greiginsydney/Intervalometerator/Raspberry Pi/default_image.JPG

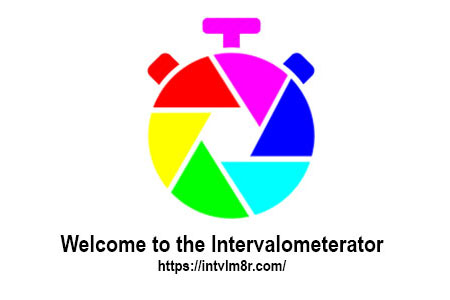
Raspberry Pi/default_image.JPG
