greiginsydney/Intervalometerator/docs/step1-setup-the-Pi.md

# Setup the Pi

If you're starting from scratch, start here at Step 1.

1. Prepare the memory card with the [32-bit Raspberry Pi OS 'Lite'](https://www.raspberrypi.org/software/operating-systems/) image. You want the "a port of Debian Trixie [or Bookworm] with no desktop environment" version.

> The ["Raspberry Pi Imager"](https://www.raspberrypi.org/software/) app can download and write the image to a memory card for you quickly and easily.

<p align="center">

 </p>

<p align="center">



</p>

2. Add HDMI, power and keyboard connections and turn it on. (You don't need a mouse for this, but add one if you're feeling so inclined).
3. The boot process ends at a login screen. The default credentials are `pi` / `raspberry`.
4. Login.
5. Now we'll perform the basic customisation steps:
6. Run `sudo raspi-config`.
7. Select `(5) Localisation Options` then:
    * `(L3) - change keyboard layout`
    I've never needed to do anything but accept the defaults here. I found the Pi stopped responding for >10s after selecting "no compose key", so just wait for it and it will take you back to the main page.
8. Return to (5) and set `(L2) the timezone`. Select the appropriate options and you'll be returned to the menu.
9. Select `(3) - Interfacing Options`
    * `(P2) Enable SSH` and at the prompt "Would you like the SSH server to be enabled?" change the selection to `<Yes>` and hit return, then return again at the `OK`.
    
10. This step intentionally left blank. ;-)
11. Select `(1) System Options` and `(S4) Hostname` and give the Pi a recognisable hostname.
12. If you're building this onto a Pi with a wired network connection instead of WiFi, skip the next step. Resume at Step 14.
13. Select `(1) System Options` and `(S1) Wireless LAN`. At this stage we'll be a wifi *client*. When prompted:

    * Select your country
    * Enter the local SSID and passphrase (password). Note that the Pi Zero W's radio is limited to 2.4G, so any attempts to connect to a 5G network will fail.
14. Navigate to `Finish` and DECLINE the prompt to reboot.
15. Run `ifconfig`. In the output, look under "eth0" for wired and "wlan0" for WiFi. There should be a line starting with "inet" followed by an IP address. The absence of this means you're not on a network.

16. Assuming success above, you'll probably want to set a static IP. If you're OK with a dynamic IP (or at least are for the time being) jump to Step 19 and a reboot.

17. From 'Bookworm', the Pi uses Network Manager to manage IP addresses.\[[1](#1-set-a-static-ip-address-on-raspberry-pi-os-bookworm)\]

18.1 Run `sudo nmcli -p connection show` to show the available network interfaces:

```txt
pi@raspberrypi:~ $ sudo nmcli -p connection show
======================================
  NetworkManager connection profiles
======================================
NAME              UUID                                  TYPE      DEVICE
----------------------------------------------------------------------------------------------------------------
mywifissid        09123456-6ac4-4cf7-8154-701234567892  wifi      wlan0
lo                5612345d-ffff-4ee8-8ef9-12345678990f  loopback  lo
pi@raspberrypi:~ $
```

18.2 Now execute these three commands in turn, replacing the network name and dummy values here with your own:

```txt
sudo nmcli con mod "mywifissid" ipv4.addresses 10.0.0.220/24 ipv4.method manual
sudo nmcli con mod "mywifissid" ipv4.gateway 10.0.0.1
sudo nmcli con mod "mywifissid" ipv4.dns "10.0.0.1"
```

> If you have more than one DNS server (the last command above), add them all inside the quotes with a space separating each.

19. Reboot the Pi to pickup its new IP address and lock in all the changes made above, including the change to the hostname: `sudo reboot`

20. After it reboots, check it's on the network OK by typing `ifconfig` and check the output now shows the entries you added in Step 18.2.
(Alternatively, just see if it responds to pings and you can SSH to it on its new IP).

## Remote config via SSH

At this point I abandoned the keyboard and monitor, continuing the config steps from my PC.

21. SSH to the Pi using your preferred client. If you're using Windows 10 you can just do this from a PowerShell window: `ssh <TheIpAddressFromStep18> -l pi` (Note that's a lower-case L).
22. You should see something like this:
```txt
The authenticity of host '192.168.44.1 (192.168.44.1)' can't be established.
ECDSA key fingerprint is SHA256:Ty0Bw6IZqg1234567899006534456778sFKT6QakOZ5PdJk.
Are you sure you want to continue connecting (yes/no)?
```
23. Enter `yes` and press Return
24. The response should look like this:
```txt
Warning: Permanently added '192.168.44.1' (ECDSA) to the list of known hosts.
pi@192.168.44.1's password:
```
25. Enter the password and press Return.
26. It's STRONGLY recommended that you change the password. Run `passwd` and follow your nose.

## Here's where all the software modules are installed. This might take a while:

27. First let's make sure the Pi is all up-to-date:
```txt
sudo apt-get update && sudo apt-get upgrade -y
```

> If this ends with an error "Some index files failed to download. They have been ignored, or old ones used instead." just press up-arrow and return to retry the command. You want to be sure the Pi is healthy and updated before continuing.

> If however you encounter an error saying a certificate is out of date or not valid yet, check that the Pi's real-time clock is correct. `date` on its own will show the date, and you'll set it with this syntax: `sudo date -s '2024-01-09 11:04:00 AEDT'`.

28. `sudo reboot`

Your SSH session will end here. Wait for the Pi to reboot, sign back in again and continue.

29.1 Confirm your current version of python:

```txt
python3 --version
```
The output should look like this, which confirms python 3.13 (ignore the .5):
```txt
Python 3.13.5
```
(The above is correct for Trixie. Bookworm will report 3.11.2. The process is the same but adjust the number below accordingly.)

29.2 Update the following command if required with that of the same version number:

```txt
sudo apt install python3.13-venv -y
```
```txt
python3 -m venv venv
```
```txt
source venv/bin/activate
```

30. We need to install git so we can download the repo from GitHub:

```
sudo apt-get install git -y
```

29.4. This downloads the repo, dropping the structure into a subdirectory called `Intervalometerator`:

```txt
cd ~
git clone --depth=3 https://github.com/greiginsydney/Intervalometerator
```

> Advanced tip: if you're testing code and want to install a new branch direct from the repo, add `-b <branchName>` on the end of the line.

30. Now we need to move the setup.sh script file into its final location:

```txt
mv -fv "Intervalometerator/Raspberry Pi/setup.sh" ~
``` 

31. All the hard work is done by the script, but it needs to be made executable first:

```txt
sudo chmod +x setup.sh
```

32. Now run it!
```txt
sudo ./setup.sh start
```

33. First up you'll be presented with a menu to choose which of the upload/transfer options to install:

```txt
====== Select Upload/Transfer options =======
An 'X' indicates the option will be installed

1. [X] SFTP
2. [X] Dropbox
4. [X] rsync

Press 1, 2 or 4 to toggle the selection.
Press return on its own to continue with the install
```

Accept the defaults just by pressing return on its own, or choose 1, 2 or 4 (then return) to de-select the options that aren't relevant to you. (You can always install them later if the need arises).

> If you choose ALL the options (the default), this step now takes **over an hour** to complete, depending on how slow your Internet connection is. (As at March 2020.) SFTP is the real time-killer here.

> If any step fails, the script will abort and on-screen info should reveal the component that failed. You can simply re-run the script at any time (up-arrow / return) and it will simply skip over those steps where no changes are required. There are a lot of moving parts in the Raspbian/Linux world, and sometimes a required server might be down or overloaded. Time-outs aren't uncommon, hence why simply wait and retry is a valid remediation action.

> If libgphoto throws errors, run `apt-cache search libgphoto2` & it should reveal the name of the "development" version, which you will need to edit back into the script before your repeat attempt at this step.

33.1 It's a rare occurrence, but you might encounter this redis prompt:

```txt
Configuration file '/etc/redis/redis.conf'
 ==> Modified (by you or by a script) since installation.
 ==> Package distributor has shipped an updated version.
   What would you like to do about it ?  Your options are:
    Y or I  : install the package maintainer's version
    N or O  : keep your currently-installed version
      D     : show the differences between the versions
      Z     : start a shell to examine the situation
 The default action is to keep your current version.
*** redis.conf (Y/I/N/O/D/Z) [default=N] ?
```

The correct response is 'Y': we'll accept the new version. (The setup script will reinstate the customisation later).

34. If all goes well, you'll be presented with a prompt to reboot:
```txt
Exited install_apps OK.
Reboot now? [Y/n]:
```
Pressing return or anything but n/N will cause the Pi to reboot.

35. After the Pi has rebooted, sign back in again and resume. The next step is to re-run the script, but with a new switch:
```txt
sudo ./setup.sh web
```

36. The script will now move some of the supporting files from the repo to their final homes, and edit some of the default config in the Pi. 

It will output its progress to the screen:
```txt
pi@raspberrypi:~ $ sudo ./setup.sh web
mkdir: created directory 'photos'
mkdir: created directory 'preview'
mkdir: created directory 'thumbs'
'intvlm8r.service' -> '/etc/systemd/system/intvlm8r.service'
'intvlm8r' -> '/etc/nginx/sites-available/intvlm8r'
```

37. You will be asked to provide a username and password for the web interface. The default login name is 'admin', and the script generates a random 8-character password of four letters and four numbers. Accept the defaults if you like, but preferably come up with your own. (You should DEFINITELY change these for longer, more complicated ones if the intvlm8r is connected to the Internet or a network where anyone else might find it.)

```txt
Change the website's login name: admin
Change the website's password  : abcd1234
```

38. If your Pi will have no network connectivity once it's deployed, it will need its real time clock set each time it boots (as the clock is volatile - it's not battery-backed). 

```txt
NTP is currently active. NTP is our master time source.

Does the Pi have network connectivity?
If so, can we use NTP as our master time source? [Y/n]:
```

If you respond 'n' to the prompt, the script will disable the Pi's internal NTP Client. The provided "setTime.py" script will run when-ever the Pi boots, reading the real time from the Arduino and using this to set the Pi's own internal clock.

If you respond 'Y', the Pi shall query an NTP source at boot and also at 3:30am each day, updating the Arduino with the correct time. (The overnight update only applies if the Pi is set to always run, and captures any changes that might have been made due to Daylight Saving Time ahead of the next day's shooting).

>You can change this at any time by running `sudo ./setup.sh time`.

39. If all goes well, you'll be presented with a prompt to reboot:
```txt
Exited install_website OK.
Reboot now? [Y/n]:
```
Pressing return or anything but n/N will cause the Pi to reboot.

40. You're in business!  After the Pi reboots you should be able to browse to its IP address, where you'll be presented the message "You need to sign in before you can access that page!" and the login form.

41. Login with the credentials you set in Step 37. You can change those or add new login/password pairs by editing the /www/intvlm8r.py script.

## Next steps are:
- Add an SSL certificate:
	- [Use Lets Encrypt](/docs/step2-setup-the-Pi-lets-encrypt.md)
	- [Public or Private PKI](/docs/step2-setup-the-Pi-public-or-private-pki.md)
- [Setup the Pi as a Wifi Access Point](/docs/step3-setup-the-Pi-as-an-access-point.md)

<br>

## References
#### [1] [Set a static IP Address on Raspberry Pi OS Bookworm](https://www.abelectronics.co.uk/kb/article/31/set-a-static-ip-address-on-raspberry-pi-os-bookworm)
<hr >
