greiginsydney/Intervalometerator/docs/FAQ.md

# Frequently Asked Questions

- [Where do I change the website's login name and/or password?](https://github.com/greiginsydney/Intervalometerator/blob/master/docs/FAQ.md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)
- [How can I add more users to the list of website logins?](https://github.com/greiginsydney/Intervalometerator/blob/master/docs/FAQ.md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)
- [Can I move the intvlm8r off port 80 or 443?](https://github.com/greiginsydney/Intervalometerator/blob/master/docs/FAQ.md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)
- [My camera and/or Pi are running low on storage. How can I delete old images?](https://github.com/greiginsydney/Intervalometerator/blob/master/docs/FAQ.md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)
- [Can I copy/transfer images more than once per day?](https://github.com/greiginsydney/Intervalometerator/blob/master/docs/FAQ.md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)
- [Can I pause the shooting schedule during the day (e.g. at lunchtime)?](https://github.com/greiginsydney/Intervalometerator/blob/master/docs/FAQ.md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)
- [Does the intvlm8r support Daylight Saving Time?](https://github.com/greiginsydney/Intervalometerator/blob/master/docs/FAQ.md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)
- [Can I install the intvlm8r under another user, not 'pi'?](https://github.com/greiginsydney/Intervalometerator/blob/master/docs/FAQ.md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)
- [Can the intvlm8r connect to multiple WiFi networks?](https://github.com/greiginsydney/Intervalometerator/blob/master/docs/FAQ.md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)
- [Why can't I set the camera's time correctly?](https://github.com/greiginsydney/Intervalometerator/blob/master/docs/FAQ.md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)

<br>

<hr>

## Where do I change the website's login name and/or password?

If you only have one login (the default configuration), you can use the setup script with the "login" switch. This prompts you to change the _first_ login in the file:

```text
pi@Model3B:~ $ sudo ./setup.sh login
Change the website's login name: admin1
Change the website's password  : password1
"exit 0" command failed with exit code 0.   <-- ignore this. An exit code of 0 is good in Python-land.
pi@Model3B:~ $
```

The alternative is to manually edit the main python script (`sudo nano ~/www/intvlm8r.py`). Around line 120 is "# Our user database".

<br>

[Top](https://github.com/greiginsydney/Intervalometerator/blob/master/docs/FAQ.md)

## How can I add more users to the list of website logins?

This is done by adding new lines to the main python script (`sudo nano ~/www/intvlm8r.py`). Around line 120 is "# Our user database".

Add more users in this format:

```text
# Our user database:
#users = {'admin': {'password': '### Paste the hash of the password here. See the Setup docs ###'}}
users = {'admin': {'password': 'password'}}
users.update({'superuser': {'password': 'godmode'}})
users.update({'someoneElse': {'password': 'rand0mCharact3rs'}})
```
<br>

[Top](https://github.com/greiginsydney/Intervalometerator/blob/master/docs/FAQ.md)

## Can I move the intvlm8r off port 80 or 443?

Yes! It's as simple as changing the "listen" line in `/etc/nginx/sites-enabled/intlm8r` to the new port number. Oh, and don't forget to open the firewall and/or add a NAT translation rule for it.

In this example the intvlm8r now listens on port 8000:

```text
server {
    listen 8000 default_server;
    server_name intvlm8r intvlm8r.yourdomainname.com;

    location / {
        include proxy_params;
        proxy_pass http://unix:/home/pi/www/intvlm8r.sock;
    }
}
```
<br>

[Top](https://github.com/greiginsydney/Intervalometerator/blob/master/docs/FAQ.md)

## My camera and/or Pi are running low on storage. How can I delete old images?

### My camera is running low on storage

If you want to delete ALL the images from the camera, Jim's provided an example script that will do this, and I've created a symbolic link to his examples folder.

SSH to the Pi and login with your username (usually 'pi', without the quotes), and the password. If you skipped the step to change this, it will still be 'raspberry'.

Run these two commands: 

```bash
cd ~/examples
sudo python3 clear-space.py 95
```

The number after clear-space.py tells the script to keep deleting files until that percentage of space is free. I recommend you DON'T choose 100, because that's potentially unachievable and could cause the script to lock up.
<br>

[Top](https://github.com/greiginsydney/Intervalometerator/blob/master/docs/FAQ.md)

### Enable 'DeleteAftercopy' or 'DeleteAfterTransfer'

Hidden config options (stored in the INI file) will let you delete images off the camera after they've been safely transferred to the Pi, and after they've been safely uploaded to your nominated "off-box" destination.

This option isn't visible in the browser, so to change it you need to SSH to the Pi and edit the file there manually:
1. Edit the file intvlm8r.ini with `sudo nano ~/www/intvlm8r.ini`
2.	This opens the file in a basic text editor. Note that you can’t use your mouse, only the arrow keys to move around
3.	Move the cursor (which is usually at the top LH corner) to the end of the relevant 'DeleteAfter..' line – after the second ‘f’ in Off, then Backspace to delete the f’s and replace with an ‘n’. (Reverse that to change from On to Off)
4.	Type Control-X. The bottom of the screen will update to ask “Save modified buffer?”
5.	Press Y (on its own). The screen will prompt for the filename “File Name to Write: /home/pi/www/intvlm8r.ini”, which is giving you an opportunity to do a “Save As” and give it a new name. But we won’t.
6.	Hit return and you’re done.

Set the two highlighted options On or Off as required. If the option's not already there, just add the line in by hand, like in this example file:

<pre>
[Global]
file created = 05 Jan 2023
thumbscount = 20

[Transfer]
tfrmethod = Dropbox
dbx_token = thequickbrownfoxjumpsoverthelazydogorsomething
transferday = Daily
transferhour = 00
sftpserver = 20.20.20.20
sftpuser = intvlm8r
sftppassword = mysecretsftppassword
sftpremotefolder = upload/GreyBox/
<b>deleteaftertransfer = On</b>

[Copy]
copyday = Daily
copyhour = 00
<b>deleteaftercopy = On</b>
</pre>

<br>

[Top](https://github.com/greiginsydney/Intervalometerator/blob/master/docs/FAQ.md)

## Can I copy/transfer images more than once per day?

The web interface only supports one copy (from the camera) and transfer (from the Pi) per day, but it's easy to add more by adding extra occurrences to the "crontable".

> The only caveat here is that the Pi is set to "Always On" on the system maintenance page.

Here's what the crontable looks like by default:

``` python
pi@Model3B:~ $ crontab -l
0 * * * * /usr/bin/python3 /home/pi/www/cameraTransfer.py 2>&1 | logger -t cameraTransfer
0 * * * * /usr/bin/python3 /home/pi/www/piTransfer.py 2>&1 | logger -t piTransfer

```

The `0 * * * *` at the start of the line instructs the Pi to run python3 and the related script when minute = 0, every hour, every day. As defined here, the script runs at the top of every hour, checking if this hour and this day is the correct time to execute a copy or transfer before proceeding. If not, the script will exit and wait for the next hour.

You can edit the crontable with `crontab -e` and give it more things to do. Here I've added a copy at 15 minutes past the hour (every hour, every day), and a transfer at 15 minutes to:

```python
pi@Model3B:~ $ crontab -l
0 * * * * /usr/bin/python3 /home/pi/www/cameraTransfer.py 2>&1 | logger -t cameraTransfer
0 * * * * /usr/bin/python3 /home/pi/www/piTransfer.py 2>&1 | logger -t piTransfer

15 * * * * /usr/bin/python3 /home/pi/www/cameraTransfer.py copyNow 2>&1 | logger -t cameraTransfer
45 * * * * /usr/bin/python3 /home/pi/www/piTransfer.py copyNow 2>&1 | logger -t piTransfer
```

Note the trick is the addition of the 'copyNow' switch which forces the script to always copy/transfer, ignoring the value set in the web interface and read from the ini file.

> If you're using Nano as your editor, a quick way to copy a line is ^K then ^U. That deletes the line your cursor is on and reinstates it - but it leaves a copy on the 'clipboard' (to borrow a Windows term). Navigate to where you want the line copied and ^U again - but don't forget to change the time and add the copyNow switch.
<br>

[Top](https://github.com/greiginsydney/Intervalometerator/blob/master/docs/FAQ.md)

## Can I pause the shooting schedule during the day (e.g. at lunchtime)?

The browser interface and the underlying code in both the Pi and Arduino don't allow two time schedules per day, nor one schedule with a break for lunch, and it would require a significant re-write to accommodate this.

That being said, a "lunchtime kludge" exists in the Arduino code (from v4.0.1) that will deliver this functionality. As it's fixed in the Arduino it's not something that can be changed from the Pi or through the browser interface, so turning it on or off, or changing the duration of the lunch break will necessitate opening the intvlm8r case and connecting a programming cable to the Arduino. The Pi isn't aware if the "lunchtime kludge" is active, so its calculations of shots per day will be inaccurate as a result, although "Last Shot" and "Next Shot" will always show the correct values.

The "lunchtime kludge" is commented-out by default. If you want to pause shooting for lunch, just un-comment the final five lines shown below (the "if" loop) by deleting the double slashes ('//') at the start of each line. Set the value of `if (nextHour == 12)` to the hour that the lunch break starts, and then set `nextHour = 13;` and `nextShot = 59;` to be one minute before you want shooting to resume. (In this example, a 2-hour lunch break starts at noon.)

```
// Lunchtime kludge
  // Un-comment this code and set nextHour and nextShot values as appropriate
  //  if (nextHour == 12)
  //  {
  //     nextHour = 13;
  //     nextShot = 59;
  //  }
```

If you only want to break for an hour, you can delete the `nextHour = 13;` line altogether and leave the nextShot minute at 59. If you only want a 30 minute lunch, delete the `nextHour = 13;` line (or leave it commented-out), change `nextShot` to 29, and the shooting schedule will recommence from 30 minutes past the current hour.

> This code runs at the start of the lunch break and tricks the intvlm8r into thinking it's already taken the shots that it would have during lunch. It then sets the next alarm time - the next shot to be taken - for the time immediately after lunch.
<br>

[Top](https://github.com/greiginsydney/Intervalometerator/blob/master/docs/FAQ.md)

## Does the intvlm8r support Daylight Saving Time?

It depends.

If your intvlm8r is running off-grid, disconnected from the outside world, it relies on the battery-backed red ["DeadOn RTC"](https://www.sparkfun.com/products/10160) board as the master real-time clock, which is in itself not aware of timezone and thus when to adjust for DST. In such a config, manual intervention will be required as you enter and return from DST.

DST is catered for automatically if the intvlm8r has network connectivity, although this assumes you set the correct timezone in [setup step 8](https://github.com/greiginsydney/Intervalometerator/blob/master/docs/step1-setup-the-Pi.md) and answered Yes to the NTP question:

```python
NTP Step. Does the Pi have network connectivity? [Y/n]:
```

If the Pi is set to always run, a cron job that fires every day at midnight will perform a sync of the time and date from the Pi to the Arduino. Here's an example of that from the /home/pi/setTime.log file:

```python
2021/06/14 00:00:02 systemd-timesyncd = active. The Pi takes its time from NTP. Updating the Arduino to follow Pi time
2021/06/14 00:00:02 Response code = 200
2021/06/14 00:00:02 This is what I received: <p>Set Arduino datetime to 20210614000002</p>
2021/06/14 00:00:02 New Arduino time is 20210614000002
```
<br>

[Top](https://github.com/greiginsydney/Intervalometerator/blob/master/docs/FAQ.md)

## Can I install the intvlm8r under another user, not 'pi'?

Yes. Just create your new user (with `sudo adduser newusername`) before you start the install process.

By default a new user can't `sudo` things without needing to provide their password, which breaks the setTime script. To address this, run `sudo visudo` and add this line to the *bottom* of the file:

```
newusername  ALL=(ALL) NOPASSWD:ALL
```

This lets 'newusername' execute ALL commands without needing to constantly re-type their password. I'd like to be able to tighten it up, but haven't been able to find the right command/syntax for the script to be able to run correctly - and it's not for a lack of trying.

<br>

[Top](https://github.com/greiginsydney/Intervalometerator/blob/master/docs/FAQ.md)

## Can the intvlm8r connect to multiple WiFi networks?

Yes: this is a really useful way of being able to setup a new intvlm8r on your workbench and then take or ship it to site without needing to make further config changes.

### - Old method (up to Bullseye):

All you need to do is edit /etc/wpa_supplicant/wpa_supplicant.conf (`sudo nano /etc/wpa_supplicant/wpa_supplicant.conf`) and add the extra network(s), like shown in this example:

~~~ bash
ctrl_interface=DIR=/var/run/wpa_supplicant GROUP=netdev
update_config=1

network={
        ssid="myOfficeNetwork"
        psk=myWiFiPassword!
        priority=1
}

network={
        ssid="myCaptureSiteNetwork"
        psk=thisIsMyPassword
        priority=4
}
~~~

If you omit the 'priority' lines, both networks are deemed the same priority, and the Pi will use the one with the stronger signal. As shown here, if both networks are present, the "myCaptureSiteNetwork" will be used, as it has the numerically higher priority number.
<br>

### - New method (bookworm+):

bookworm and its successors use Network Manager Command Line Interface ('nmcli') for the administration of networks and network interfaces.

<TODO: a more detailed walkthrough here>

Reference: https://unix.stackexchange.com/a/547531/578745

[Top](https://github.com/greiginsydney/Intervalometerator/blob/master/docs/FAQ.md)

## Why can't I set the camera's time correctly?

You're not alone in finding this a challenge. The interaction of gphoto2, your camera, and the timezone set in the Pi can sometimes make it difficult to have the camera correctly reflect your local time.



When you check "Set camera date/time", the new time and date that are sent to the camera depend on how the camera and gphoto2 interact.

Canon cameras usually accept two methods, and the default method passes the Pi's time to the camera, _but as UTC instead of the local timezone_ and any timezone offset you specify on the page is ignored.

Selecting "Alt camera time mode" always passes the "adjusted date/time" to the camera, but sometimes this doesn't apply correctly and a whacky date - maybe decades out - is returned.

If neither of the above two methods work, here's another you can try:
1. Set the Pi's time to the required value for the camera, adjusting the timezone offset as required;
2. Set the camera's time with only the "Set camera date/time" checkbox selected;
3. If that's successful, reset the Pi back to your correct time.

If you're still having no luck, please raise an [issue](https://github.com/greiginsydney/Intervalometerator/issues) and I'll work with you to find a resolution. (Have you checked the camera's firmware is the latest version?)

[Top](https://github.com/greiginsydney/Intervalometerator/blob/master/docs/FAQ.md)
