greiginsydney/Intervalometerator/(threads)

Thread 4 (2018-11-21):

Design a PCB

greiginsydney, 2018-11-21:
Is there demand for a PCB (whether art or a completed/assembled board)?

greiginsydney, 2019-06-19:
Closing. The PCB is available now on eBay:
https://www.ebay.com.au/itm/Intervalometerator-time-lapse-controller-PCB-only/264353662332

greiginsydney, 2021-09-24:
The schematic is here:
https://github.com/greiginsydney/Intervalometerator/blob/master/docs/intvlm8r_v11.11_circuit.pdf

\- G.

Closed 2019-06-19.

Thread 8 (2018-11-21):

Add telemetry / health monitoring

greiginsydney, 2018-11-21:
Add some Azure IoT-style telemetry, so you can remotely monitor it. Generate an alarm if it stops taking photos or fails to report in.

cadpix, 2020-07-04:
This would be very useful, our Intvlm8r is running on solar in a remote location to see a building go up over two years. We have it working over 4G and we can access the UI (via remote.it) and it can upload the pics to dropbox which works well.
It would be great to be able monitor the system / battery voltage and set a low threshold warning so we can anticipate a 12v battery replacement if needed.
Our setup also utilises a PTC heater to defrost the front glass. This only draws around an amp and clears the frost in winter, being able to see some temp data would be useful for anticipating when to kick this in or maybe this could be switched on by the RPI in the future? We currently use a digital timer switch to switch the heat on but this would be a fantastic feature addition to the Intvlm8r.

aerialvideographyuk, 2021-04-07:
I am also trying to get things working over a 4g wifi dongle and over traditional wifi but without port forwarding.  I removed the fixed ip settings on the pi and installed remote.it on the pi.  I could then set up a connection for ssh, http on port 80 and https on port 443. everything appeared to be working fine as I was able to access the camera via remote.it and change settings etc.  However I then noticed that no photo's were getting transferred to dropbox. When I checked the photos have stayed on the camera and not gone to the pi.  attached are the cameraTransfer.log and the gunicorn.error files. Any help appreaciated.
[cameraTransfer.log.txt](https://github.com/greiginsydney/Intervalometerator/files/6274373/cameraTransfer.log.txt)
[gunicorn.error.txt](https://github.com/greiginsydney/Intervalometerator/files/6274375/gunicorn.error.txt)

greiginsydney, 2021-08-01:
Resolved with the addition of 'heartbeating' in release 4.2.0.

techydude, 2021-10-04:
Hey @cadpix , a few questions to clarify:

> It would be great to be able monitor the system / battery voltage and set a low threshold warning so we can anticipate a 12v battery replacement if needed.

(q1) are you saying you setup a system with a battery, no other forms of power input, and need to periodically go to site and replace the battery?  If so, have you had any (supre-system / offboard) means of ascertaining battery state-of-charge, or do you just work out after some time how long the battery lasts and adjust your site visit rate?

> Our setup also utilises a PTC heater (common in security cameras and cheap too!) to defrost the front glass on the housing. This only draws around an amp and clears the frost in winter, being able to see some temp data would be useful for anticipating when to kick this in or maybe this could be switched on by the RPI in the future? We currently use a digital timer switch to switch the heat on but this would be a fantastic feature addition to the Intvlm8r.

(q2) 1 Amp * battery voltage (whatever that is, let's say a 12V SLA) is 12 Watts, which is an awful lot.  Do you have some way to only turn this front glass heater on just (a few minutes?) before a shot's about to be taken?  Or do you leave it on permanently when the weather's cold? (which suggests you need an effing big battery in winter! lol)

(q3) temp sensing:  do you want to know the tempeature inside the box, or outside the box, or both?  (I think Greig's add in a internal temp sensor telemetry in recent released, long after you posted your comment) in terms of estimating the need to apply a heater to the glass, I suspect you'd need to know both temps, and perhaps the humidity inside the box too, to work out how close you are to the dew temp, right?

Closed 2021-08-01.

Thread 12 (2018-12-03):

Allow overnight shoots (where end time < start time)

greiginsydney, 2018-12-03:
The current functionality restricts you to same-day shoots, where the end time is greater than the start time.

To allow overnight shoots we'll need to:
- remove the `if endHour <= startHour` test in intervalometerPOST().
- update the logic in the Arduino's SetAlarm1 func.

\- G.

greiginsydney, 2021-12-03:
Fixed in [release 4.4.0](https://github.com/greiginsydney/Intervalometerator/releases/tag/v4.4.0)

Closed 2021-12-03.

Thread 22 (2019-06-04):

Use a background thread to copy files from the camera

greiginsydney, 2019-06-04:
The webUI will often crash with a [502 - Bad Gateway](https://github.com/greiginsydney/Intervalometerator/wiki/Troubleshooting#502---bad-gateway) error after initiating a "Copy now" request from the /Transfer page. The more images there are to copy, the greater the likelihood of this occurring. (This also takes each time the Pi is started and on a schedule if the user has created a cron job).

The issue is that "copy_files(camera)" in [intvlm8r.py](https://github.com/greiginsydney/Intervalometerator/blob/master/Raspberry%20Pi/intvlm8r.py)  holds the script in a loop until it's finished copying, and if there are a lot of images Gunicorn will eventually time out.

The (a?) fix will be to re-write copy_files so it runs as a background task.

The camera will still be busy for the duration, but the rest of the web UI will run OK, and the camera's non-availability will be flagged with a ["Could not claim the USB device"](https://github.com/greiginsydney/Intervalometerator/wiki/Troubleshooting#could-not-claim-the-usb-device) error.

Any takers?

FernandaRamosTL, 2019-09-20:
Dear Greig, good afternoom. My name is Fernanda, and I am a time-lapse artist based in Rio. I have been wondering for a long time on how to build my own intervalometer, and I must congratulate you for your job. I will follow your tutorials and try to build the intervalometer. I use some other solutions for my comercial work. You can see my films at jugularfilmes.com
Dear Greig: I believe that this problem is due to the amount of data at the camera memory card. The best thing to do is if after the pictures are transfered to PI, they are deleted from the camera. Do you think you can improve the code to do it? Delete the images once a day, and the problem should be gone. I know from personal experience that many files on the camera make the comunication via USB very dificult. I am not a programer, I am just a filmmaker who is making animation with photos and timelapse films since 1997, but even when you connect windows or mac to a camera with many many files it is very very dificult to copy it to the computer.
Well, I would love to know you better. Please visit my website and drop me an email if you want to be in touch.

FernandaRamosTL, 2019-09-21:
Hi, I sent you a message at linked in.

greiginsydney, 2020-11-28:
Fixed in release [v4.0.0](https://github.com/greiginsydney/Intervalometerator/releases/tag/v4.0.0) with the addition of Celery & Redis.

Closed 2020-11-28.

Thread 28 (2019-08-15):

Enclosure design

AnatolySoloviov, 2019-08-15:
Hi. I can't message Greig or anyone else so I'm leaving it here.
For me it would be interesting to work on enclosure design of such device. I know, it's low-cost DIY thing but we can consider 3D printing.
My idea is to make sealed enclosure with mounting features and decent structural strength. I don't know if anyone wants it. Just an idea.

greiginsydney, 2019-08-18:
Hey @AnatolySoloviov, we'd welcome that for sure. I guess part of the challenge is to make it able to fit a range of cameras and batteries.

Hopefully others will add some comments here to see if there's sufficient interest.

- Greig.

AnatolySoloviov, 2019-08-19:
Sometimes I'm doing design of things that will never be produced. Just for fun, it's different from doing job.

I don't know about different cameras, maybe they have some unified standard and we'll be able to mount them in relatively similar way inside. In worst case we can try to mount everything (camera module and lens) by bayonet. I'd say at first we should consider most optimal and cost-effective hardware set and then check which other cameras we can put there with adjustments.

I will need info about hardware geometry.

AnatolySoloviov, 2019-08-22:
Is there a way to use only necessary parts of the camera? If we put entire camera there, the enclosure needed only to protect Rpi and battery. I understand that for DIY project it is simple to put complete camera in box. Maybe I overestimated the need of new enclosure.
I just wanted to make something interesting, but now I think it may end up as another abandoned design. It wouldn't compete with widely available box with holes.

BTW, if the device uses Rpi, did you consider special camera modules instead of consumer cameras? There's a lot of builds based on something like Sony IMX sensors, MFT or smaller. In some cases it may be more cost effective than using consumer product. I don't know about sensor size requirements for particular application. I'm just thinking about using essential components.

Anyway. If we put camera, Rpi and battery, what exactly we should improve comparing to current box? Sealing for the lens? More flexible and universal external mounting of enclosure?

OzRocky, 2019-08-23:
The core of this project was for it to be able to use a standard DSLR camera for a long term time-lapse, exploiting the quality of the larger sensors and range of lenses. There are already quite a few commercial products out there based around small sensors ranging from just a couple of hundred dollars up. The problem is that the small sensors with their basic lenses just can’t deliver the image quality of a DSLR.

So any box will need to be able to contain a DSLR with its lens, the circuit board and battery. So far, the best option I’ve come up with is to use a Pelican case. In fact, many of the high priced commercial DSLR time-lapse systems are also built in modified Pelican cases.

The hardest part about using the Pelican case is the opening for the lens. Gluing in a standard lens adapter to screw a filter to is the best option that I could come up with, but there may well be better ways of doing it.

greiginsydney, 2019-09-08:
Closing.

Closed 2019-09-08.

Thread 30 (2019-09-08):

cameraTransfer.py & setTime.py not working

greiginsydney, 2019-09-08:
cameraTransfer.log reveals "login required", so I need to somehow bypass the "@login_required" decorator on /transfer/CopyNow.

greiginsydney, 2019-09-09:
Closed with merge bd47401

Closed 2019-09-09.

Thread 32 (2019-09-15):

If you're talking to the Pi and reboot it, the Arduino will kill its power

greiginsydney, 2019-09-15:
The Arduino code that monitors the Pi's running status doesn't test whether the Pi is MEANT to still be powered - it sees the line goes low, thinks the Pi has gone to sleep, and pulls its power.

I just need to add an extra test to hold this off (ignoring it) if the Arduino hasn't commenced the shutdown process.

greiginsydney, 2019-12-25:
Soak-testing prior to merging into Main.

Closed 2020-01-13.

Thread 39 (2020-01-26):

Adding Lets Encrypt breaks setTime & cameraTransfer cron-jobs

greiginsydney, 2020-01-26:
If the LE setup "certbot" redirects port 80 traffic to 443 it breaks the two places where the intvlm8r calls itself as localhost to do stuff:
- setTime
- cameraTransfer

cameraTransfer.log reports "URL error. Reason = [Errno -2] Name or service not known".

(Thank you Markus for bringing this to my attention).

Closed 2020-01-27.

Thread 41 (2020-02-15):

502 Bad Gateway

cadpix, 2020-02-15:
Hi there,
Really keen to get the Intervalometerator working! What a great project!
Have built everything onto the pcb and are now having one minor issue.
After following the Raspberry setup instructions to the dot and then pointing my browser at the pi IP I am greeted with '502 Bad Gateway' nginx/1.14.2.
I have repeated the install process twice to be sure.
I have restarted nginx and given it time to boot but still have the same issue.
Have also done : sudo nginx -t
Get response:
nginx: the configuration file /etc/nginx/nginx.conf syntax is ok
nginx: configuration file /etc/nginx/nginx.conf test is successful

Directing the browser to ip:8080 shows up 'Welcome to nginx! If you see this page, the nginx web server is successfully installed and working. Further configuration is required.'
Would be grateful if you could assist in getting me past this bump in the setup!
Thanks

greiginsydney, 2020-02-16:
Hey thanks for your interest in the project, and sorry for the bugs. Hopefully this won't be too hard to resolve.

Check out the gunicorn.error file @ /home/pi/www. It will usually point to the offending line number of the code bug. Please post the results here in case it's something that needs to be fixed back in the repo.

- Greig.

cadpix, 2020-02-16:
Hi Greig,

Thanks for the help, I've had a look at the log and I can see a few errors in there so thought might as well share it here as you will probably have a better idea of what to do than me.

Let me know if you need any more details, happy to contribute where I can.

[2020-02-15 17:33:56 +0000] [423] [DEBUG] Current configuration:
  config: None
  bind: ['unix:intvlm8r.sock']
  backlog: 2048
  workers: 3
  worker_class: sync
  threads: 1
  worker_connections: 1000
  max_requests: 0
  max_requests_jitter: 0
  timeout: 300
  graceful_timeout: 30
  keepalive: 2
  limit_request_line: 4094
  limit_request_fields: 100
  limit_request_field_size: 8190
  reload: True
  reload_engine: auto
  reload_extra_files: []
  spew: False
  check_config: False
  preload_app: False
  sendfile: None
  reuse_port: False
  chdir: /home/pi/www
  daemon: False
  raw_env: []
  pidfile: None
  worker_tmp_dir: None
  user: 1000
  group: 33
  umask: 7
  initgroups: False
  tmp_upload_dir: None
  secure_scheme_headers: {'X-FORWARDED-PROTOCOL': 'ssl', 'X-FORWARDED-PROTO': 'https', 'X-FORWA$
  forwarded_allow_ips: ['127.0.0.1']
  accesslog: None
  disable_redirect_access_to_syslog: False
  access_log_format: %(h)s %(l)s %(u)s %(t)s "%(r)s" %(s)s %(b)s "%(f)s" "%(a)s"
  errorlog: /home/pi/www/gunicorn.error
  loglevel: debug
  capture_output: False
  logger_class: gunicorn.glogging.Logger
  logconfig: None
  logconfig_dict: {}
  syslog_addr: udp://localhost:514
  syslog: False
  syslog_prefix: None
  syslog_facility: user
  enable_stdio_inheritance: False
  statsd_host: None
  dogstatsd_tags:
  statsd_prefix:
  proc_name: None
  default_proc_name: wsgi:app
  pythonpath: None
  paste: None
  on_starting: <function OnStarting.on_starting at 0xb5dac4f8>
  on_reload: <function OnReload.on_reload at 0xb5dac588>
  when_ready: <function WhenReady.when_ready at 0xb5dac618>
pre_fork: <function Prefork.pre_fork at 0xb5dac6f0>
  post_fork: <function Postfork.post_fork at 0xb5dac780>
  post_worker_init: <function PostWorkerInit.post_worker_init at 0xb5dac858>
  worker_int: <function WorkerInt.worker_int at 0xb5dac8e8>
  worker_abort: <function WorkerAbort.worker_abort at 0xb5dac978>
  pre_exec: <function PreExec.pre_exec at 0xb5daca08>
  pre_request: <function PreRequest.pre_request at 0xb5daca98>
  post_request: <function PostRequest.post_request at 0xb5dacae0>
  child_exit: <function ChildExit.child_exit at 0xb5dacbb8>
  worker_exit: <function WorkerExit.worker_exit at 0xb5dacc48>
  nworkers_changed: <function NumWorkersChanged.nworkers_changed at 0xb5daccd8>
  on_exit: <function OnExit.on_exit at 0xb5dacd68>
  proxy_protocol: False
  proxy_allow_ips: ['127.0.0.1']
  keyfile: None
  certfile: None
  ssl_version: 2
  cert_reqs: 0
  ca_certs: None
  suppress_ragged_eofs: True
  do_handshake_on_connect: False
  ciphers: None
  raw_paste_global_conf: []
  strip_header_spaces: False
[2020-02-15 17:33:56 +0000] [423] [INFO] Starting gunicorn 20.0.4
[2020-02-15 17:33:56 +0000] [423] [DEBUG] Arbiter booted
[2020-02-15 17:33:56 +0000] [423] [INFO] Listening at: unix:intvlm8r.sock (423)
[2020-02-15 17:33:56 +0000] [423] [INFO] Using worker: sync
[2020-02-15 17:33:56 +0000] [444] [INFO] Booting worker with pid: 444
[2020-02-15 17:33:56 +0000] [445] [INFO] Booting worker with pid: 445
[2020-02-15 17:33:56 +0000] [446] [INFO] Booting worker with pid: 446
[2020-02-15 17:33:57 +0000] [423] [DEBUG] 3 workers
[2020-02-15 17:34:03 +0000] [445] [ERROR] Exception in worker process
Traceback (most recent call last):
  File "/usr/local/lib/python3.7/dist-packages/gunicorn/arbiter.py", line 583, in spawn_worker
    worker.init_process()
  File "/usr/local/lib/python3.7/dist-packages/gunicorn/workers/base.py", line 119, in init_pro$
    self.load_wsgi()
  File "/usr/local/lib/python3.7/dist-packages/gunicorn/workers/base.py", line 144, in load_wsgi
    self.wsgi = self.app.wsgi()
  File "/usr/local/lib/python3.7/dist-packages/gunicorn/app/base.py", line 67, in wsgi
    self.callable = self.load()
  File "/usr/local/lib/python3.7/dist-packages/gunicorn/app/wsgiapp.py", line 49, in load
    return self.load_wsgiapp()
  File "/usr/local/lib/python3.7/dist-packages/gunicorn/app/wsgiapp.py", line 39, in load_wsgia$
    return util.import_app(self.app_uri)
  File "/usr/local/lib/python3.7/dist-packages/gunicorn/util.py", line 358, in import_app
    mod = importlib.import_module(module)
  File "/usr/lib/python3.7/importlib/__init__.py", line 127, in import_module
    return _bootstrap._gcd_import(name[level:], package, level)
  File "<frozen importlib._bootstrap>", line 1006, in _gcd_import
  File "<frozen importlib._bootstrap>", line 983, in _find_and_load
  File "<frozen importlib._bootstrap>", line 967, in _find_and_load_unlocked
  File "<frozen importlib._bootstrap>", line 677, in _load_unlocked
  File "<frozen importlib._bootstrap_external>", line 728, in exec_module
  File "<frozen importlib._bootstrap>", line 219, in _call_with_frames_removed
  File "/home/pi/www/wsgi.py", line 17, in <module>
    from intvlm8r import app
  File "/home/pi/www/intvlm8r.py", line 40, in <module>
from werkzeug.contrib.cache import SimpleCache
ModuleNotFoundError: No module named 'werkzeug.contrib'
[2020-02-15 17:34:03 +0000] [445] [INFO] Worker exiting (pid: 445)
[2020-02-15 17:34:03 +0000] [444] [ERROR] Exception in worker process
Traceback (most recent call last):
  File "/usr/local/lib/python3.7/dist-packages/gunicorn/arbiter.py", line 583, in spawn_worker
    worker.init_process()
  File "/usr/local/lib/python3.7/dist-packages/gunicorn/workers/base.py", line 119, in init_pro$
    self.load_wsgi()
  File "/usr/local/lib/python3.7/dist-packages/gunicorn/workers/base.py", line 144, in load_wsgi
    self.wsgi = self.app.wsgi()
  File "/usr/local/lib/python3.7/dist-packages/gunicorn/app/base.py", line 67, in wsgi
    self.callable = self.load()
  File "/usr/local/lib/python3.7/dist-packages/gunicorn/app/wsgiapp.py", line 49, in load
    return self.load_wsgiapp()
  File "/usr/local/lib/python3.7/dist-packages/gunicorn/app/wsgiapp.py", line 39, in load_wsgia$
    return util.import_app(self.app_uri)
  File "/usr/local/lib/python3.7/dist-packages/gunicorn/util.py", line 358, in import_app
    mod = importlib.import_module(module)
  File "/usr/lib/python3.7/importlib/__init__.py", line 127, in import_module
    return _bootstrap._gcd_import(name[level:], package, level)
  File "<frozen importlib._bootstrap>", line 1006, in _gcd_import
  File "<frozen importlib._bootstrap>", line 983, in _find_and_load
  File "<frozen importlib._bootstrap>", line 967, in _find_and_load_unlocked
  File "<frozen importlib._bootstrap>", line 677, in _load_unlocked
  File "<frozen importlib._bootstrap_external>", line 728, in exec_module
  File "<frozen importlib._bootstrap>", line 219, in _call_with_frames_removed
  File "/home/pi/www/wsgi.py", line 17, in <module>
    from intvlm8r import app
  File "/home/pi/www/intvlm8r.py", line 40, in <module>
    from werkzeug.contrib.cache import SimpleCache
ModuleNotFoundError: No module named 'werkzeug.contrib'
[2020-02-15 17:34:03 +0000] [444] [INFO] Worker exiting (pid: 444)
[2020-02-15 17:34:03 +0000] [446] [ERROR] Exception in worker process
Traceback (most recent call last):
  File "/usr/local/lib/python3.7/dist-packages/gunicorn/arbiter.py", line 583, in spawn_worker
    worker.init_process()
  File "/usr/local/lib/python3.7/dist-packages/gunicorn/workers/base.py", line 119, in init_pro$
    self.load_wsgi()
  File "/usr/local/lib/python3.7/dist-packages/gunicorn/workers/base.py", line 144, in load_wsgi
    self.wsgi = self.app.wsgi()
  File "/usr/local/lib/python3.7/dist-packages/gunicorn/app/base.py", line 67, in wsgi
    self.callable = self.load()
  File "/usr/local/lib/python3.7/dist-packages/gunicorn/app/wsgiapp.py", line 49, in load
    return self.load_wsgiapp()
  File "/usr/local/lib/python3.7/dist-packages/gunicorn/app/wsgiapp.py", line 39, in load_wsgia$
    return util.import_app(self.app_uri)
  File "/usr/local/lib/python3.7/dist-packages/gunicorn/util.py", line 358, in import_app
    mod = importlib.import_module(module)
  File "/usr/lib/python3.7/importlib/__init__.py", line 127, in import_module
    return _bootstrap._gcd_import(name[level:], package, level)
  File "<frozen importlib._bootstrap>", line 1006, in _gcd_import
  File "<frozen importlib._bootstrap>", line 983, in _find_and_load
  File "<frozen importlib._bootstrap>", line 967, in _find_and_load_unlocked
  File "<frozen importlib._bootstrap>", line 677, in _load_unlocked
  File "<frozen importlib._bootstrap_external>", line 728, in exec_module
  File "<frozen importlib._bootstrap>", line 219, in _call_with_frames_removed
  File "/home/pi/www/wsgi.py", line 17, in <module>
    from intvlm8r import app
File "/home/pi/www/intvlm8r.py", line 40, in <module>
    from werkzeug.contrib.cache import SimpleCache
ModuleNotFoundError: No module named 'werkzeug.contrib'
[2020-02-15 17:34:03 +0000] [446] [INFO] Worker exiting (pid: 446)
[2020-02-15 17:39:35 +0000] [337] [DEBUG] Current configuration:
  config: None
  bind: ['unix:intvlm8r.sock']
  backlog: 2048
  workers: 3
  worker_class: sync
  threads: 1
  worker_connections: 1000
  max_requests: 0
  max_requests_jitter: 0
  timeout: 300
  graceful_timeout: 30
  keepalive: 2
  limit_request_line: 4094
  limit_request_fields: 100
  limit_request_field_size: 8190
  reload: True
  reload_engine: auto
  reload_extra_files: []
  spew: False
  check_config: False
  preload_app: False
  sendfile: None
  reuse_port: False
  chdir: /home/pi/www
  daemon: False
  raw_env: []
  pidfile: None
  worker_tmp_dir: None
  user: 1000
  group: 33
  umask: 7
  initgroups: False
  tmp_upload_dir: None
  secure_scheme_headers: {'X-FORWARDED-PROTOCOL': 'ssl', 'X-FORWARDED-PROTO': 'https', 'X-FORWA$
  forwarded_allow_ips: ['127.0.0.1']
  accesslog: None
  disable_redirect_access_to_syslog: False
  access_log_format: %(h)s %(l)s %(u)s %(t)s "%(r)s" %(s)s %(b)s "%(f)s" "%(a)s"
  errorlog: /home/pi/www/gunicorn.error
  loglevel: debug
  capture_output: False
  logger_class: gunicorn.glogging.Logger
  logconfig: None
  logconfig_dict: {}
  syslog_addr: udp://localhost:514
  syslog: False
  syslog_prefix: None
  syslog_facility: user
  enable_stdio_inheritance: False
  statsd_host: None
  dogstatsd_tags:
  statsd_prefix:
  proc_name: None
  default_proc_name: wsgi:app
pythonpath: None
  paste: None
  on_starting: <function OnStarting.on_starting at 0xb5de04f8>
  on_reload: <function OnReload.on_reload at 0xb5de0588>
  when_ready: <function WhenReady.when_ready at 0xb5de0618>
  pre_fork: <function Prefork.pre_fork at 0xb5de06f0>
  post_fork: <function Postfork.post_fork at 0xb5de0780>
  post_worker_init: <function PostWorkerInit.post_worker_init at 0xb5de0858>
  worker_int: <function WorkerInt.worker_int at 0xb5de08e8>
  worker_abort: <function WorkerAbort.worker_abort at 0xb5de0978>
  pre_exec: <function PreExec.pre_exec at 0xb5de0a08>
  pre_request: <function PreRequest.pre_request at 0xb5de0a98>
  post_request: <function PostRequest.post_request at 0xb5de0ae0>
  child_exit: <function ChildExit.child_exit at 0xb5de0bb8>
  worker_exit: <function WorkerExit.worker_exit at 0xb5de0c48>
  nworkers_changed: <function NumWorkersChanged.nworkers_changed at 0xb5de0cd8>
  on_exit: <function OnExit.on_exit at 0xb5de0d68>
  proxy_protocol: False
  proxy_allow_ips: ['127.0.0.1']
  keyfile: None
  certfile: None
  ssl_version: 2
  cert_reqs: 0
  ca_certs: None
  suppress_ragged_eofs: True
  do_handshake_on_connect: False
  ciphers: None
  raw_paste_global_conf: []
  strip_header_spaces: False
[2020-02-15 17:39:35 +0000] [337] [INFO] Starting gunicorn 20.0.4
[2020-02-15 17:39:35 +0000] [337] [DEBUG] Arbiter booted
[2020-02-15 17:39:35 +0000] [337] [INFO] Listening at: unix:intvlm8r.sock (337)
[2020-02-15 17:39:35 +0000] [337] [INFO] Using worker: sync
[2020-02-15 17:39:35 +0000] [349] [INFO] Booting worker with pid: 349
[2020-02-15 17:39:35 +0000] [350] [INFO] Booting worker with pid: 350
[2020-02-15 17:39:35 +0000] [351] [INFO] Booting worker with pid: 351
[2020-02-15 17:39:35 +0000] [337] [DEBUG] 3 workers
[2020-02-15 17:39:42 +0000] [351] [ERROR] Exception in worker process
Traceback (most recent call last):
  File "/usr/local/lib/python3.7/dist-packages/gunicorn/arbiter.py", line 583, in spawn_worker
    worker.init_process()
  File "/usr/local/lib/python3.7/dist-packages/gunicorn/workers/base.py", line 119, in init_pro$
    self.load_wsgi()
  File "/usr/local/lib/python3.7/dist-packages/gunicorn/workers/base.py", line 144, in load_wsgi
    self.wsgi = self.app.wsgi()
  File "/usr/local/lib/python3.7/dist-packages/gunicorn/app/base.py", line 67, in wsgi
    self.callable = self.load()
  File "/usr/local/lib/python3.7/dist-packages/gunicorn/app/wsgiapp.py", line 49, in load
    return self.load_wsgiapp()
  File "/usr/local/lib/python3.7/dist-packages/gunicorn/app/wsgiapp.py", line 39, in load_wsgia$
    return util.import_app(self.app_uri)
  File "/usr/local/lib/python3.7/dist-packages/gunicorn/util.py", line 358, in import_app
    mod = importlib.import_module(module)
  File "/usr/lib/python3.7/importlib/__init__.py", line 127, in import_module
    return _bootstrap._gcd_import(name[level:], package, level)
  File "<frozen importlib._bootstrap>", line 1006, in _gcd_import
  File "<frozen importlib._bootstrap>", line 983, in _find_and_load
  File "<frozen importlib._bootstrap>", line 967, in _find_and_load_unlocked
  File "<frozen importlib._bootstrap>", line 677, in _load_unlocked
File "<frozen importlib._bootstrap_external>", line 728, in exec_module
  File "<frozen importlib._bootstrap>", line 219, in _call_with_frames_removed
  File "/home/pi/www/wsgi.py", line 17, in <module>
    from intvlm8r import app
  File "/home/pi/www/intvlm8r.py", line 40, in <module>
    from werkzeug.contrib.cache import SimpleCache
ModuleNotFoundError: No module named 'werkzeug.contrib'
[2020-02-15 17:39:42 +0000] [349] [ERROR] Exception in worker process
Traceback (most recent call last):
  File "/usr/local/lib/python3.7/dist-packages/gunicorn/arbiter.py", line 583, in spawn_worker
    worker.init_process()
  File "/usr/local/lib/python3.7/dist-packages/gunicorn/workers/base.py", line 119, in init_pro$
    self.load_wsgi()
  File "/usr/local/lib/python3.7/dist-packages/gunicorn/workers/base.py", line 144, in load_wsgi
    self.wsgi = self.app.wsgi()
  File "/usr/local/lib/python3.7/dist-packages/gunicorn/app/base.py", line 67, in wsgi
    self.callable = self.load()
  File "/usr/local/lib/python3.7/dist-packages/gunicorn/app/wsgiapp.py", line 49, in load
    return self.load_wsgiapp()
  File "/usr/local/lib/python3.7/dist-packages/gunicorn/app/wsgiapp.py", line 39, in load_wsgia$
    return util.import_app(self.app_uri)
  File "/usr/local/lib/python3.7/dist-packages/gunicorn/util.py", line 358, in import_app
    mod = importlib.import_module(module)
  File "/usr/lib/python3.7/importlib/__init__.py", line 127, in import_module
    return _bootstrap._gcd_import(name[level:], package, level)
  File "<frozen importlib._bootstrap>", line 1006, in _gcd_import
  File "<frozen importlib._bootstrap>", line 983, in _find_and_load
  File "<frozen importlib._bootstrap>", line 967, in _find_and_load_unlocked
  File "<frozen importlib._bootstrap>", line 677, in _load_unlocked
  File "<frozen importlib._bootstrap_external>", line 728, in exec_module
  File "<frozen importlib._bootstrap>", line 219, in _call_with_frames_removed
  File "/home/pi/www/wsgi.py", line 17, in <module>
    from intvlm8r import app
  File "/home/pi/www/intvlm8r.py", line 40, in <module>
    from werkzeug.contrib.cache import SimpleCache
ModuleNotFoundError: No module named 'werkzeug.contrib'
[2020-02-15 17:39:42 +0000] [350] [ERROR] Exception in worker process
Traceback (most recent call last):
  File "/usr/local/lib/python3.7/dist-packages/gunicorn/arbiter.py", line 583, in spawn_worker
    worker.init_process()
  File "/usr/local/lib/python3.7/dist-packages/gunicorn/workers/base.py", line 119, in init_pro$
    self.load_wsgi()
  File "/usr/local/lib/python3.7/dist-packages/gunicorn/workers/base.py", line 144, in load_wsgi
    self.wsgi = self.app.wsgi()
  File "/usr/local/lib/python3.7/dist-packages/gunicorn/app/base.py", line 67, in wsgi
    self.callable = self.load()
  File "/usr/local/lib/python3.7/dist-packages/gunicorn/app/wsgiapp.py", line 49, in load
    return self.load_wsgiapp()
  File "/usr/local/lib/python3.7/dist-packages/gunicorn/app/wsgiapp.py", line 39, in load_wsgia$
    return util.import_app(self.app_uri)
  File "/usr/local/lib/python3.7/dist-packages/gunicorn/util.py", line 358, in import_app
    mod = importlib.import_module(module)
  File "/usr/lib/python3.7/importlib/__init__.py", line 127, in import_module
    return _bootstrap._gcd_import(name[level:], package, level)
  File "<frozen importlib._bootstrap>", line 1006, in _gcd_import
  File "<frozen importlib._bootstrap>", line 983, in _find_and_load
  File "<frozen importlib._bootstrap>", line 967, in _find_and_load_unlocked
  File "<frozen importlib._bootstrap>", line 677, in _load_unlocked
  File "<frozen importlib._bootstrap_external>", line 728, in exec_module
File "<frozen importlib._bootstrap>", line 219, in _call_with_frames_removed
  File "/home/pi/www/wsgi.py", line 17, in <module>
    from intvlm8r import app
  File "/home/pi/www/intvlm8r.py", line 40, in <module>
    from werkzeug.contrib.cache import SimpleCache
ModuleNotFoundError: No module named 'werkzeug.contrib'
[2020-02-15 17:39:42 +0000] [351] [INFO] Worker exiting (pid: 351)
[2020-02-15 17:39:42 +0000] [350] [INFO] Worker exiting (pid: 350)
[2020-02-15 17:39:42 +0000] [349] [INFO] Worker exiting (pid: 349)
[2020-02-15 18:40:15 +0000] [333] [DEBUG] Current configuration:
  config: None
  bind: ['unix:intvlm8r.sock']
  backlog: 2048
  workers: 3
  worker_class: sync
  threads: 1
  worker_connections: 1000
  max_requests: 0
  max_requests_jitter: 0
  timeout: 300
  graceful_timeout: 30
  keepalive: 2
  limit_request_line: 4094
  limit_request_fields: 100
  limit_request_field_size: 8190
  reload: True
  reload_engine: auto
  reload_extra_files: []
  spew: False
  check_config: False
  preload_app: False
  sendfile: None
  reuse_port: False
  chdir: /home/pi/www
  daemon: False
  raw_env: []
  pidfile: None
  worker_tmp_dir: None
  user: 1000
  group: 33
  umask: 7
  initgroups: False
  tmp_upload_dir: None
  secure_scheme_headers: {'X-FORWARDED-PROTOCOL': 'ssl', 'X-FORWARDED-PROTO': 'https', 'X-FORWA$
  forwarded_allow_ips: ['127.0.0.1']
  accesslog: None
  disable_redirect_access_to_syslog: False
  access_log_format: %(h)s %(l)s %(u)s %(t)s "%(r)s" %(s)s %(b)s "%(f)s" "%(a)s"
  errorlog: /home/pi/www/gunicorn.error
  loglevel: debug
  capture_output: False
  logger_class: gunicorn.glogging.Logger
  logconfig: None
  logconfig_dict: {}
  syslog_addr: udp://localhost:514
  syslog: False
  syslog_prefix: None
  syslog_facility: user
  enable_stdio_inheritance: False
statsd_host: None
  dogstatsd_tags:
  statsd_prefix:
  proc_name: None
  default_proc_name: wsgi:app
  pythonpath: None
  paste: None
  on_starting: <function OnStarting.on_starting at 0xb5db44f8>
  on_reload: <function OnReload.on_reload at 0xb5db4588>
  when_ready: <function WhenReady.when_ready at 0xb5db4618>
  pre_fork: <function Prefork.pre_fork at 0xb5db46f0>
  post_fork: <function Postfork.post_fork at 0xb5db4780>
  post_worker_init: <function PostWorkerInit.post_worker_init at 0xb5db4858>
  worker_int: <function WorkerInt.worker_int at 0xb5db48e8>
  worker_abort: <function WorkerAbort.worker_abort at 0xb5db4978>
  pre_exec: <function PreExec.pre_exec at 0xb5db4a08>
  pre_request: <function PreRequest.pre_request at 0xb5db4a98>
  post_request: <function PostRequest.post_request at 0xb5db4ae0>
  child_exit: <function ChildExit.child_exit at 0xb5db4bb8>
  worker_exit: <function WorkerExit.worker_exit at 0xb5db4c48>
  nworkers_changed: <function NumWorkersChanged.nworkers_changed at 0xb5db4cd8>
  on_exit: <function OnExit.on_exit at 0xb5db4d68>
  proxy_protocol: False
  proxy_allow_ips: ['127.0.0.1']
  keyfile: None
  certfile: None
  ssl_version: 2
  cert_reqs: 0
  ca_certs: None
  suppress_ragged_eofs: True
  do_handshake_on_connect: False
  ciphers: None
  raw_paste_global_conf: []
  strip_header_spaces: False
[2020-02-15 18:40:15 +0000] [333] [INFO] Starting gunicorn 20.0.4
[2020-02-15 18:40:15 +0000] [333] [DEBUG] Arbiter booted
[2020-02-15 18:40:15 +0000] [333] [INFO] Listening at: unix:intvlm8r.sock (333)
[2020-02-15 18:40:15 +0000] [333] [INFO] Using worker: sync
[2020-02-15 18:40:15 +0000] [349] [INFO] Booting worker with pid: 349
[2020-02-15 18:40:15 +0000] [350] [INFO] Booting worker with pid: 350
[2020-02-15 18:40:15 +0000] [351] [INFO] Booting worker with pid: 351
[2020-02-15 18:40:15 +0000] [333] [DEBUG] 3 workers
[2020-02-15 18:40:22 +0000] [349] [ERROR] Exception in worker process
Traceback (most recent call last):
  File "/usr/local/lib/python3.7/dist-packages/gunicorn/arbiter.py", line 583, in spawn_worker
    worker.init_process()
  File "/usr/local/lib/python3.7/dist-packages/gunicorn/workers/base.py", line 119, in init_pro$
    self.load_wsgi()
  File "/usr/local/lib/python3.7/dist-packages/gunicorn/workers/base.py", line 144, in load_wsgi
    self.wsgi = self.app.wsgi()
  File "/usr/local/lib/python3.7/dist-packages/gunicorn/app/base.py", line 67, in wsgi
    self.callable = self.load()
  File "/usr/local/lib/python3.7/dist-packages/gunicorn/app/wsgiapp.py", line 49, in load
    return self.load_wsgiapp()
  File "/usr/local/lib/python3.7/dist-packages/gunicorn/app/wsgiapp.py", line 39, in load_wsgia$
    return util.import_app(self.app_uri)
  File "/usr/local/lib/python3.7/dist-packages/gunicorn/util.py", line 358, in import_app
    mod = importlib.import_module(module)
  File "/usr/lib/python3.7/importlib/__init__.py", line 127, in import_module
 return _bootstrap._gcd_import(name[level:], package, level)
  File "<frozen importlib._bootstrap>", line 1006, in _gcd_import
  File "<frozen importlib._bootstrap>", line 983, in _find_and_load
  File "<frozen importlib._bootstrap>", line 967, in _find_and_load_unlocked
  File "<frozen importlib._bootstrap>", line 677, in _load_unlocked
  File "<frozen importlib._bootstrap_external>", line 728, in exec_module
  File "<frozen importlib._bootstrap>", line 219, in _call_with_frames_removed
  File "/home/pi/www/wsgi.py", line 17, in <module>
    from intvlm8r import app
  File "/home/pi/www/intvlm8r.py", line 40, in <module>
    from werkzeug.contrib.cache import SimpleCache
ModuleNotFoundError: No module named 'werkzeug.contrib'
[2020-02-15 18:40:22 +0000] [349] [INFO] Worker exiting (pid: 349)
[2020-02-15 18:40:22 +0000] [350] [ERROR] Exception in worker process
Traceback (most recent call last):
  File "/usr/local/lib/python3.7/dist-packages/gunicorn/arbiter.py", line 583, in spawn_worker
    worker.init_process()
  File "/usr/local/lib/python3.7/dist-packages/gunicorn/workers/base.py", line 119, in init_pro$
    self.load_wsgi()
  File "/usr/local/lib/python3.7/dist-packages/gunicorn/workers/base.py", line 144, in load_wsgi
    self.wsgi = self.app.wsgi()
  File "/usr/local/lib/python3.7/dist-packages/gunicorn/app/base.py", line 67, in wsgi
    self.callable = self.load()
  File "/usr/local/lib/python3.7/dist-packages/gunicorn/app/wsgiapp.py", line 49, in load
    return self.load_wsgiapp()
  File "/usr/local/lib/python3.7/dist-packages/gunicorn/app/wsgiapp.py", line 39, in load_wsgia$
    return util.import_app(self.app_uri)
  File "/usr/local/lib/python3.7/dist-packages/gunicorn/util.py", line 358, in import_app
    mod = importlib.import_module(module)
  File "/usr/lib/python3.7/importlib/__init__.py", line 127, in import_module
    return _bootstrap._gcd_import(name[level:], package, level)
  File "<frozen importlib._bootstrap>", line 1006, in _gcd_import
  File "<frozen importlib._bootstrap>", line 983, in _find_and_load
  File "<frozen importlib._bootstrap>", line 967, in _find_and_load_unlocked
  File "<frozen importlib._bootstrap>", line 677, in _load_unlocked
  File "<frozen importlib._bootstrap_external>", line 728, in exec_module
  File "<frozen importlib._bootstrap>", line 219, in _call_with_frames_removed
  File "/home/pi/www/wsgi.py", line 17, in <module>
    from intvlm8r import app
  File "/home/pi/www/intvlm8r.py", line 40, in <module>
    from werkzeug.contrib.cache import SimpleCache
ModuleNotFoundError: No module named 'werkzeug.contrib'
[2020-02-15 18:40:22 +0000] [350] [INFO] Worker exiting (pid: 350)
[2020-02-15 18:40:22 +0000] [351] [ERROR] Exception in worker process
Traceback (most recent call last):
  File "/usr/local/lib/python3.7/dist-packages/gunicorn/arbiter.py", line 583, in spawn_worker
    worker.init_process()
  File "/usr/local/lib/python3.7/dist-packages/gunicorn/workers/base.py", line 119, in init_pro$
    self.load_wsgi()
  File "/usr/local/lib/python3.7/dist-packages/gunicorn/workers/base.py", line 144, in load_wsgi
    self.wsgi = self.app.wsgi()
  File "/usr/local/lib/python3.7/dist-packages/gunicorn/app/base.py", line 67, in wsgi
    self.callable = self.load()
  File "/usr/local/lib/python3.7/dist-packages/gunicorn/app/wsgiapp.py", line 49, in load
    return self.load_wsgiapp()
  File "/usr/local/lib/python3.7/dist-packages/gunicorn/app/wsgiapp.py", line 39, in load_wsgia$
    return util.import_app(self.app_uri)
  File "/usr/local/lib/python3.7/dist-packages/gunicorn/util.py", line 358, in import_app
    mod = importlib.import_module(module)
File "/usr/lib/python3.7/importlib/__init__.py", line 127, in import_module
    return _bootstrap._gcd_import(name[level:], package, level)
  File "<frozen importlib._bootstrap>", line 1006, in _gcd_import
  File "<frozen importlib._bootstrap>", line 983, in _find_and_load
  File "<frozen importlib._bootstrap>", line 967, in _find_and_load_unlocked
  File "<frozen importlib._bootstrap>", line 677, in _load_unlocked
  File "<frozen importlib._bootstrap_external>", line 728, in exec_module
  File "<frozen importlib._bootstrap>", line 219, in _call_with_frames_removed
  File "/home/pi/www/wsgi.py", line 17, in <module>
    from intvlm8r import app
  File "/home/pi/www/intvlm8r.py", line 40, in <module>
    from werkzeug.contrib.cache import SimpleCache
ModuleNotFoundError: No module named 'werkzeug.contrib'
[2020-02-15 18:40:22 +0000] [351] [INFO] Worker exiting (pid: 351)
[2020-02-15 18:48:45 +0000] [338] [DEBUG] Current configuration:
  config: None
  bind: ['unix:intvlm8r.sock']
  backlog: 2048
  workers: 3
  worker_class: sync
  threads: 1
  worker_connections: 1000
  max_requests: 0
  max_requests_jitter: 0
  timeout: 300
  graceful_timeout: 30
  keepalive: 2
  limit_request_line: 4094
  limit_request_fields: 100
  limit_request_field_size: 8190
  reload: True
  reload_engine: auto
  reload_extra_files: []
  spew: False
  check_config: False
  preload_app: False
  sendfile: None
  reuse_port: False
  chdir: /home/pi/www
  daemon: False
  raw_env: []
  pidfile: None
  worker_tmp_dir: None
  user: 1000
  group: 33
  umask: 7
  initgroups: False
  tmp_upload_dir: None
  secure_scheme_headers: {'X-FORWARDED-PROTOCOL': 'ssl', 'X-FORWARDED-PROTO': 'https', 'X-FORWA$
  forwarded_allow_ips: ['127.0.0.1']
  accesslog: None
  disable_redirect_access_to_syslog: False
  access_log_format: %(h)s %(l)s %(u)s %(t)s "%(r)s" %(s)s %(b)s "%(f)s" "%(a)s"
  errorlog: /home/pi/www/gunicorn.error
  loglevel: debug
  capture_output: False
  logger_class: gunicorn.glogging.Logger
  logconfig: None
  logconfig_dict: {}
syslog_addr: udp://localhost:514
  syslog: False
  syslog_prefix: None
  syslog_facility: user
  enable_stdio_inheritance: False
  statsd_host: None
  dogstatsd_tags:
  statsd_prefix:
  proc_name: None
  default_proc_name: wsgi:app
  pythonpath: None
  paste: None
  on_starting: <function OnStarting.on_starting at 0xb5de14f8>
  on_reload: <function OnReload.on_reload at 0xb5de1588>
  when_ready:
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

Thread 48 (2020-07-13):

Image transfer from camera to pi intermittant

cadpix, 2020-07-13:
When copying images from the camera to the pi I am getting some strange behaviour.
Either the transfer simply doesn't happen at the preset time OR it will only copy 84 images when there could be say 100 on there to copy.
If I use the 'copy now' button it will copy but only 84 images at a time.
I am using a Canon 6D and this problem has only really become apparent.
Before I copy the logs etc I thought I would check to see if anyone else had had this happen?

greiginsydney, 2020-07-13:
I've not seen that one before. Eighty-four repeatedly?

I've previously tested and confirmed that the camera will stay awake during the copy process, so it shouldn't be that.

Let me load up a CF with images and see if I can dupe it. If you get a chance, please have a peek at the gunicorn.error and cameraTransfer.log files for anything obvious and paste them in here?

I'm stuck on another project at the moment but should be able to refocus onto this before the week's out.

\- G.

OzRocky, 2020-07-14:
> Either the transfer simply doesn't happen at the preset time OR it will only copy 84 images when there could be say 100 on there to copy.

Can you let me know what image format you have the camera set to, and I'll try to duplicate the problem with my 6D?

r.

cadpix, 2020-07-14:
Hi both,

The 6d is set to av (aperture priority) and it is shooting raw images only. The camera is set to sleep after 60 seconds.

Everything else looks to be working as it should and the camera wakes when requested.

I will check out the error and logs and come back to you : )

w

cadpix, 2020-07-14:
Could this be the culprit perhaps? Have found this at the end of each of the 'batches' of copied images in gunicorn.errors

[2020-07-13 10:12:05 +0100] [8764] [DEBUG] Deleted /store_00020001/DCIM/100CANON/_MG_7210.CR2
[2020-07-13 10:12:05 +0100] [8764] [DEBUG] Copying /store_00020001/DCIM/100CANON/_MG_7211.CR2 --> /home/pi/photos/DCIM/100CANON$
[2020-07-13 10:12:05 +0100] [384] [CRITICAL] WORKER TIMEOUT (pid:8764)
[2020-07-13 10:12:07 +0100] [17710] [INFO] Booting worker with pid: 17710
[2020-07-13 10:12:10 +0100] [17710] [DEBUG] hiddenTransferOptions =
[2020-07-13 10:37:06 +0100] [8834] [DEBUG] GET /
[2020-07-13 10:37:06 +0100] [4210] [DEBUG] GET /login
[2020-07-13 10:37:06 +0100] [4210] [DEBUG] Its a GET to LOGIN
[2020-07-13 10:37:06 +0100] [8834] [DEBUG] GET /static/main.css
[2020-07-13 10:37:06 +0100] [8834] [DEBUG] GET /static/favicon.ico
[2020-07-13 10:37:10 +0100] [8834] [DEBUG] POST /login

OzRocky, 2020-07-16:
Yup. I've confirmed the "worker timeout" error when transferring a lot of large images. Hopefully it won't be too difficult a fix.

r.

cadpix, 2020-07-16:
Good news, let me know if you need any more info / tests from here!

greiginsydney, 2020-07-18:
Yuk. This is going to take some time to fix (properly).

We are hitting a 5-minute timeout, and the work-around is to just extend the value.

1.    Edit /etc/systemd/system/intvlm8r.service and change the `--timeout 300` to a 600:

https://github.com/greiginsydney/Intervalometerator/blob/a270516adda83760222281e20eff8fe1ec0f96be/Raspberry%20Pi/intvlm8r.service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

2.    Then restart the service (`sudo systemctl restart intvlm8r`) or just wait for the next reboot (assuming it's not running 24x7 of course).

Catch is we seem to hit a DIFFERENT timeout at around the 8-9 minute mark, so there's no benefit to setting a timeout value of longer than 600. You'll see "Ignoring EPIPE" in gunicorn.error when the copy ends.

Leave it with me and I'll see if I can easily extend the band-aid in the short-term, and I'll embark on what's needed to decouple the image transfer process so it'll be free to run for as long as necessary...

\- G.

greiginsydney, 2020-07-18:
BTW the fix to this will also address Issue #22

cadpix, 2020-07-21:
Looks like the --timeout increase is working.
Our daily transfers are back on track which is fantastic.
We are taking 68 pics a day 7 days a week so this is great for now.
I will monitor this and let you know how we get on!

W

cadpix, 2020-07-27:
Update for you, while there has been an improvement with the --timeout increase, there still a backlog of images on the camera still, not quite as many as before however. No big deal as just a matter of pressing the 'copy now' button a few times to clear it as I have not had a look at it for a week.

W

greiginsydney, 2020-07-27:
I'm working on a proper fix for that, don't worry. It might take me a couple more weeks as it's a doozie.

Currently being distracted by a revamp of the Thumbnails page (although it will tie back into this).

cadpix, 2020-07-27:
No worries at all, thanks for your hard work! Look forward to seeing the thumbnails revamp!

greiginsydney, 2020-11-28:
Fixed in release [v4.0.0](https://github.com/greiginsydney/Intervalometerator/releases/tag/v4.0.0) with the addition of Celery & Redis.

greiginsydney, 2021-02-05:
For the benefit of anyone coming along later, any problems with image backlogs on the camera can be resolved by setting more than one upload schedule per day:

https://github.com/greiginsydney/Intervalometerator/blob/master/docs/FAQ.md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

The only caveat is that the Pi will need to be running at the time of this/these extra schedule(s), so that will probably necessitate "Always On" mode, with the resulting extra current drain.

Closed 2020-11-28.

Thread 50 (2020-07-18):

"Set system time & date" doesn't set the Pi's time & date, only the Arduino.

greiginsydney, 2020-07-18:
This button only sends the time and date to the Arduino, not the Pi:

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

On the next restart of the Pi, it will update its time as per the appropriate config (NTP source or a query of the Arduino), but until that happens, the two will be out of sync.

The expected operation is that the button shall sync both devices.

greiginsydney, 2021-06-05:
Fixed in [release 4.1.0](https://github.com/greiginsydney/Intervalometerator/tree/v4.1.0)

Closed 2021-06-05.

Thread 51 (2020-07-18):

With no network access & the Pi always running, its time will never sync to the Arduino

greiginsydney, 2020-07-18:
- The Arduino is the master real-time clock, itself fed by the DeadOn RTC.
- The Pi has a volatile RTC, so each time it boots it needs to have the time and date set.

**Problem**: if the Pi is set to always run, it will never sync its time, resulting in it eventually drifting out of sync.

**Impact**: probably negligible. It will only affect the timing of the transfer and upload tasks, which are the only things that the Pi relies on its RTC for.

**Resolution**: add a cron job at ~midnight to re-sync with the Arduino. (The script already exists to do this.)

Closed 2021-03-21.

Thread 54 (2020-07-30):

With a Nikon DSC D5200, some Camera Settings are broken

greiginsydney, 2020-07-30:
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

Closed 2021-06-05.

Thread 58 (2020-10-10):

daylight savings adjustment for Arduino RTC time.

peterjbaylis, 2020-10-10:
some questions that may turn into an enhancement request.
If the pi is configured to use an NTP time server will it update the Arduino time when daylight savings start or stops?

- Do people generally want to use daylight savings?

- Will people simply adjust the "deadon RTC" timer to account for daylight savings, probably a bit inconvenient if the unit is remote.

- is daylight saving something that most people will just ignore?

Cheers Peter.

greiginsydney, 2020-10-10:
Hi Peter,

Yes, I think the intvlm8r should follow "local time".

When I get around to addressing bug #50 it will ensure that **a network-connected Pi** [caveat] will update the Arduino to follow DST, which isn't happening automatically at the moment.

A network-connected Pi syncs its RTC from the internet each time it boots, and regularly if it's set to 'always run'.

An off-grid Pi is more of a challenge. Handling this would require the user to set a timezone and programmatically calculate the in- and out- of DST. Let me ruminate on this one some more. (It's been in the too-hard basket for a while now).

The whole timezone and DST business warrant a mention on the [FAQ](https://github.com/greiginsydney/Intervalometerator/blob/master/docs/FAQ.md) page, which I'll craft at the same time as the issue above is resolved.

Ta for the prompt.

\- Greig.

greiginsydney, 2021-06-05:
Now tracking the sync of time from NTP -> Pi -> Arduino as Issue #84.

I'll leave this issue open until I close 84 & also update the FAQ page.

greiginsydney, 2021-07-09:
Resolved in [release 4.1.1](https://github.com/greiginsydney/Intervalometerator/releases/tag/v4.1.1)

Closed 2021-07-09.

Thread 61 (2020-11-01):

Use intervalometer without arduino, just for long duration time-lapses

Jones1403, 2020-11-01:
Hello,
Thanks for this amazing application. This is more of a question than an issue, but is it possible to run this only on the Pi without arduino.

I want to use it to make in house long duration time-lapses.
for example a picture every minute for the next 30 days between 9h and 17h to track a restauration project. So continuous power and network is guaranteed.

Is there anything that would need to be changed to have this functionality?

Thanks in advance

Jona

greiginsydney, 2020-11-01:
Hi Jona,

The Arduino is critical, as it's what wakes and fires the camera on the time schedule. The Pi is only used for the "admin" side of things.

If sourcing and programming the Arduino is a problem, we'll be offering some assembled PCBs via eBay soon - although they might not land there until December.

I've not looked into an option where you can forgo the Arduino and RTC and leave the Pi to do the lot, but it's a great question.

It will be a significant re-write to build all the timing and camera control into the Pi, but leave it with me and I'll look into it. (If it's do-able it certainly won't see the light of day until 2021 though).

\- G.

Jones1403, 2020-11-02:
Wow what a quick response, thanks for that. Sourcing the arduino/pcb is not a problem, but i must have overlooked the fact that the triggering was done using the arduino.

 I can see from the point of view of power consumption that is definitely the best option. Though that is something I’m not really concerned about.

I started writing something in python using gphoto2. But then thought maybe someone already invented the wheel before me. ;-)

So I can see that will be a big rewrite. Because all I actually need is the intervalometer capability, the camera control and the web transfer.

I think it might be an interesting development for your project, however as I’ll be needing it very soon, it will not be in time for me.
I’ll continue looking.

Thanks again for the quick response.
I’ll definitely follow your project to see what you’ll be developing in the future.

Regards,

Jona

Sent from my iPhone

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

mmunsk, 2023-01-17:
HI Greig,
Tony here, I've been loking for something like this forever and you've MADE IT, congratulations! You're awesome!
I'm trying to put this to work as a winter project and I was wondering if you have these Asembled PCBs available in ebay as you mention.
I would love to get a fully assembled unit from you to try it out.
I would also love to get in contact with you personally to ask a few other questions in case you have the time and are willing to do so, if so this is my email address (plutonio07@hotmail.com) plutonio cero seven at hotmail dot com ( sorry first time using github so not sure if the platform doesn't allow emails) waiting to hear from you soon.

Warm regards.

Thank you so much!

greiginsydney, 2023-01-17:
Hi Tony,

Great to have you on board! See your inbox ... (You might also then choose to delete or edit your comment so your e-mail address isn't public.)

\- Greig.

Plucky1423, 2023-08-16:
Hi @greiginsydney , me again
Did you have any luck with the pi based re build idea jones has asked above?
I'm looking into this as an option while we await the re arrival of the dead on clock component. any advice or even fox holes to avoid is always welcome.
thanks
JS

greiginsydney, 2023-08-16:
No, sorry. I like it as a concept, but it comes with LOTS of complexities, not the least of which is figuring out how to maintain both operational modes within the same code-base. I'll see if I can give it another review though given the circumstances...

greiginsydney, 2023-08-16:
Actually I'm beginning to think this is a non-starter.

A critical issue is that the Pi doesn't have its own non-volatile real-time clock (RTC), so if it ever loses power, it won't know what the time is when it comes back up. That then necessitates the addition of an external RTC, or a permanent network connection so it can query NTP each time it boots.

Thread 66 (2020-11-28):

Chained tasks don't display correctly on-screen

greiginsydney, 2020-11-28:
When copyNow completes and newThumbs fires, the on-screen status display returns to "Background tasks idle" instead of showing the status of the thumbnail creation. If the user presses F5 here, the page correctly detects the new/current task and the status updates correctly to show as the thumbs are created.

The intent is that the status should update automatically, reporting the copy process and then the thumbs creation count.

Thread 67 (2020-11-29):

piTransfer [ftp method] fails to upload files.

peterjbaylis, 2020-11-29:
Hi Greig;

My intervalometerator is not uploading files each day.
The piTransfer log shows that it connects to the ftp server but fails to upload files,
Here is an extract from the log file.

**2020/11/29 19:03:16 OK to transfer @ 19:00. Method = FTP
2020/11/29 19:03:16 STATUS: Commencing upload using FTP
2020/11/29 19:03:18 STATUS: No new files to upload**

The "photos/DCIM"  folder on the pi has two directories 100CANON and 101CANON both containing files which have not been uploaded to the ftp server.

The ftp server log file shows that the pi connects each day at ~19:00 but no files get transferred.

Are you able to suggest where I might look to trouble shoot this problem?

Cheers
Peter.

greiginsydney, 2020-11-30:
Hi Peter,

'/home/pi/www/piTransfer.py' uses the function 'list_New_Images' to determine the new images that need to be uploaded.

It looks for all the images in PI_PHOTO_DIR ('/home/pi/photos') and its sub-folders, and discards any that exist in the UPLOADED_PHOTOS_LIST file ('/home/pi/photos/uploadedOK.txt'). Whatever's left it uploads one-by-one, adding each to the UPLOADED_PHOTOS_LIST as it goes.

I can't see anything obvious in the code that might be causing this issue (and none of my recent tests against Google, which uses the same shared 'list_New_Images' function have given me any trouble).

Is there any chance you have swapped the camera's memory card recently, or perhaps your 'File numbering' is set to anything other than 'Continuous'? (We've only ever used Continuous.)

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

(The image came from [this support page at Canon](https://support.usa.canon.com/kb/index?page=content&id=ART167999)).

If you've possibly replaced the card with a blank one, the trick is to edit or simply delete the UPLOADED_PHOTOS_LIST file. Beware if you delete it, you'll need to execute these two commands from ssh to re-create it and reset permissions:
```python
touch /home/pi/photos/uploadedOK.txt
sudo chown -R pi:www-data /home/pi/photos/uploadedOK.txt
````
&nbsp;
\- G.

peterjbaylis, 2020-11-30:
Hey Greig;

Thanks heaps; deleting the **uploadedOK.txt** file and then recreating it has fixed my problem.
I  rebooted the pi after the uploadedOK.txt delete and recreate per your instructions and now the pi is frantically catching up with about 3400 image transfers.
If it runs out of time (60 mins max) then I will just force a reboot and keep doing this until it has caught up.

This issue was made a little tricky to chase down as there is no ftp client on the pi by default. It appears as your intervalometerator code uses an ftp library from python, so this is not available outside the intervalometerator python app.
I was able to test my ftp host by using filezilla in ftp mode so I knew the ftp host (a QNAP NAS box) could accept ftp connections.

Thanks for your quick response on this issue, it has been driving me nuts for over a week, so I'm happy the solution is easy to implement.

FYI, if any other intervalometerator builders are looking for a robust mount for the Pelican case I found a Vesa mount at Altronics # H 8187 that works nicely for my situation. It is rated for 12Kg and has adjustable friction pivots to allow positioning the case for pan and tilt.

See the image below for my implementation.

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

Cheers
Peter

greiginsydney, 2020-12-01:
Nice one Peter! That joint is sufficiently rigid so as not to wobble at all??

BTW, do you realise you don't have to reboot the Pi to copy images?

ssh to the Pi, cd to the www folder and `python3 piTransfer.py copyNow`.

I've not tried it with a VAST amount of images to know if it will run forever or timeout at some stage, so I don't know where your 60 minutes timeout is coming from.

\- Greig.

Closed 2020-12-30.

Thread 68 (2020-12-23):

Using feeling

wj7106, 2020-12-23:
After a period of time, we found several problems. First, we can't set the second to shoot. The shortest time is only one minute. Second, there is no way to set multiple time periods in a day, such as shooting from 8:00 a.m. to 12:00 a.m. and then sleeping, shooting from 2:00 p.m. to 9:00 p.m. and then sleeping again. Third, can we add direct transfer button instead of copy in the transmission settings. Fourth, after copying the photos, the USB speed of raspberry PI zero is not fast. After copying raw, the maximum wake-up time of one hour is not enough. It is suggested to change the wake-up time freely. Fifthly, the circuit design should be added to prevent power backflow, and supply power to raspberry pie separately, and the current will return to Arduino. Sixth, add manual photo taking instead of preview function in camera settings, which can make up for missed moments. Seventh, add Baidu network disk transmission function. China can't access Google and other online disks! I am a deep delay photography enthusiast, looking forward to your e-mail communication!

greiginsydney, 2020-12-30:
Hi, thanks for the feedback and sorry it's taken me so long to reply.

1. 60 shots an hour is the maximum we designed the intvlm8r for, and we never thought anyone would take 1 shot per minute. What are you capturing that moves so quickly?
2. We designed the intvlm8r so it would shoot continuously each day ([and hopefully soon overnight](https://github.com/greiginsydney/Intervalometerator/issues/12)). Your application sounds quite specialised if you're wanting to shoot images every 'n' seconds and stop for a 2-hour lunch.
3. What do you mean by "direct transfer"? Do you mean a 1-click way of copying all the images from the camera that then automatically uploads them to the off-Pi destination?
4. You're right, the Pi zero is not fast, but I wouldn't be surprised if your slow USB feed is a limitation of the camera, not the Pi. If you want to upgrade to a more powerful Pi, we've documented that on the [Advanced Config](https://github.com/greiginsydney/Intervalometerator/blob/master/docs/advancedConfig.md#other-pi-models) page.
I've also just added an [FAQ note](https://github.com/greiginsydney/Intervalometerator/blob/Bugs-2011/docs/FAQ.md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) to show how you can run more than one copy/transfer each day.
5. If you're wanting to power the Pi separately, that's documented at the very bottom of [this page](https://github.com/greiginsydney/Intervalometerator/blob/master/docs/advancedConfig.md#other-pi-models).
6. "Preview" was designed to help you tweak the setup once the box is sealed and in position. How will a manual shoot button "make up for missed moments", especially when you're shooting one shot per minute? Can you explain the use-case?
7. Adding upload to Baidu from here in Australia will be as much as a challenge for me as accessing Google Drive is for you. If you can't find someone locally who can do that for you, the generic FTP and SFTP options should be a good fallback option.

\- Greig.

greiginsydney, 2021-01-27:
Pausing during lunch is now addressed by the "lunchtime kludge" added in 4.0.1. See the [FAQ](https://github.com/greiginsydney/Intervalometerator/blob/master/docs/FAQ.md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) for details.

Closed 2021-01-27.

Thread 72 (2021-01-29):

Changing the System Time doesn't update alarm2

greiginsydney, 2021-01-29:
Alarm2 in the Arduino tells the Arduino when to shut down the Pi, and it's just saved as the minute value.

When you change the time, Alarm2 isn't updated, and that means the Pi might stay on for up to an hour after the change before the alarm value falls back into sync.

Suggested fix: change setTimeDate to call SetWakePiTime when it completes.

Closed 2021-02-01.

Thread 73 (2021-02-01):

Intermittent: Arduino sleeps before completing a reboot requested by the Pi

greiginsydney, 2021-02-01:
When the Pi requests a shutdown/reboot, the Arduino sets the "resetArduinoFlag" and tells the Pi to shut down.

It waits for the Pi to confirm it's no longer running before removing the power and initiating a soft reset.

IF however, the main Pi shutdown loop runs after the Pi is 'not running' before the next time the "if (resetArduinoFlag == true)" loop runs, the Pi will instead be powered down and the Arduino put to sleep - still with the "resetArduinoFlag" set.

Adding a test for the resetArduinoFlag before the Arduino sets its sleep flag will address this.

greiginsydney, 2021-03-12:
Fixed in release v4.0.2

Closed 2021-03-12.

Thread 75 (2021-03-24):

Camer settings doesn't always update to correct settings

aerialvideographyuk, 2021-03-24:
When going to camera settings on the web interface the setting given is the actual setting used for the last picture and not the settings for the camera. If the web browser is refreshed the correct camera settings appear.  This was with a Canon 600D  set to AV, auto ISO and f5.6, auto shutter.  The camera settings displayed were AV, ISO 100, f.5.6, 250 sec.  On refresh the correct settings were shown.

greiginsydney, 2021-03-24:
That's an odd one. I can't say I've seen that here before.

The values are all initialised to blank when the /camera page is called, and then it queries the camera and populates them, so it's not like anything is cached in the intvlm8r.

It's not doing it on the 60D sitting next to me. I can toggle the MF/AF switch and F5 the webpage and the values follow correctly every time.

Does it do this all the time, or is it intermittent?

aerialvideographyuk, 2021-03-24:
It does it all the time but only seems to be when you have to use the "wake the camera" function.
document with screenshots of the sequence of events is attached.
[camera settings web view.docx](https://github.com/greiginsydney/Intervalometerator/files/6197651/camera.settings.web.view.docx)

greiginsydney, 2021-03-25:
Thanks for the doco - I now see i can reproduce this here as well, with the ISO and shutter speed values both changing.

This variation is indeed as a result of waking the camera, because with that half-press it takes a meter reading and determines the correct ISO and shutter speed to use for your given aperture, were you to fully press the button. I note that the camera's display updates from an ISO of "A" to the chosen ISO too.

Let me look into this some more and see what I can do. Thanks for bringing it to our attention.

\- G.

greiginsydney, 2021-08-09:
I've today made some camera-related performance improvements in 4.2.1 that result in faster page load times for /home and /system, and a side bonus is I think it's sufficiently *delayed* the /camera page to suppress this issue.

I'll be monitoring it through this next testing phase. I'll let you know when it's released (ETA 1st Sept) and ask you to let me know if it recurs.

\- G.

greiginsydney, 2021-09-13:
Nah, it's still present. I'm still looking into how best to solve it.

The easy way is to introduce a long delay after the camera is woken and before the camera is queried (waiting for it to timeout) but that's not a bridge I'm ready to cross.

Thread 76 (2021-03-30):

/ Camera gives "Unsupported operation" if you Apply changes while the Nikon is in "P" mode

greiginsydney, 2021-03-30:
> **P (programmed autoexposure):** The camera selects the aperture and shutter speed to deliver a good exposure at the current ISO setting. But you can choose from different combinations of the two for creative flexibility (which is why this mode is sometimes referred to generically as flexible programmed autoexposure).
([ref: p.158](https://www.bhphotovideo.com/lit_files/370196.pdf))

"P" mode in the Nikon is an auto-exposure mode. You don't want this in a time-lapse, and it's highlighted in red on the Camera page if it's selected on the camera:

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

When you click Apply, the entire form is submitted - all six values in the lower pane, including aperture and speed.

The problem with the Nikon in P mode is that it will let you submit a chosen aperture _or_ a speed, but not both.

The fix to this is to add Javascript on the page to determine if either value has been changed and then lock out the other. I don't see this being a worthwhile investment of time, as P mode isn't going to result in a successful time-lapse anyway.

Arguments to the contrary are most welcome, but until then I'll close this.

\- G.

Closed 2021-03-30.

Thread 78 (2021-04-03):

Interval problem

wj7106, 2021-04-03:
I added a lot of interval time in the interval setting page program, and there was an interval problem. For example, when I set a seven minute interval, the next hour, three minutes plus seven minutes should be 10 minutes, then it becomes 07 minutes, and it becomes the minutes before the automatic reset, starting from the seven minutes set

greiginsydney, 2021-04-03:
I see what's going on here, and it's because you've chosen a custom interval that's not divisible by 60.

In the Arduino's "setAlarm1()" function it holds in a loop, adding a minute to the current time (the minute count) over and over until the number becomes divisible by <interval>. If the number is > 60 it subtracts 60 and increments the hour. This becomes the time for the next shot, and the alarm is set.

So as you reach the end of the first hour, it will fire at minutes = 56 and keep incrementing until minutes = 63, then subtract 60, so the first photo in the next hour will be at 3 minutes past. When that photo is taken it will repeat the process and re-sync, with another photo at 7 minutes past.

Closed 2021-04-07.

Thread 79 (2021-04-08):

Images not transferring from camera -> Pi when using a 4G wifi dongle

greiginsydney, 2021-04-08:
I am also trying to get things working over a 4g wifi dongle and over traditional wifi but without port forwarding.  I removed the fixed ip settings on the pi and installed remote.it on the pi.  I could then set up a connection for ssh, http on port 80 and https on port 443. everything appeared to be working fine as I was able to access the camera via remote.it and change settings etc.  However I then noticed that no photo's were getting transferred to dropbox. When I checked the photos have stayed on the camera and not gone to the pi.  attached are the cameraTransfer.log and the gunicorn.error files. Any help appreaciated.
[cameraTransfer.log.txt](https://github.com/greiginsydney/Intervalometerator/files/6274373/cameraTransfer.log.txt)
[gunicorn.error.txt](https://github.com/greiginsydney/Intervalometerator/files/6274375/gunicorn.error.txt)

_Originally posted by @aerialvideographyuk in https://github.com/greiginsydney/Intervalometerator/issues/8#issuecomment-815252097_

greiginsydney, 2021-04-08:
Hi Dave,

Can you please attach the file from /var/log/celery/celery_worker.log, as that's where the camera tranfer process is logged in detail? (If the file's large, please remove everything prior to ~20:15 on the 7th). Alternatively, look for `Received task: intvlm8r.copyNow` and only send the rest from that point.

You mentioned to me elsewhere that changing IPs and unstalling/uninstalling remote.it caused then resolved the issue. Can you point me to the doco for that, as I'm keen to understand what changed and why it broke.

\- G.

greiginsydney, 2021-04-08:
BTW, the two files you've already included show the process kicked off OK:
1. cameraTransfer.py fired, and raised a request with intvlm8r.py for the transfer, the latter responding in the affirmative ('OK').
2. intvlm8r.py saw that and fired off a background task for a 'celery' worker to handle the transfer.
3. The bouncing ball leads us to what happened next ...

aerialvideographyuk, 2021-04-08:
Hi Greig
The celery_worker.log hadn't been updated since 5th April, the day I put remote.it on.  I removed the remote.it package and rebooted the pi and everything is working again as far as I can tell.  Will leave it run today and then see what I'm doing wrong with remote.it.

aerialvideographyuk, 2021-04-08:
dont know if it's connected but if I go to the transfer tab on the web interface and then do a copy now I get the background task pending etc messages then
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

greiginsydney, 2021-04-08:
Well, that's definitely a bug. I fixed one of those recently in v4.0.2 ("Fixed error in copyNow when camera has no images"). Are you running that version or one earlier? The celery log will ID the cause, when you can get one.

greiginsydney, 2021-04-09:
@aerialvideographyuk :
> Will leave it run today and then see what I'm doing wrong with remote.it.

It's more likely an incompatibility between the two, but it would be good to understand what's going on and try to get them to place nicely together. Can you link me to the installation process/guide you followed?

aerialvideographyuk, 2021-04-09:
https://support.remote.it/hc/en-us/articles/360047542051-Installing-remoteit-on-a-Raspberry-Pi-running-Raspbian-or-Raspberry-Pi-OS
Is what I used - reinstalling now - will let you know how it goes

aerialvideographyuk, 2021-04-09:
I have reinstalled and again registered ssh, http, and https and it all appears to be working fine.  Will leave it run through a complete day and see if it's OK. As far as I'm aware I didn't do anything different to the first time.  I'm running version 4.01 by the way. I will update to 4.0.2 once I see that all is OK with remote.it.

aerialvideographyuk, 2021-04-10:
I spoke too soon. Once again it looks like the copy from camera to pi has failed to take place. Will check the logs and update as soon as I can

greiginsydney, 2021-04-12:
You didn't enable http-alt by any chance?

The intvlm8r uses port 8080 for the transfer process... (It's easily-enough moved if that's the issue.)

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

aerialvideographyuk, 2021-04-12:
No I didn't.  Was looking at the camera transfer code last night and was wondering if I needed to enable a connection to 8080 on remoteit? Have you managed to get it working?

greiginsydney, 2021-04-13:
Yes, I was just able to login to the intvlm8r remotely (VERY neat!!) and issue a 'CopyNow', which then copied the images and created the thumbs.

I'll set the daily copy now time for the next hour and see if that takes place.

(Have you upgraded to 4.0.2 yet??)

aerialvideographyuk, 2021-04-13:
No I haven't upgraded yet but I did put remoteit back on with  port 8080, port 22 and port 80 connections.  I could also do a copy and a transfer took place after a reboot.  Will leave it run a cycle again and see if it works.  What is port 443 used for? Do I need it?

greiginsydney, 2021-04-13:
443 is used for if you were using SSL (a certificate for "https").

You'll definitely break the intvlm8r if you enable 8080 for remote.it, as the scheduled cameraTransfer.py script calls intvlm8r.py on port 8080.

This will tell you if anything other than the intvlm8r is using port 8080:
```python
pi@BenchPi3Bplus:~ $ sudo netstat -pant | grep 8080
tcp        0      0 0.0.0.0:8080            0.0.0.0:*               LISTEN      548/nginx: master p
```

So that's telling us that process 548 - nginx - is listening on 8080.

For more details on process 548 (this number will change):

```python
pi@BenchPi3Bplus:~ $ ps aux | grep 548
root       548  0.0  0.2  50232  2268 ?        Ss   Apr11   0:00 nginx: master process /usr/sbin/nginx -g daemon on; master_process on;
pi         673  0.2  3.7  60356 35548 ?        S    Apr11   7:13 /usr/bin/python3 -m celery -A intvlm8r.celery worker --logfile=/var/log/celery/celery_worker.log --loglevel=DEBUG --time-limit=300 --concurrency=8 -n celery_worker@BenchPi3Bplus --pidfile=/var/run/celery/celery_worker.pid --executable=/usr/bin/python3
pi        7064  0.0  0.0   7348   508 pts/0    S+   15:24   0:00 grep --color=auto 548
pi@BenchPi3Bplus:~ $
```

(Only the top line is relevant - the other two are partial matches for '548'. This use of 8080 is declared in the file `/etc/nginx/sites-available/intvlm8r`.)

If you can send me some screen-scrapes (like those above) showing remote.it is using 8080, I'll wrap that all up in a new FAQ and document how to change the ports in the intvlm8r.

\- G.

aerialvideographyuk, 2021-04-13:
I did a complete re-install of the latest code - all worked fine. (I have not put SSL on though) I then put remoteit back on and again the same results - no copy.
Did as you asked above and only one process running but appears to be on python2 and no celery process which ties up with the celery log not updating.

pi@AVUKcontroller1:~ $ sudo netstat -pant | grep 8080
tcp        0      0 0.0.0.0:8080            0.0.0.0:*               LISTEN      502/nginx: master p
pi@AVUKcontroller1:~ $ ps aux | grep 502
root       480  0.7  3.4  22032 15024 ?        Ss   21:29   0:03 /usr/bin/python2 /usr/bin/supervisord -n -c /etc/supervisor/supervisord.conf
root       502  0.0  0.4  50216  2188 ?        Ss   21:29   0:00 nginx: master process /usr/sbin/nginx -g daemon on; master_process on;
pi         743  0.0  0.4   7332  2024 pts/0    S+   21:38   0:00 grep --color=auto 502
pi@AVUKcontroller1:~ $

greiginsydney, 2021-04-14:
That's weird. But if you back up a step, without remote.it and the scheduled transfers working fine, what do netstat & ps aux reveal?

PLEASE update the intvlm8r though. I don't want either of us to waste any more time on something that could have already been resolved (explaining why I'm not seeing it here).

[BTW, any resolution might be in an underlying component, not my own code. There are a lot of moving pieces here and my code is a tiny portion of that. A `sudo apt-get update && sudo apt-get upgrade -y` could be your fix, as I'm developing and testing with Raspbian & all the other components at their current releases].

greiginsydney, 2021-04-14:
Sorry Dave, scratch that update request bit. I hadn't read your "complete reinstall" comment correctly.

aerialvideographyuk, 2021-04-14:
OK removed remote.it again and run the 2 commands when it was copying files and when it finished

When still copying files
pi@AVUKcontroller1:~ $ sudo netstat -pant | grep 8080
tcp        0      0 0.0.0.0:8080            0.0.0.0:*               LISTEN      450/nginx: master p
tcp        0      0 127.0.0.1:8080          127.0.0.1:36594         TIME_WAIT   -

pi@AVUKcontroller1:~ $ ps aux | grep 450
root       450  0.0  0.2  50216   900 ?        Ss   18:37   0:00 nginx: master process /usr/sbin/nginx -g daemon on; master_process on;
pi         634  0.0  0.4   7332  2036 pts/0    S+   18:43   0:00 grep --color=auto 450
pi@AVUKcontroller1:~ $

Once copy finished
pi@AVUKcontroller1:~ $ sudo netstat -pant | grep 8080
tcp        0      0 0.0.0.0:8080            0.0.0.0:*               LISTEN      450/nginx: master p

pi@AVUKcontroller1:~ $ ps aux | grep 450
root       450  0.0  0.0  50216   316 ?        Ss   18:37   0:00 nginx: master process /usr/sbin/nginx -g daemon on; master_process on;
pi         642  0.0  0.4   7332  1904 pts/0    S+   18:47   0:00 grep --color=auto 450
pi@AVUKcontroller1:~ $

As far as I can tell I'm using the same as you except I don't have an SSL certificate. Not sure where to go next now.

greiginsydney, 2021-04-18:
I'm lost too. Mine's behaving fine. Here's the start of the celery_worker.log at 3pm, when my daily transfer is scheduled to  commence:

```python
[2021-04-17 15:00:02,009: DEBUG/MainProcess] pidbox received method active() [reply_to:{'exchange': 'reply.celery.pidbox', 'routing_key': 'a1a8db10-2391-30ca-b4be-ca565a852084'} ticket:fc97eb54-e07e-466a-b3d9-cc69137ecc47]
[2021-04-17 15:00:02,035: INFO/MainProcess] Received task: intvlm8r.copyNow[e0ed5ce0-c3fa-46f1-af05-d775957be1de]
[2021-04-17 15:00:02,036: DEBUG/MainProcess] TaskPool: Apply <function _trace_task_ret at 0x75666a98> (args:('intvlm8r.copyNow', 'e0ed5ce0-c3fa-46f1-af05-d775957be1de', {'lang': 'py', 'task': 'intvlm8r.copyNow', 'id': 'e0ed5ce0-c3fa-46f1-af05-d775957be1de', 'shadow': None, 'eta': None, 'expires': None, 'group': None, 'group_index': None, 'retries': 0, 'timelimit': [1800, None], 'root_id': 'e0ed5ce0-c3fa-46f1-af05-d775957be1de', 'parent_id': None, 'argsrepr': '()', 'kwargsrepr': '{}', 'origin': 'gen753@BenchPi3Bplus', 'reply_to': '8c03f697-bae8-3041-9fdf-be80316ca4b1', 'correlation_id': 'e0ed5ce0-c3fa-46f1-af05-d775957be1de', 'hostname': 'celery_worker@BenchPi3Bplus', 'delivery_info': {'exchange': '', 'routing_key': 'celery', 'priority': 0, 'redelivered': None}, 'args': [], 'kwargs': {}}, b'[[], {}, {"callbacks": null, "errbacks": null, "chain": [{"task": "intvlm8r.newThumbs", "args": [], "kwargs": {}, "options": {"task_id": "427aa427-6026-4fe2-b7a8-bbc275bc1415", "reply_to": "8c03f697-bae8-3041-9fdf-be80316ca4b1"}, "subtask_type": null, "chord_size": null, "immutable": true}], "chord": null}]', 'application/json',... kwargs:{})
[2021-04-17 15:00:02,041: DEBUG/MainProcess] Task accepted: intvlm8r.copyNow[e0ed5ce0-c3fa-46f1-af05-d775957be1de] pid:648
[2021-04-17 15:00:02,544: INFO/ForkPoolWorker-7] copyNow(): entered
[2021-04-17 15:00:02,545: DEBUG/ForkPoolWorker-7] (gp_port_new) Creating new device...
[2021-04-17 15:00:03,547: INFO/ForkPoolWorker-7] copyNow() trying to init the camera
```

(I'm logging at the very verbose debug level, which is why it might look a little different to yours).

When you install and configure remote.it, are you doing anything in the Pi's config *other than* `sudo apt install remoteit` that I've not realised? (I'm only installing it, browsing to the pi on port 29999 and then setting up remote.it from the browser).

Maybe @cadpix can share the secret of their deployment?

\` G.

greiginsydney, 2021-04-18:
In the meantime, let's see if we can narrow down where this is falling off the rails.

Can you please edit www/intvlm8r.py to add the logging lines to `def copyNowCronJob()` as shown here?
```python
@app.route("/copyNow")
def copyNowCronJob():
    """
    This 'page' is only one of two called without the "@login_required" decorator. It's only called by
    the cron job/script and will only execute if the calling IP is itself/localhost.
    """

    app.logger.debug('=== Yes, /CopyNow called')

    sourceIp = request.environ.get('HTTP_X_REAL_IP', request.remote_addr)
    if sourceIp != "127.0.0.1":
        app.logger.debug('=== Source IP is bad. Aborting')
        abort(403)

    app.logger.debug('=== Source IP is good. Firing the async tasks now.')

    tasks = [
        copyNow.si(),
        newThumbs.si()
    ]
    chain(*tasks).apply_async()

    res = make_response('OK')
    return res, 200
```

This will help me understand if the scheduled task is firing OK and the correct page is being called.

Update your Copy Hour on the /Transfer page to occur at the top of the next hour, come back then and see what (if anything) is logged in gunicorn.error.

Again, here's mine (and this is the immediate precursor to the celery log extract I posted in my previous comment):

```python
[2021-04-13 15:00:01 +1000] [3947] [DEBUG] GET /copyNow
[2021-04-13 15:00:01 +1000] [3947] [DEBUG] === Yes, /CopyNow called
[2021-04-13 15:00:01 +1000] [3947] [DEBUG] === Source IP is good. Firing the async tasks now.
```

If you see the 'async tasks' message, that will lead me to look more closely at celery.

cadpix, 2021-04-18:
Ours has been running continuously now for almost a year with only one site visit to replace a failed battery, however the transfer from the camera to Pi then Dropbox has been hit and miss. With that said it does eventually get there.
I check it weekly and do need to hit the transfer now button a few times as left on its own it will only seem to transfer around 70 frames. Although it would be great to fix this I find this a small price to pay as I like to keep an eye on it using remoteit and once the transfer from the camera to the pi is done the pics make there way over to Dropbox. This is also much better than a two hour return trip to the camera in my case!
My settings have the camera taking a pic every 15 mins, my suspicion is that once the pi starts the transfer, this is interrupted by the firing of the camera. It’s only a theory unfortunately!

aerialvideographyuk, 2021-04-18:
I seem to be the odd one out :( I have attached some notes of what i did but below is the extract of gunicorn.error that you wanted.

[2021-04-18 23:06:32 +0100] [585] [DEBUG] Ignoring EPIPE
[2021-04-18 23:07:38 +0100] [585] [DEBUG] GET /copyNow
[2021-04-18 23:07:39 +0100] [585] [DEBUG] getCeleryTasks reports there are no activeTasks
[2021-04-18 23:07:39 +0100] [585] [DEBUG] === Yes, /CopyNow called
[2021-04-18 23:07:39 +0100] [585] [DEBUG] === Source IP is good. Firing the async tasks now.

The celery_worker.log has not been updated at all.
If it helps I could leave the pi on and share the remote.it connection with you?

[new camera.docx](https://github.com/greiginsydney/Intervalometerator/files/6332312/new.camera.docx)

greiginsydney, 2021-04-25:
@cadpix:

> I check it weekly and do need to hit the transfer now button a few times as left on its own it will only seem to transfer around 70 frames. Although it would be great to fix this I find this a small price to pay as I like to keep an eye on it using remoteit and once the transfer from the camera to the pi is done the pics make there way over to Dropbox. This is also much better than a two hour return trip to the camera in my case!

What version of intvl8mr are you running? Celery was added (in v4.0.0) to address this issue. I didn't realise it was still causing problems. If you're at 4.0.2 and it's still a problem, please raise a fresh issue and I'll look into it further.

> My settings have the camera taking a pic every 15 mins, my suspicion is that once the pi starts the transfer, this is interrupted by the firing of the camera. It’s only a theory unfortunately!

Yes, I suspect the same. It's definitely better to schedule the copying of the images out of the camera for a period outside of the day's shooting schedule.

If you're not getting enough images out of the camera with each daily schedule, you might find creating a second manual entry will help. I've documented that on the [FAQ page](https://github.com/greiginsydney/Intervalometerator/blob/master/docs/FAQ.md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).

\- G.

greiginsydney, 2021-04-25:
@aerialvideographyuk:

I've just realised we've not checked that/if Celery is running.

Assuming your Pi still has remote.it installed, can you please execute `sudo systemctl status celery` and paste the output? (You'll need to hit "Q" to exit it).

I'm hoping for something that starts like this, with "active (running)" in soothing green. The absence of same gives us somewhere to go digging:

```python
pi@BenchPi3Bplus:~ $ sudo systemctl status celery
● celery.service - Celery Service
   Loaded: loaded (/etc/systemd/system/celery.service; enabled; vendor preset: enabled)
   Active: active (running) since Wed 2021-04-21 10:08:11 AEST; 4 days ago
```

aerialvideographyuk, 2021-04-26:
Looks like it is failing to start.

pi@AVUKcontroller1:~ $ sudo systemctl status celery
● celery.service - Celery Service
   Loaded: loaded (/etc/systemd/system/celery.service; enabled; vendor preset: enabled)
   Active: activating (start) since Sun 2021-04-25 11:15:40 BST; 1min 19s ago
Cntrl PID: 473 (sh)
    Tasks: 3 (limit: 877)
   CGroup: /system.slice/celery.service
           ├─473 /bin/sh -c /usr/local/bin/celery -A intvlm8r.celery multi start --logfile=/var/log/celery/%N.log   --lo           ├─475 /usr/bin/python3 /usr/local/bin/celery -A intvlm8r.celery multi start --logfile=/var/log/celery/%N.log
           └─587 /usr/bin/python3 -m celery -A intvlm8r.celery worker --detach --logfile=/var/log/celery/celery_worker.l
Apr 25 11:15:40 AVUKcontroller1 systemd[1]: Starting Celery Service...

**_I hit q here but then re-ran the command to see if it started._**

pi@AVUKcontroller1:~ $ sudo systemctl status celery
● celery.service - Celery Service
   Loaded: loaded (/etc/systemd/system/celery.service; enabled; vendor preset: enabled)
   Active: failed (Result: timeout) since Sun 2021-04-25 11:17:10 BST; 22h ago
  Process: 473 ExecStart=/bin/sh -c ${CELERY_BIN} -A ${CELERY_APP} multi start --logfile=${CELERYD_LOG_FILE}   --loglevel=${CELERYD_LOG_LEVEL} ${CELERYD_NODES} ${CELERYD_OPTS} (code=killed, signal=TERM)

Apr 25 11:15:40 AVUKcontroller1 systemd[1]: Starting Celery Service...
Apr 25 11:17:10 AVUKcontroller1 systemd[1]: celery.service: Start operation timed out. Terminating.
Apr 25 11:17:10 AVUKcontroller1 systemd[1]: celery.service: Control process exited, code=killed, status=15/TERM
Apr 25 11:17:10 AVUKcontroller1 systemd[1]: celery.service: Failed with result 'timeout'.
Apr 25 11:17:10 AVUKcontroller1 systemd[1]: Failed to start Celery Service.
pi@AVUKcontroller1:~ $

greiginsydney, 2021-04-26:
Awesome! That's progress. Leave it with me.

aerialvideographyuk, 2021-05-08:
Is there anything more I can do to locate the issue?

aerialvideographyuk, 2021-05-11:
wj7106, I haven't heard of the oray intelligent networking client - is that what you are using to be able to connect via 4g instead of using remote.it?  Have you any idea why it is failing?

wj7106, 2021-05-12:
Oray intelligent network client is a virtual networking software, with 4G network, remote access without remote.it, virtual intranet access, mobile phone or PI installation common client, can access each other, but after installation, I can't copy photos to PI, also can't use FTP, I don't know where the error is, The error code of sudo systemctl status cell is the same as yours. Maybe this kind of software will occupy some system ports and other services!

greiginsydney, 2021-05-13:
Hi @wj7106,

Can you please link me to this software, and perhaps the process you're following to install it on the Pi? I've been unable to dupe the issue with remote.it and it's very difficult trying to debug in this fashion.

If Oray is also manifesting the same issue, it might dupe for me and lead me to a common cause (and cure).

Thanks,

\- Greig.

wj7106, 2021-05-13:
https://service.oray.com/question/5063.html
https://pgy.oray.com/download/?icn=pgy_download

 I chose their products. I didn't need to install any client on the system. I used their 4G router directly. After installing the client on my computer, I could build a virtual network and directly access any intranet host on the 4G router. Now there is a problem, Use raspberry zero to send back photos to my computer with vsftpd server. It takes 5 minutes for a photo with a capacity of 20m. The speed of vsftpd transmission seems to be very slow!

greiginsydney, 2021-05-13:
Unfortunately those sites don't appear to translate well to English in my browser.

What were you referring to when you said "but after installation, I can't copy photos to PI", and that celery wouldn't start? It looks to me from one of those links that you've installed something - but it's a generic Linux install, not something specific to the Pi/Raspbian. At least remote.it is supported on the Pi.

aerialvideographyuk, 2021-05-13:
Just for others information - I use a Huawei e8372 USB wifi 4G dongle.  It plugs into a spare 5v outlet on my solar controller and gets turned on by a FET switch that uses the 5v from the spare micro sd socket on the Pi.  The wifi becomes available before the Pi completes it's boot sequence. So far it seems very reliable and the transfer to dropbox is pretty quick.
I can't connect to the Pi from outside it's local wifi range without remote.it and with remote.it I can connect but the copy from camera to the pi fails (celery fails to start). Would it be worth me going to version 3.0.2 - before celery was implemented and trying that with remote.it?

wj7106, 2021-05-14:
Hi, I'd like to know how many ampere hour batteries your USB 4G connects to the USB port of the solar charging controller? How does the FET switch control this? Do you have any details? thank you!

aerialvideographyuk, 2021-05-14:
wj7106 - I'm happy to pass on the details but perhaps do it by mail to free this up for the issue - dave@aerialvideographyuk.com

greiginsydney, 2021-05-15:
@aerialvideographyuk - can you try this please:

1. Edit the file `/etc/default/celery` and change the CELERYD_LOG_LEVEL from "INFO" to "DEBUG"
2. Reboot and confirm celery again fails to start (sudo systemctl status celery)
3. Check if anything's logged in `/var/log/celery/celery_worker.log` and post it here please.

Don't forget to return logging to INFO before returning the intvlm8r into production, as the debug logging is significant.

**Plan B:**
This shortcut might reveal something:
`journalctl | grep "celery"`

It might be interesting to try the same with remote.it:
`journalctl | grep "remote.it"` (or maybe just 'remote')

`journalctl` on its own will dump LOTS. (Press space bar to go to the next page, and Q to quit.)

Paste anything that looks interesting back here...

greiginsydney, 2021-05-16:
I've been doing some more reading about [journalctl](https://www.linode.com/docs/guides/how-to-use-journalctl/).

`journalctl -u celery` looks to give similar output to `journalctl | grep "celery"`.

`journalctl --since "2021-05-15 14:10:10"` will filter the view, as will `journalctl -b`, which only shows from the time of the last boot.

Hopefully something in one of those two logs will further point us to the root cause.

aerialvideographyuk, 2021-05-18:
Again celery did not start and log didn’t update at all.

Here is the output from the journalctl commands

pi@AVUKcontroller1:/var/log/celery $ journalctl | grep "celery"
May 18 18:17:07 AVUKcontroller1 systemd-tmpfiles[110]: [/etc/tmpfiles.d/celery.conf:1] Line references path below legacy directory /var/run/, updating /var/run/celery → /run/celery; please update the tmpfiles.d/ drop-in file accordingly.
May 18 18:17:19 AVUKcontroller1 systemd-tmpfiles[203]: [/etc/tmpfiles.d/celery.conf:1] Line references path below legacy directory /var/run/, updating /var/run/celery → /run/celery; please update the tmpfiles.d/ drop-in file accordingly.
May 18 18:19:05 AVUKcontroller1 systemd[1]: celery.service: Start operation timed out. Terminating.
May 18 18:19:05 AVUKcontroller1 systemd[1]: celery.service: Control process exited, code=killed, status=15/TERM
May 18 18:19:05 AVUKcontroller1 systemd[1]: celery.service: Failed with result 'timeout'.
May 18 18:19:07 AVUKcontroller1 sudo[602]:       pi : TTY=pts/0 ; PWD=/home/pi ; USER=root ; COMMAND=/usr/bin/systemctl status celery
pi@AVUKcontroller1:/var/log/celery $
pi@AVUKcontroller1:/var/log/celery $ journalctl | grep "remote"
May 18 18:17:22 AVUKcontroller1 systemd[1]: Started remote.it agent, manages connections.
May 18 18:17:27 AVUKcontroller1 systemd[1]: Started Publish remoteit.local as alias for AVUKcontroller1.local via mdns.
May 18 18:17:27 AVUKcontroller1 systemd[1]: ***@***.***: Main process exited, code=exited, status=1/FAILURE
May 18 18:17:27 AVUKcontroller1 systemd[1]: ***@***.***: Failed with result 'exit-code'.
May 18 18:17:32 AVUKcontroller1 systemd[1]: ***@***.***: Service RestartSec=5s expired, scheduling restart.
May 18 18:17:32 AVUKcontroller1 systemd[1]: ***@***.***: Scheduled restart job, restart counter is at 1.
May 18 18:17:32 AVUKcontroller1 systemd[1]: Stopped Publish remoteit.local as alias for AVUKcontroller1.local via mdns.
May 18 18:17:32 AVUKcontroller1 systemd[1]: Started Publish remoteit.local as alias for AVUKcontroller1.local via mdns.
May 18 18:17:33 AVUKcontroller1 bash[424]: Established under name 'remoteit.local'
May 18 18:17:34 AVUKcontroller1 systemd[1]: Condition check resulted in fast remote file copy program daemon being skipped.
pi@AVUKcontroller1:/var/log/celery $

All the best,
Dave.

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

greiginsydney, 2021-06-08:
It's been a while but I'm back on the case today.

I've bought a Huawei E8372 dongle & Telstra SIM, and having installed remote.it, **Celery no longer starts after a reboot of the Pi!!**

Hopefully it will be a bit easier to debug now it's happening to me. Finally.

aerialvideographyuk, 2021-06-08:
Hi Greig,

Strange isn’t it.  Good luck with finding it, I’ve gone as far as my knowledge will allow and failed.
As far as my problem goes it occurs even when not using the dongle ie using wifi.
If there is anything I can do then give me a shout.

All the best,
Dave

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

greiginsydney, 2021-06-08:
Hi Dave.

i'd like to understand what's going on a little more, but I have a bandaid/fix: just edit `/opt/remoteit-headless/scripts/remoteit-headless.service` and change the "after" line to add celery, like this:
```python
After=network.target rc-local.service celery.service
```

This just tells remote.it not to start until celery is up.

I'll keep tinkering with it, but I'm hoping that will resolve the issue long-term.

\- G.

wj7106, 2021-06-09:
@aerialvideographyuk
 This solution is really quite easy to use. I don't need FTP or Internet disk upload, because what I shoot is raw format file. My country can't access Google's Internet disk or Dropbox. If I use vsftpd, the speed is too slow. The speed of FTP is really not suitable for raw format. So I go to the scene every 15 days to clean up the lens, check the battery condition and copy photos, This irf520 FET switch with Huawei 8372, remote view equipment
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

Thread 80 (2021-04-11):

Canon's 650d preview ended without response

wj7106, 2021-04-11:
I am now shooting with Canon 500D, Canon 650d and Canon 6D cameras. Canon 650d can't use the preview in the settings. If I use the preview, it will cause no response in 650d. The camera seems to crash when it can't stand by. You must disconnect the USB to use it again. I am now very careful to use the preview function in the camera settings, Canon 500D and Canon 6D will not have this problem. Are the versions of gPhoto2 and libgphoto too low?

greiginsydney, 2021-04-12:
First off I'd check the camera's firmware is the latest. That appears to be [v1.0.5](https://www.canon.com.au/support/sims-content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).

As for the intvlm8r, the installation process updates gPhoto2 and libgphoto to their latest, so that's unlikely to be the problem.

What's logged in gunicorn.error when you try the Preview through the intv8lmr's website? Here's mine:
```python
[2021-04-12 10:38:35 +1000] [559] [DEBUG] POST /camera
[2021-04-12 10:38:36 +1000] [559] [DEBUG] -- Camera Preview selected
[2021-04-12 10:38:36 +1000] [559] [DEBUG] Capturing preview image
[2021-04-12 10:38:37 +1000] [559] [DEBUG] [255, 216, 255, 219, 0, 132, 0, 1, 1, 1]
[2021-04-12 10:38:38 +1000] [559] [DEBUG] GET /camera
[2021-04-12 10:38:38 +1000] [556] [DEBUG] GET /static/preview/intvlm8r-preview.jpg
```

To see if the issue is a bug in the intvlm8r's code:
1. ssh to the Pi
2. `cd /usr/local/share/python-gphoto2/examples`
3. wake the camera
4. `python3 preview-image.py`. (You shouldn't need to `sudo` this)

If that works, can you screen-grab any output from the script and paste it back here?

Here's how it looks on my 60D, the first with Raw selected, and then after changing back to 'Large Normal JPEG':

```python
pi@BenchPi3Bplus:/usr/local/share/python-gphoto2/examples $ python3 preview-image.py
Checking camera config
Cannot preview raw images
pi@BenchPi3Bplus:/usr/local/share/python-gphoto2/examples $ python3 preview-image.py
Checking camera config
Capturing preview image
WARNING: gphoto2: (ptp_usb_getresp [usb.c:514]) PTP_OC 0x9153 receiving resp failed: Camera Not Ready (0xa102)
WARNING: gphoto2: (ptp_usb_getresp [usb.c:514]) PTP_OC 0x9153 receiving resp failed: Camera Not Ready (0xa102)
WARNING: gphoto2: (ptp_usb_getresp [usb.c:514]) PTP_OC 0x9153 receiving resp failed: Camera Not Ready (0xa102)
WARNING: gphoto2: (ptp_usb_getresp [usb.c:514]) PTP_OC 0x9153 receiving resp failed: Camera Not Ready (0xa102)
WARNING: gphoto2: (ptp_usb_getresp [usb.c:514]) PTP_OC 0x9153 receiving resp failed: Camera Not Ready (0xa102)
WARNING: gphoto2: (ptp_usb_getresp [usb.c:514]) PTP_OC 0x9153 receiving resp failed: Camera Not Ready (0xa102)
WARNING: gphoto2: (ptp_usb_getresp [usb.c:514]) PTP_OC 0x9153 receiving resp failed: Camera Not Ready (0xa102)
WARNING: gphoto2: (ptp_usb_getresp [usb.c:514]) PTP_OC 0x9153 receiving resp failed: Camera Not Ready (0xa102)
<class 'memoryview'> 313372
[255, 216, 255, 219, 0, 132, 0, 1, 1, 1]
WARNING: gphoto2: (ptp_usb_getresp [usb.c:514]) PTP_OC 0x9152 receiving resp failed: PTP Operation Not Supported (0x2005)
WARNING: gphoto2: (ptp_usb_getresp [usb.c:514]) PTP_OC 0x911c receiving resp failed: PTP Device Busy (0x2019)
WARNING: gphoto2: (camera_unprepare_canon_eos_capture [config.c:545]) 'ptp_canon_eos_resetuilock (params)' failed: PTP Device Busy (0x2019)
pi@BenchPi3Bplus:/usr/local/share/python-gphoto2/examples $
```

wj7106, 2021-04-12:
The display code is ：

pi@raspberrypi:/usr/local/share/python-gphoto2/examples $ python3 preview-image.py
Checking camera config
Cannot preview raw images
pi@raspberrypi:/usr/local/share/python-gphoto2/examples $ python3 preview-image.py
Checking camera config
Capturing preview image
WARNING: gphoto2: (ptp_usb_getresp [usb.c:514]) PTP_OC 0x9153 receiving resp failed: Camera Not Ready (0xa102)
WARNING: gphoto2: (ptp_usb_getresp [usb.c:514]) PTP_OC 0x9153 receiving resp failed: Camera Not Ready (0xa102)
WARNING: gphoto2: (ptp_usb_getresp [usb.c:514]) PTP_OC 0x9153 receiving resp failed: Camera Not Ready (0xa102)
WARNING: gphoto2: (ptp_usb_getresp [usb.c:514]) PTP_OC 0x9153 receiving resp failed: Camera Not Ready (0xa102)
WARNING: gphoto2: (ptp_usb_getresp [usb.c:514]) PTP_OC 0x9153 receiving resp failed: Camera Not Ready (0xa102)
WARNING: gphoto2: (ptp_usb_getresp [usb.c:514]) PTP_OC 0x9153 receiving resp failed: Camera Not Ready (0xa102)
<class 'memoryview'> 269889
[255, 216, 255, 219, 0, 132, 0, 1, 1, 1]
WARNING: gphoto2: (ptp_usb_getresp [usb.c:514]) PTP_OC 0x9152 receiving resp failed: PTP Operation Not Supported (0x2005)
WARNING: gphoto2: (ptp_usb_getresp [usb.c:514]) PTP_OC 0x911c receiving resp failed: PTP Device Busy (0x2019)
WARNING: gphoto2: (camera_unprepare_canon_eos_capture [config.c:545]) 'ptp_canon_eos_resetuilock (params)' failed: PTP Device Busy (0x2019)

gunicorn:

[2021-04-12 08:59:20 +0800] [413] [DEBUG] POST /camera
[2021-04-12 08:59:22 +0800] [413] [DEBUG] -- Camera Preview selected
[2021-04-12 08:59:22 +0800] [413] [DEBUG] Capturing preview image
[2021-04-12 08:59:22 +0800] [413] [DEBUG] [255, 216, 255, 219, 0, 132, 0, 1, 1, 1]
[2021-04-12 08:59:23 +0800] [414] [DEBUG] GET /camera
[2021-04-12 08:59:26 +0800] [413] [DEBUG] GET /static/preview/intvlm8r-preview.jpg

wj7106, 2021-04-12:
When there is no response, display
pi@raspberrypi:~ $ python3 preview-image.py
python3: can't open file 'preview-image.py': [Errno 2] No such file or directory
pi@raspberrypi:~ $ python3 preview-image.py
python3: can't open file 'preview-image.py': [Errno 2] No such file or directory
pi@raspberrypi:~ $ python3 preview-image.py
python3: can't open file 'preview-image.py': [Errno 2] No such file or directory
pi@raspberrypi:~ $ python3 preview-image.py
python3: can't open file 'preview-image.py': [Errno 2] No such file or directory
pi@raspberrypi:~ $ python3 preview-image.py
python3: can't open file 'preview-image.py': [Errno 2] No such file or directory
pi@raspberrypi:~ $

greiginsydney, 2021-04-12:
This error:

```python
python3: can't open file 'preview-image.py': [Errno 2] No such file or directory
```

is just indicating you're not in the correct folder.

Try `cd /usr/local/share/python-gphoto2/examples` and go again.

wj7106, 2021-04-12:
pi@raspberrypi:/usr/local/share/python-gphoto2/examples $  python3 preview-image.py
Checking camera config
Capturing preview image
<class 'memoryview'> 326226
[255, 216, 255, 219, 0, 132, 0, 1, 1, 1]
WARNING: gphoto2: (ptp_usb_getresp [usb.c:514]) PTP_OC 0x9152 receiving resp failed: PTP Operation Not Supported (0x2005)
WARNING: gphoto2: (ptp_usb_getresp [usb.c:514]) PTP_OC 0x911c receiving resp failed: PTP Device Busy (0x2019)
WARNING: gphoto2: (camera_unprepare_canon_eos_capture [config.c:545]) 'ptp_canon_eos_resetuilock (params)' failed: PTP Device Busy (0x2019)

wj7106, 2021-04-13:
I just tested it again. If preview is enabled and a JPG low resolution photo is obtained, but the reflector of the camera is always on and in video mode. Only when you take out the camera battery or unplug the USB cable or set the camera to video shooting and then set the photo mode, the reflector of the camera will turn off and the camera will exit video mode and return to normal, Can automatically 30 seconds standby!

greiginsydney, 2021-04-13:
Is this your problem?

["On Canon EOS / EOS M make sure the preview mode on the camera is in "still image" mode, not in "movie mode"."](http://www.gphoto.org/doc/remote/)

wj7106, 2021-04-13:
Canon 650d uses this system, can't use the preview in the camera settings, if used, the camera's USB has been occupied by the program, the camera can't automatically exit the preview, there seems to be a program in the background has been occupied, can only manually disconnect the USB, or manually take out the battery. Please help me, can only change the camera to solve this problem?

greiginsydney, 2021-04-14:
Given the evidence, your issue is one of bad config in the camera, a bug in the camera's firmware, or a problem in gphoto2 - all of which are outside of my control. (I don't think you've confirmed yet that the camera's firmware is v1.0.5?)

If you can execute the following and send me the output, I'll update the code to disable the Camera page's Preview button on the EOS 650D, and I'll add a note to that effect on the camera compatibilty page.

```python
pi@BenchPi3Bplus:~ $ cd /usr/local/share/python-gphoto2/examples
pi@BenchPi3Bplus:/usr/local/share/python-gphoto2/examples $ python3 camera-summary.py
```

\- G.

wj7106, 2021-04-14:
yes,firmware is V1.0.5

pi@raspberrypi:/usr/local/share/python-gphoto2/examples $ python3 camera-summary.py
Summary
=======
Manufacturer: Canon Inc.
Model: Canon EOS 650D
  Version: 3-1.0.5
  Serial Number: a87c7b4f5e6d41b793b438ad7a8828b
Vendor Extension ID: 0xb (2.0)

Capture Formats: JPEG
Display Formats: Association/Directory, Script, DPOF, MS AVI, MS Wave, JPEG, CRW, Unknown(b103), Unknown(bf02), Defined Type, Unknown(b104), Unknown(b105)

Device Capabilities:
        File Download, File Deletion, File Upload
        No Image Capture, No Open Capture, Canon EOS Capture, Canon EOS Capture 2

Storage Devices Summary:
store_00020001:
        StorageDescription: SD
        VolumeLabel: None
        Storage Type: Removable RAM (memory card)
        Filesystemtype: Digital Camera Layout (DCIM)
        Access Capability: Read-Write
        Maximum Capability: 128010158080 (122080 MB)
        Free Space (Bytes): 126523408384 (120662 MB)
        Free Space (Images): -1

Device Property Summary:
Property 0xd402:(read only) (type=0xffff) 'Canon EOS 650D'
Property 0xd407:(read only) (type=0x6) 1
Property 0xd406:(readwrite) (type=0xffff) 'Unknown Initiator'
Property 0xd303:(read only) (type=0x2) 1
Battery Level(0x5001):(read only) (type=0x2) Enumeration [100,0,75,0,50] value: 100% (100)

pi@raspberrypi:/usr/local/share/python-gphoto2/examples $

greiginsydney, 2021-04-14:
OK, the 'blockPreview' code is in. It will be in the next release, to be 4.1.0 (currently the Branch "Bugs-2104").

Thanks for your help with this.

wj7106, 2021-04-14:
I tested for one night. The camera is set to 30 seconds standby. When using the preview function, the camera will not enter the standby mode in 30 seconds. Instead, it adds 5 minutes on the basis of 30 seconds and becomes 5 minutes and 30 seconds standby. As long as it enters the standby mode and wakes up again, the camera will be in normal condition. If the preview function is not used, the camera will automatically enter the standby mode in 30 seconds after taking a picture. This is only a problem Only this 650d will appear, if it is 500D and 6D, using preview, it will enter the standby mode according to the set standby time, without adding 5 minutes!

Closed 2021-04-14.

Thread 82 (2021-04-19):

Time service with Arduino GPS ？

wj7106, 2021-04-19:
Can we use the Arduino GPS timing method to directly control the time when Arduino triggers the camera without raspberry pie board, and use an LCD display with buttons to directly control it, so that we can directly operate and set it in the place without network. After all, we seldom change the parameters after setting the parameters of the camera

greiginsydney, 2021-04-20:
But the Arduino doesn't have a GPS! It doesn't even know what the time is, which is why we had to add the separate real-time clock (RTC) chip/board.

Sure you could connect a GPS 'shield' and do away with the Pi and the RTC, but you'll be losing all of the remote admin capability and the image transfers, and probably also at the expense of the low-power operation we designed in from the outset.

The resulting device wouldn't be an intvl8mr, but simply a different kind of intervalometer.

\- G.

wj7106, 2021-04-20:
OK, I see. Thank you

Closed 2021-04-20.

Thread 84 (2021-06-05):

When the Pi syncs to NTP it doesn't update the Arduino

greiginsydney, 2021-06-05:
If NTP is the master time source, then when the Pi is updated, it needs to also update the Arduino.

(This is also going to address the thorny issue of DST).

greiginsydney, 2021-07-09:
Resolved in [release 4.1.1](https://github.com/greiginsydney/Intervalometerator/releases/tag/v4.1.1)

Closed 2021-07-09.

Thread 88 (2021-08-05):

TimeLimitExceeded(1800) Message.

peterjbaylis, 2021-08-05:
Hi Greig;

I am getting a "TimeLimitExceeded(1800)" Message when transferring image files from the camera to the pi.

Here is a screen shot of the message on the web service.

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

Can I change this limit to allow the copy and transfer process to complete in one session?

Cheers Peter.

greiginsydney, 2021-08-05:
Hi Peter,

I deliberately baked in a 30-minute timeout so a hung process won't keep holding up resources. It was meant to be a safety-net, but you're not the first person to hit it. Whilst it's easy to change this in intvlm8r.py (roughly around line 1940, depending on the release), it'll be over-written each time you update, so you'd need to remember that:

```python
@celery.task(time_limit=1800, bind=True)
def copyNow(self):
```

My preference is to create one or more extra copy schedules, as outlined in [this FAQ response](https://github.com/greiginsydney/Intervalometerator/blob/master/docs/FAQ.md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), although that's only valid if the Pi is always running.

Let me know which way you go and if that works for you (and doesn't cause other problems).

\- G.

peterjbaylis, 2021-08-07:
Thanks Greig;

I found two instances of this variable at lines 1467 and 1521 in the version of intlvm8r.py that I have installed.
I have changed them both to 7200 to give the pi more time to do its thing.

Thanks for the quick response to this query.

Cheers Pete.

greiginsydney, 2021-08-07:
Without seeing the code to confirm it, I expect the first appearance is the function that copies the files:

```python
@celery.task(time_limit=1800, bind=True)
def copyNow(self):
```

... whilst the second is the bit that creates the thumbnails of them:

```python
@celery.task(time_limit=1800, bind=True)
def newThumbs(self):
```

Let me know how you go.

peterjbaylis, 2021-08-09:
Hi Greig;

Thanks for that info, this has fixed my TimeLimit Exceeded problem.
I have now been able to get all the pi images transferred to my NAS.

**New topic.**
I am getting some forbidden filename messages during the transfer process.
See message below.

_2021/08/08 19:35:39 Uploading /home/pi/photos/DCIM/101CANON/IMG_7952.JPG
2021/08/08 19:35:39 Error uploading 550 IMG_7952.JPG: Forbidden filename,_

I can see these messages in the transfer log.

If I run the piTransfer.py script from the console then it copies some of the files it originally flagged as "Forbidden Filename"
I could get as many as 20-50 of these errors during one transfer session.
If I simply re run the piTransfer script it will successfully copy a few more of the files.
If I do this multiple times then eventually it copies all of the files from the pi to my NAS.

Not sure if this error is due to a problem with the Raspbian FTP process or it could be my QNAP NAS not playing well with the Raspberry pi.
Have you seen this before using FTP on the pi?

Cheers Pete.

greiginsydney, 2021-08-09:
Hey Pete,

We happen to have a QNAP NAS here and I use that for my FTP testing, and I've encountered no problems with it.

What's your firmware version? Ours is 4.5.4.1741 and we don't update it often. If yours is years behind it might be worth an update.

As the 550 error is coming back from the QNAP and it's intermittent, my first suggestion is to put a pause between each file, in case it's just being overwhelmed. Just add `time.sleep(2)` at the top of the loop, like this (at around line 240):

```python
for needupload in newFiles:
    time.sleep(2)
    log("Uploading " + needupload)
```

If that works out for you I'll add it into the script (and perhaps for all upload types).

\-G.

peterjbaylis, 2021-08-10:
Hi Greig;

Adding the sleep time has made a difference it does not fail so frequently now. It is still failing sometimes. I just transferred 120 images and had to restart the transfer process about 6 times for it to complete all the image file transfers.
I will try playing with the sleeptime (x) number to see if extending it to 3 or 4 will eliminate the problem entirely.

Part of my problem is the the pi is very busy as it is trying to build thumbnails for 4000+ images.
Is there some way I can tell the pi to not build the thumbnails or are the thumbnails a dependency for another downstream process?

Pete.

greiginsydney, 2021-08-10:
Hi Pete,

> Part of my problem is the the pi is very busy as it is trying to build thumbnails for 4000+ images.

The thumbnail creation process is only there for the benefit of the /thumbnails page, but copying and thumbs are tasks executed sequentially - they shouldn't be happening in parallel.

If you want to suppress the thumb creation process entirely, just add a 'return' as shown below in intvlm8r.py and 'newThumbs' will abort as soon as it's called:

```python
@celery.task(time_limit=1800, bind=True)
def newThumbs(self):
    return
    app.logger.info('newThumbs() entered') #This logs to /var/log/celery/celery_worker.log
```

Another couple of options for you:
- if you have local power, consider upgrading the Pi from a Zero to a 3 or 4, which will give it a considerable amount of extra grunt. I've documented that [here](https://github.com/greiginsydney/Intervalometerator/blob/master/docs/advancedConfig.md#other-pi-models).
- if the Pi's drowning under old images since transferred, enable 'deleteontransfer' and the Pi will delete them after they've been successfully copied to your FTP server/elsewhere. ([Documented here](https://github.com/greiginsydney/Intervalometerator/blob/master/docs/FAQ.md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)).

\- G.

peterjbaylis, 2021-08-30:
Greig;

Thanks for the follow up.

Cheers Pete.

On Mon, 30 Aug 2021 at 07:42, Greig Sheridan ***@***.***>
wrote:

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

--
Peter

Closed 2021-08-29.

Thread 89 (2021-08-07):

Preview the problem in raw format

wj7106, 2021-08-07:
You have been shooting in raw format, but if you want to preview, you can only display the photos after setting JPG format, and then set it back to raw format. Can you preview directly in raw format?

greiginsydney, 2021-08-07:
Unfortunately Gphoto doesn't support previewing when you're shooting in raw mode, so your experience is correct.

Try it yourself using one of the example scripts:

```python
pi@BenchPi3BPlus:~/www $ cd /usr/local/share/python-gphoto2/examples
pi@BenchPi3BPlus:/usr/local/share/python-gphoto2/examples $ sudo python3 preview-image.py
Checking camera config
Cannot preview raw images
pi@BenchPi3BPlus:/usr/local/share/python-gphoto2/examples $
```

Leave it with me and I'll see how easy it is to disable the Preview button when you're set for raw, or provide some better user feedback.

\- G.

greiginsydney, 2021-08-08:
It seems this is specific to Canon cameras. The Nikon I have here *does* go through the motions of creating a preview - but all you get on screen is a black image. Safest to disable the button for all...

wj7106, 2021-08-08:
I'm all Canon cameras. This preview function is very good. I can view the shooting situation at any time. I can keep this preview function. If I can't view it directly in raw format, I have to manually switch to JPG format and then switch back to raw!

greiginsydney, 2021-08-08:
Don't worry I'm not removing the feature, just disabling the button when it's not applicable. A popup explains why the button's disabled:

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

websocketing, 2021-08-10:
@wj7106 I'm glad to see you pay attention to me. Are you from China? Can you tell me your email, QQ, wechat and other contact information? We can talk.

wj7106, 2021-08-10:
> @wj7106很高兴看到你关注我。你是从中国来的吗？能告诉我你的邮箱、QQ、微信等联系方式吗？我们可以谈。

wj7106@21cn.com

Closed 2021-08-11.

Thread 91 (2021-08-28):

Delete images from camera.

peterjbaylis, 2021-08-28:
Hi Greig;

I have seen the FAQ response which shows how to add  **delete after copy** and **delete after transfer** options.

Is there a command I can run from the pi console to delete camera images directly from the SD card while it is still in the camera?
I have set my interval to one shot every minute so I am getting 600 images per day and even if I only use jpegs then I am having to swap out the camera SD card every 10-12 days.
I will set the delete after copy and delete after transfer options in the **intvlm8r.ini file** but I still want to be able to manually clean out the SD card occasionally.

Cheers Pete.

wj7106, 2021-08-29:
My camera and/or Pi are running low on storage. How can I delete old images?
Hidden config options in the INI file will let you delete images off the camera after they've been safely transferred to the Pi, and after they've been safely uploaded to your nominated "off-box" destination.

This option isn't visible in the browser, so to change it you need to SSH to the Pi. Browse to /home/pi/www/ and edit the file intvlm8r.ini. Set the two highlighted options On or Off as required. If the option's not already there, just add the line in by hand:

[Global]
file created = 05 Jan 2020
thumbscount = 20

[Transfer]
tfrmethod = Dropbox
dbx_token = thequickbrownfoxjumpsoverthelazydogorsomething
transferday = Daily
transferhour = 00
sftpserver = 20.20.20.20
sftpuser = intvlm8r
sftppassword = mysecretsftppassword
sftpremotefolder = upload/GreyBox/
**deleteaftertransfer = On**

[Copy]
copyday = Daily
copyhour = 00
**deleteaftercopy = On**

greiginsydney, 2021-08-29:
Jim's included an example app in python-gphoto2 that will do the job nicely:

```bash
cd /usr/local/share/python-gphoto2/examples
sudo python3 clear-space.py 95
```

The number is telling it the amount of space to free up. Beware I think there's a bug in it: I entered 100 and it loops forever, trying to free up space that's not avalable. So choosing a lower number is a good idea.

greiginsydney, 2021-08-29:
Is this OK to close now Pete?

peterjbaylis, 2021-08-30:
Hi Greig;

The **clear-space.py** script throws the following error;

__pi@picam-03:/usr/local/share/python-gphoto2/examples $ sudo python3 clear-space.py 95
WARNING: gphoto2: (gp_context_error) Could not detect any camera
Traceback (most recent call last):
  File "clear-space.py", line 113, in <module>
    sys.exit(main())
  File "clear-space.py", line 61, in main
    camera.init()
gphoto2.GPhoto2Error: [-105] Unknown model_

I will try waking up the camera first via the intvlm8r web service and have another go.

Cheers Pete.

peterjbaylis, 2021-08-30:
Greig;
Waking up the camera seems to have worked...
The script now runs and deletes images, when the script ends it shows "Camera now has 95.0% free space.

This will save having to extract the card to manually delete images.
I have also set the "**delete aftercopy**" and "**delete aftertransfer**" options in the **intvlm8r.ini** file so house keeping should take a lot less time from this point forward.

Thanks again for your quick turnaround on the question.

Cheers Pete.

peterjbaylis, 2021-08-30:
Greig;

Please close this issue at your convenience.

Cheers Pete.

greiginsydney, 2021-08-30:
Done.

Closed 2021-08-30.

Thread 92 (2021-08-29):

About the development board using the same function

wj7106, 2021-08-29:
Because the USB speed of raspberry pi zero is too slow and there is no external wifi antenna, the signal is often bad, so I bought a banana PI bpi-m2+ board at a low price, which has stronger performance than the zero board. See the function introduction, which also matches the GPIO pin function of raspberry pi, but now I have a problem. After the raspberry pi image is installed in banana PI bpi-m2 +, the intvlm8r program is also installed correctly, The GPIO cable is also connected according to the zero pin, but he doesn't work with Arduino and can't communicate with Arduino board. I don't know what went wrong.

greiginsydney, 2021-08-29:
Really hard to know for sure, as it could be any number of incompatibility issues, hardware OR software - or both.

If it can't talk to the Arduino it's probably going ot be related to the I2C bus.

SSH to the Pi and run the setup script with the test option and it might reveal some problems:

```bash
cd ~
sudo ./setup.sh test
```

Make sure the first part of the output matches this:

```bash
TEST!
PASS: /etc/nginx/sites-available/intvlm8r exists
PASS: /etc/systemd/system/intvlm8r.service exists
PASS: /etc/systemd/system/cameraTransfer.service exists
PASS: /etc/systemd/system/piTransfer.service exists
PASS: /etc/systemd/system/setTime.service exists
PASS: /etc/systemd/system/redis.service exists
PASS: /etc/systemd/system/celery.service exists
PASS: i2c_arm_baudrate is present in /boot/config.txt
PASS: i2c-dev installed in /etc/modules

If the Arduino is connected & programmed it will show as "04" in the top line below:
     0  1  2  3  4  5  6  7  8  9  a  b  c  d  e  f
00:          -- 04 -- -- -- -- -- -- -- -- -- -- --
10: -- -- -- -- -- -- -- -- -- -- -- -- -- -- -- --
20: -- -- -- -- -- -- -- -- -- -- -- -- -- -- -- --
30: -- -- -- -- -- -- -- -- -- -- -- -- -- -- -- --
40: -- -- -- -- -- -- -- -- -- -- -- -- -- -- -- --
50: -- -- -- -- -- -- -- -- -- -- -- -- -- -- -- --
60: -- -- -- -- -- -- -- -- -- -- -- -- -- -- -- --
70: -- -- -- -- -- -- -- --

PASS: The Pi is NOT an AP
```

\- G.

wj7106, 2021-08-29:
PASS: i2c_arm_baudrate is present in /boot/config.txt
PASS: i2c-dev installed in /etc/modules

If the Arduino is connected & programmed it will show as "04" in the top line below:
     0  1  2  3  4  5  6  7  8  9  a  b  c  d  e  f
00:          -- -- -- -- -- -- -- -- -- -- -- -- --
10: -- -- -- -- -- -- -- -- -- -- -- -- -- -- -- --
20: -- -- -- -- -- -- -- -- -- -- -- -- -- -- -- --
30: -- -- -- -- -- -- -- -- -- -- -- -- -- -- -- --
40: -- -- -- -- -- -- -- -- -- -- -- -- -- -- -- --
50: -- -- -- -- -- -- -- -- -- -- -- -- -- -- -- --
60: -- -- -- -- -- -- -- -- -- -- -- -- -- -- -- --
70: -- -- -- -- -- -- -- --

PASS: The Pi is NOT an AP

greiginsydney, 2021-08-29:
And the Arduino is connected and awake?

wj7106, 2021-08-29:
Yes, Arduino is powered on and is in emergency mode. Four photos are taken in an hour. The web page can't get the time of the clock module, can't wake up the camera, can't set the interval

greiginsydney, 2021-08-29:
The circuits for both appear to confirm that the I2C interface is on the same pins, so that's a good start.

Are you using a ribbon cable to join the BananaPi to the intvlm8r PCB? Is there any chance that any of the pins are reversed/transposed on the ribbon cable? (I suspect probably not, otherwise you'd have 5V and 3.3V swapped over, which would be quite catastrophic.)

I think it's going to be a challenge to reverse-engineer these sorts of problems with a Pi clone. I'd go Googling for examples of I2C projects for the BananaPi and see if there's any special settings required for it.

wj7106, 2021-08-29:
Looking forward to good news, thank you

wj7106, 2021-08-29:
Looking forward to good news, thank you

wj7106, 2021-08-29:
pi@bpi-iot-ros-ai:~ $ sudo i2cdetect -y 0
     0  1  2  3  4  5  6  7  8  9  a  b  c  d  e  f
00:          -- 04 -- -- -- -- -- -- -- -- -- -- --
10: -- -- -- -- -- -- -- -- -- -- -- -- -- -- -- --
20: -- -- -- -- -- -- -- -- -- -- -- -- -- -- -- --
30: -- -- -- -- -- -- -- -- -- -- -- -- -- -- -- --
40: -- -- -- -- -- -- -- -- -- -- -- -- -- -- -- --
50: -- -- -- -- -- -- -- -- -- -- -- -- -- -- -- --
60: -- -- -- -- -- -- -- -- -- -- -- -- -- -- -- --
70: -- -- -- -- -- -- -- --
pi@bpi-iot-ros-ai:~ $ sudo i2cdetect -y 1
     0  1  2  3  4  5  6  7  8  9  a  b  c  d  e  f
00:          -- -- -- -- -- -- -- -- -- -- -- -- --
10: -- -- -- -- -- -- -- -- -- -- -- -- -- -- -- --
20: -- -- -- -- -- -- -- -- -- -- -- -- -- -- -- --
30: -- -- -- -- -- -- -- -- -- -- -- -- -- -- -- --
40: -- -- -- -- -- -- -- -- -- -- -- -- -- -- -- --
50: -- -- -- -- -- -- -- -- -- -- -- -- -- -- -- --
60: -- -- -- -- -- -- -- -- -- -- -- -- -- -- -- --
70: -- -- -- -- -- -- -- --
pi@bpi-iot-ros-ai:~ $

wj7106, 2021-08-29:
bus = SMBus(1) #Initalise the I2C bus
# This is the address we setup in the Arduino Program
address = 0x04
 I change SMBus (1) to SMBus (0) and you can use it

greiginsydney, 2021-08-29:
Ha! Looks like they must have accidentally(?) transposed the two I2C buses??

Well done on finding the problem!

wj7106, 2021-08-30:
After testing one night, it was found that he could not sleep according to the set time, nor could he control the restart

greiginsydney, 2021-08-30:
Sorry, not sure I understand you there.

Are you suggesting the Arduino isn't able to shutdown the Pi? If so, that indicates there are more pin incompatibilities in the Banana Pi, or the way I'm using an IO pin to trigger a shutdown isn't supported in its operating system. Check out the `dtoverlay` commands in [setup.sh](https://github.com/greiginsydney/Intervalometerator/blob/master/Raspberry%20Pi/setup.sh).

(I've written separately about that functionality [here](https://greiginsydney.com/pi-shutdown-button/).)

\- G.

Closed 2021-08-29.

Thread 97 (2021-10-04):

Re cadpix defrost solution.This would be very useful, our Intvlm8r is running on solar in a remote location to see a building go up over two years. We have it working over 4G and we can access the UI (via remote.it) and it can upload the pics to dropbox which works well.

peterjbaylis, 2021-10-04:
This would be very useful, our Intvlm8r is running on solar in a remote location to see a building go up over two years. We have it working over 4G and we can access the UI (via remote.it) and it can upload the pics to dropbox which works well.
It would be great to be able monitor the system / battery voltage and set a low threshold warning so we can anticipate a 12v battery replacement if needed.
Our setup also utilises a PTC heater (common in security cameras and cheap too!) to defrost the front glass on the housing. This only draws around an amp and clears the frost in winter, being able to see some temp data would be useful for anticipating when to kick this in or maybe this could be switched on by the RPI in the future? We currently use a digital timer switch to switch the heat on but this would be a fantastic feature addition to the Intvlm8r.

_Originally posted by @cadpix in https://github.com/greiginsydney/Intervalometerator/issues/8#issuecomment-653770139_

Thread 98 (2021-10-04):

Version n+1 wish list.

peterjbaylis, 2021-10-04:
Hi Greig and Rocky.

If you are looking for suggestions or enhancements see below for my thoughts.
[enhancement wish list.txt](https://github.com/greiginsydney/Intervalometerator/files/7277440/enhancement.wish.list.txt)

Enjoy your "retirement"

Cheers Pete.

greiginsydney, 2021-10-04:
Hi Pete,

The good news is that some of this is already available and others are underway:

- Battery voltage.

This is being developed at the moment. It will require either a new PCB, or a small (postage-stamp sized) daughterboard to add the extra components to read the voltage. The "Gen 2" PCB is a CY2022 project I'm already prototyping, and the daughterboard I'm hoping to have available before Christmas 2021.

Initially it will only report the hourly voltage over a rolling 24-hour period, but a subsequent release will add alarming whereby if the voltage falls outside of user-set limits the Arduino will wake the Pi to send an off-box alarm.

- Temperature in camera enclosure. This will also require a sensor for temp monitoring.

The intvlm8r currently reports both the temperature of the Pi's die, and also the value reported by the real time clock's in-built temperature sensor, the latter of which should be a very close approximation of the real internal temperature. Are you finding that value not sufficiently accurate?

At about the same time as battery alarming is added I'll also be doing same for thermal limits.

- pi status or currently running process.

What sort of status info are you wanting to see, and how would that be presented to the user? (This is in addition to the progress messages below?)

- A more robust ftp process.

That one's going to be a challenge to resolve for you as I'm not able to reproduce problems, and there's always the question as to which end of the line is causing this - or if it's the bearer in the middle. Let me stick a post-it on my monitor...

- A surface mount version of the PCB

To some degree that's coming as part of "Gen 2", and will be offered with the SMT components populated (as a "bare-bones" board) as well as [fully built and tested](https://www.ebay.com.au/itm/265085430681). The board won't be any smaller, as I'm adding extra functionality with the voltmeter components as well as a switched USB power supply for an off-board 4G dongle (which lives under the Pi).

- Setup pcb to enable easy configuration with a full size pi

I use a Pi 3B+ on my bench when I'm developing (purely for speed of reboots), and it works well. (Santa might upgrade me to a 4). Because the Pi's all use the same GPIO header this is a really easy update - but as you say, is most likely limited to those who have mains power.

Here's some more info on how to do that: [Other Pi Models](https://github.com/greiginsydney/Intervalometerator/blob/master/docs/advancedConfig.md#other-pi-models)

- Provide better progress messages on the intervalometer web service.

When background tasks like copies and transfers are running, your browser polls the Pi every 2s for an update, and as a result the updates jump rather than be increment singularly. (e.g. "now copying 2 of 80... 6 of 80... 10 of 80").

I'm trying to provide feedback to the user but at the same time not burden the poor little Pi Zero with overhead that's distracting from the tasks at hand. Is there value to the on-screen copy info including a filename and not just "image x of y"? What else does it need?

- Image time stamps embedded with the image

I added "rename on copy" in v4.3.0, allowing you to add time and date values to the filename when it's copied across from the camera. This uses the time and date stamps from the \*file\* and not the EXIF data.

&nbsp;<br>
> Enjoy your "retirement"

Yeah, ta. While we're locked down the intvlm8r is now my M-F "job" - as you might see from all the [release updates](https://github.com/greiginsydney/Intervalometerator/releases) this year. I'm hoping to be allowed out to play soon, and maybe one day even travel!

\- G.

aerialvideographyuk, 2021-10-05:
Hi Greig,  not sure if I mentioned it before but it would be good if the transfer from camera to pi took place before the transfer to dropbox etc.  The extra time taken would be of little consequence but having all of the current images a day earlier would be great.  Just for info, my camera has been running outside now for around 3 months on solar/4g without missing a single frame. Battery voltage hasn't been an issue so far, even with the british weather.

peterjbaylis, 2021-10-05:
Hi; aerialvideographyuk;

The version of intvlm8r I am running already has this behaviour. I have the
pi set to wake up at 7:00pm each evening, the first thing it does is to
copy images from the camera to the pi and then it transfers those images
via ftp to my local storage.
The camera to pi process always completes with no issues, however the
piTransfer process almost always fails probably due to poor WiFi and a slow
NAS. I have mains power available so battery life is not an issue for me.
I have ordered a Raspberry Pi Ver 4 which I understand supports the 5G WiFi
band so I am expecting this will fix some or all of my piTransfer  issues.
My intvlm8r has been running for about 6 months now but we have only seen
site works for our new build in the last 4 weeks so there is a lot of clean
up to do on the NAS to dump all the boring bits.

Cheers Pete.

On Tue, 5 Oct 2021 at 19:30, aerialvideographyuk ***@***.***>
wrote:

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

--
Peter

aerialvideographyuk, 2021-10-05:
OK - I still haven't got round to updating to the latest version so I will have to do that.  Like you I get the pi to wake up at 7pm but I only get the previous days images plus a few of the images from the current day.  The rest of the images I get the next day.  I haven't got the luxury of mains and wifi so solar and 4g is what I use.  I transfer to a dropbox free account and then use a windows script to move to my local NAS.  That seems more reliable than ftp to my NAS.

SchmidL, 2021-12-22:
Hi,

Do I understand this "issue" as a general wish list of future functions, which can be discussed and I would also like to help to implement?

One thing which comes to my mind and could potentially be beneficial is a second communication channel to the outside world. I think in general of a LoRa connection. I see three benefits, first, a mobile connection can be turned off when just telemetry is transferred, and secondly, when the power is too low for all the main components, a backup communication can be established. As a third point, the LoRa connection could be used as a backup, in case the main channel is broken. So I still get notified that my camera takes pictures, but just at the moment they cannot be transferred (broken 4G-Stick, broken Network connection, etc.)

What do yo think?

greiginsydney, 2021-12-22:
Hi @SchmidL , yes this is a general wish-list "issue", and I welcome suggestions and offers to help.

My main goal in any project enhancements is to work within the current hardware constraints, so the new features are available to all existing users. Having said that, a "Gen 2" version of the board is slowly taking shape in the background, as referenced earlier.

LoRa interests me, but to add LoRa will require more hardware, and presumably also another micro-controller. Do you know of any LoRa-enabled boards that are pin-compatible with the Arduino Pro Mini, so it could be a drop-in replacement? (It will need to have IO pins that run at 3.3V because of the I2C interface to the Pi).

If it's another board, have you thought about how it might be interfaced with the existing circuit? The Arduino and Pi will run down to an input voltage of ~6V (which is a VERY flat 12V battery!), and when I can get the battery monitoring alarm built and coded the intvlm8r will have called for help long before it reaches that point - so having LoRa as a backup comms channel mightn't be all that beneficial if there's not enough power to take photos, suck images from the camera, or run the Pi.

Also, if we're using the intvlm8r as a LoRa sender, it will presumably need a companion device that is the receiver with presumably its own uplink to the Internet. Do those exist commercially, or will that still need to be created and coded?

Perhgaps we should spin LoRa into a free-standing issue if you'd like to banter it around some more?

\- G.

greiginsydney, 2024-04-21:
> Hi Greig, not sure if I mentioned it before but it would be good if the transfer from camera to pi took place before the transfer to dropbox etc...

This request has been added in [Release 5.0.0](https://github.com/greiginsydney/Intervalometerator/releases/tag/v5.0.0), with "Transfer after Copy":
<p align="center">
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
 </p>

Thread 100 (2021-10-13):

The "Next shot" may be incorrect after changing interval settings

greiginsydney, 2021-10-13:
The "Next shot" value on the main page isn't correctly being calculated if you change the interval settings.

This only happens if the current time is within the daily start/end window, and today is \*not\* a shooting day.

In this example, today is Wednesday and I've just updated the shooting schedule to Tuesday, Thursday & Friday, between 8am-6pm:

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

... however the main page indicates we won't start shooting until 2pm on Thursday:

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

The impact is worse the later in the day you do this, as you'll lose the shots that would have been taken earlier in the day. (In this example, shooting _should_ start at 0800 on Thursday, but it won't start until 1400).

<hr/>

**Cause:** the minutes value is correctly being set to 0, but the hour is not being reset.
**Workaround:**
- only change the interval settings on a shoot day (or add the day of your change to the shooting days, at least as an interim measure).
- make any changes as early in the day as possible.

**Fix:** add this `nextHour = StartHour;` line to the Arduino sketch as shown:

Before:
```c++
byte nextShootDay = 0b0000001 << (nextDay); //Sunday = bit 1 to align with clock's day ordering
  while (!(nextShootDay & ShootDays))
  {
    nextShot = 0; //Next shot isn't today, so reset this to the top of the hour
    nextDay++;
```

After:
```c++
byte nextShootDay = 0b0000001 << (nextDay); //Sunday = bit 1 to align with clock's day ordering
  while (!(nextShootDay & ShootDays))
  {
    nextShot = 0; //Next shot isn't today, so reset this to the top of the hour
    nextHour = StartHour; //... and at StartHour
    nextDay++;
```

I'll be soak-testing this thoroughly before releasing it in a fortcoming update.

\- G.

greiginsydney, 2021-12-03:
Fixed in [release 4.4.0](https://github.com/greiginsydney/Intervalometerator/releases/tag/v4.4.0)

Closed 2021-12-03.

Thread 101 (2021-11-03):

Add a function button to delete camera photos in the transfer page

wj7106, 2021-11-03:
I want to add a function button to delete camera photos in the transfer page instead of manually SSH to raspberry every time and enter sudo python3 clear-space.py 95 code. How can I add this function? Thank you!

greiginsydney, 2021-11-03:
I've deliberately avoided exposing some of the more "powerful" functionality in the browser interface as a way of reducing the risk of someone doing something they might later regret. This is serves as a security mechanism, limiting the damage that can be done by a malicous actor who gains access to the intvlm8r.

Check out the [FAQ](https://github.com/greiginsydney/Intervalometerator/blob/master/docs/FAQ.md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) for how to enable the "DeleteAfterCopy" and "DeleteAfterTransfer" features. These only delete an image AFTER it's been confirmed to have been successfully transferred off the camera or Pi.

Hopefully they'll do what you're after?

\- G.

wj7106, 2021-11-03:
I see. It's very thoughtful. Thank you for your reply!

Closed 2021-11-10.

Thread 103 (2021-11-25):

Long-term night shooting

cca8uk, 2021-11-25:
I'm looking around for the best system for my needs, and this is very nearly it, so congrats on a fab project.

The one additional thing I need for my long-term setup is the ability to shoot only at night.  Setting up a fixed start/end time for triggers therefore isn't practical solution.  To that end I wondered whether you had considered adding the ability to track sunset/sunrise times across the year?  This could be done by either the user having to add a reference table of times/date, or by incorporating a light sensor into the setup/code.

Any thoughts on workarounds or how,/whether this is achievable would be of great interest.

Chris

greiginsydney, 2021-11-25:
Hi Chris,

Thanks for the compliment.

As luck would have it, I'm in final testing of an update I'm calling "STM", aka "shoot through midnight": the ability to set a start time "later" in the day than the end time. (No, it doesn't actually have that at the moment - it's an [issue](https://github.com/greiginsydney/Intervalometerator/issues/12) I've wanted to address for ages). That would give you the crude version of what you're after, but would require tweaking through the seasons, and you'd always end up with some unwanted daylight shots.

Can you tell me more about your application? You want it to start shooting every 'n' minutes from sunset and not stop until sunrise? It sounds like it'd be a real challenge to change the intvlm8r to do that, not the least of which is because the start/stops are all currently based upon an hour value, and not hour:minute - but I'm open to the idea...

\- G.

cca8uk, 2021-11-26:
The STM would be a must for my setup if it’s based on a timer.  I’m basically looking at options for taking photos every ‘n’ minutes between dusk and dawn for the long-term. The photos are of nocturnal insects visiting a light which will be later identified for monitoring purposes.

It’s not against the realms that I could just delete daylight images, but as it’s a remote setup working off a 12v solar/battery, I’m trying to reduce unnecessary power drain everywhere I can.  The nearest hour to sunset/sunrise wouldn’t be too much of an issue, but night length varies from 5 to 18 hours or so here in Scotland across the year, hence the need to somehow track it.

In many ways an incorporated light sensor activating the trigger when a threshold has been crossed could be a simpler solution.  An even simpler method might be to incorporate a light switch onto the incoming power and have the whole thing shut down during the day, but I’m not sure if the Pi reboots itself and the camera (and without corrupting files) if the incoming power is continually interrupted.

Chris

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

greiginsydney, 2021-11-27:
Scotland's on our list of places to get back to. We've only seen a tiny bit of it, no further north than Nairn, and we loved it.

Your suggestion has some merit, but it's not without its challenges.

Benefit:
- allows anyone to shoot from sunrise to sunset or vice versa (or a combo of fixed and calculated)
- the underlying code changes would also let fixed-time users be more granular in their start/stop times: at least to the half-hour.
- if I'm going to this effort, I'd see if I can bake in the lunchtime pause I've been asked about (currently something you hard-code into the Arduino if required).

Cost:
- Change the underlying Arduino/Pi code to send the start/end time as minutes past midnight, rather than just the hour value.
- Requires building in a degree of backwards-compatibility so an upgrade to this code in the Pi doesn't break an Arduino still running an earlier version of code.
- UI changes to allow you to specify lat/long, and the underlying calculation of sunrise and sunset.
- The Pi boot sequence will need to be changed to send "today's" start/stop times, as well as the overnight schedule (for a Pi set to always run). Because the Pi boots only once a day this will probably end up being up to a day out: e.g. it always starts shooting on \*yesterday's\* sunrise, but stops at today's sunset. I'm sure that's an acceptable margin of error. An alternative approach might be to send lat/long to the Arduino and let _it_ do that: more investigation required here (although I'm reluctant to try to ask the poor little Arduino to do more).

If you check out issue #98 you'll see there's a bit of a wish-list queue that I'm working on, so this request might not see the light of day for quite some time. Other than yourself, is there a user-community out there who'll benefit from this? (I'm also looking at adding an external trigger interface for wildlife photographers).

> An even simpler method might be to incorporate a light switch onto the incoming power and have the whole thing shut down during the day, but I’m not sure if the Pi reboots itself and the camera (and without corrupting files) if the incoming power is continually interrupted.

Yeah, you definitely want to avoid yanking the Pi's power without warning.

Let me get STM released, take stock of the dev effort for the next suite of changes, and I'll review this again.

\- G.

greiginsydney, 2021-12-03:
Partially fixed in [release 4.4.0](https://github.com/greiginsydney/Intervalometerator/releases/tag/v4.4.0), which adds STM ("shoot through midnight").

Thread 106 (2021-12-03):

Setup.sh fails to create shortcuts to gphoto2 & examples

greiginsydney, 2021-12-03:
This only seems to be an issue ~~when you're installing the intvlm8r as a non-default user, and~~ with more recent versions of Python.

```
Enabling i2c
i2c-bcm2708 module already exists
i2c-dev module already exists
i2c1 parameter already set
i2c_arm parameter already set
 /etc/modprobe.d/raspi-blacklist.conf does not exist - nothing to do.

Unable to find installed gphoto2 examples to create shortcut

Unable to find installed gphoto2 to create shortcut

Exited install_apps OK

Reboot now? [Y/n]: y
```

Resolution: rather than nominate the likely install paths, use 'pip3 show gphoto2' to reveal its location:

```
greig@BenchGnSMT-PCB:~ $ sudo pip3 show gphoto2
Name: gphoto2
Version: 2.3.0
Summary: Python interface to libgphoto2
Home-page: https://github.com/jim-easterbrook/python-gphoto2
Author: Jim Easterbrook
Author-email: jim@jim-easterbrook.me.uk
License: GNU GPL
Location: /usr/local/lib/python3.9/dist-packages
Requires:
Required-by:
greig@BenchGnSMT-PCB:~ $
```

Closed 2021-12-14.

Thread 109 (2022-01-10):

cameraTransfer script not executing.

peterjbaylis, 2022-01-10:
Hi Greig,

I have upgraded my intervalometerator to 4.4.0 hoping that it might reduce ftp errors when copying to the NAS.
However since the upgrade it is no longer running the cameraTransfer script so all the images are still sitting on the SD card in the camera.
I have tried clicking the copynow button on the transfer page and also manually running the cameraTransfer script via an ssh session.
Neither of these actions has made any difference.
I also deleted and re added the uploadedOK.txt, although I think that is just for the piTransfer process.

Included here are screenshots from the system maintenance page and the home page of the web interface on the intervalometerator.
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

Can you suggest where I might look to see what the issue withy the cameraTransfer process is?

Cheers Pete.

greiginsydney, 2022-01-11:
Hi Pete,

Sorry it's doing that to you.

'Celery' now does all the heavy lifting, so if it's dead several things won't work.

For a quick test, just run `sudo /home/pi/setup.sh test` and see what comes back.

I'm expecting something like the below about halfway through the output:
```
PASS: nginx    service is running
PASS: intvlm8r service is running
PASS: celery   service is running
PASS: redis    service is running
PASS: remoteit service is not installed
```

If Celery is running OK, we'll need to dig further into the logs. Have a look at the file `/var/log/celery/celery_worker.log`. Search for the text `copyNow entered` (with a datestamp since you've upgraded) and see what's logged immediately after that.

If Celery is dead, it could be pointing to a code bug or some other issue. Try `sudo systemctl status celery` to diagnose Celery problems. You want it to be showing "active (running)" in green like here:

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

(Press Q to get out of that display back to the command line).

`journalctl | grep celery` may also shed light on issues with Celery.

Hopefully the above will give us some clues.

\- Greig.

peterjbaylis, 2022-01-11:
Hi Greig;
Looks like celery is not running.

---------------------------------------------------------------------------------------------------------------------------------------
See the outputs from the **setup.sh test** run and **journalctl | grep celery** and **sudo systemctl** status celery included below.

pi@picam-03:~ $ sudo /home/pi/setup.sh test
TEST!
PASS: /etc/nginx/sites-available/intvlm8r exists
PASS: /etc/systemd/system/intvlm8r.service exists
PASS: /etc/systemd/system/cameraTransfer.service exists
PASS: /etc/systemd/system/piTransfer.service exists
PASS: /etc/systemd/system/setTime.service exists
PASS: /etc/systemd/system/redis.service exists
PASS: /etc/systemd/system/celery.service exists
PASS: i2c_arm_baudrate is present in /boot/config.txt
PASS: i2c-dev installed in /etc/modules

If the Arduino is connected & programmed it will show as "04" in the top line below:
     0  1  2  3  4  5  6  7  8  9  a  b  c  d  e  f
00:          -- 04 -- -- -- -- -- -- -- -- -- -- --
10: -- -- -- -- -- -- -- -- -- -- -- -- -- -- -- --
20: -- -- -- -- -- -- -- -- -- -- -- -- -- -- -- --
30: -- -- -- -- -- -- -- -- -- -- -- -- -- -- -- --
40: -- -- -- -- -- -- -- -- -- -- -- -- -- -- -- --
50: -- -- -- -- -- -- -- -- -- -- -- -- -- -- -- --
60: -- -- -- -- -- -- -- -- -- -- -- -- -- -- -- --
70: -- -- -- -- -- -- -- --

PASS: The Pi is NOT an AP
PASS: WiFi power save is OFF

PASS: nginx    service is running
PASS: intvlm8r service is running
FAIL: celery   service is dead
PASS: redis    service is running
PASS: remoteit service is not installed

Service = setTime
  LoadState   = loaded
  ActiveState = inactive
  SubState    = dead

Service = cameraTransfer
  LoadState   = loaded
  ActiveState = inactive
  SubState    = dead

Service = piTransfer
  LoadState   = loaded
  ActiveState = inactive
  SubState    = dead

Service = heartbeat
  LoadState   = loaded
  ActiveState = active
  SubState    = waiting

NTP is currently active. NTP is our master time source.
------------------------------------------------------------------------------------------------------------------
And here is the output from j**ournalctl | grep celery** and **sudo systemctl status celery** commands.

pi@picam-03:~ $ journalctl | grep celery
Jan 11 19:17:05 picam-03 systemd-tmpfiles[114]: [/etc/tmpfiles.d/celery.conf:1] Line references path below legacy directory /var/run/, updating /var/run/celery → /run/celery; please u                                    pdate the tmpfiles.d/ drop-in file accordingly.
Jan 11 19:17:16 picam-03 systemd-tmpfiles[184]: [/etc/tmpfiles.d/celery.conf:1] Line references path below legacy directory /var/run/, updating /var/run/celery → /run/celery; please u                                    pdate the tmpfiles.d/ drop-in file accordingly.
Jan 11 19:56:03 picam-03 systemd[1]: Starting celery.service...
Jan 11 20:05:05 picam-03 systemd[1]: celery.service: Start operation timed out. Terminating.
Jan 11 20:05:05 picam-03 systemd[1]: celery.service: Control process exited, code=killed, status=15/TERM
Jan 11 20:05:05 picam-03 systemd[1]: celery.service: Failed with result 'timeout'.
Jan 11 20:05:05 picam-03 systemd[1]: Failed to start celery.service.
Jan 11 20:18:02 picam-03 systemd-tmpfiles[811]: [/etc/tmpfiles.d/celery.conf:1] Line references path below legacy directory /var/run/, updating /var/run/celery → /run/celery; please u                                    pdate the tmpfiles.d/ drop-in file accordingly.

------------------------------------------------------------------------------------------------------------------------------------------
pi@picam-03:~ $ sudo systemctl status celery
● celery.service
   Loaded: loaded (/etc/systemd/system/celery.service; enabled; vendor preset: enabled)
   Active: failed (Result: timeout) since Tue 2022-01-11 20:05:05 ACDT; 1h 31min ago
  Process: 399 ExecStart=/bin/sh -c ${CELERY_BIN} -A ${CELERY_APP} multi start --logfile=${CELERYD_LOG_FILE}   --loglevel=${CELERYD_LOG_LEVEL} ${CELERYD_NODES} ${CELERYD_OPTS} (code=killed, signal=TERM)

Jan 11 19:56:03 picam-03 systemd[1]: Starting celery.service...
Jan 11 20:05:05 picam-03 systemd[1]: celery.service: Start operation timed out. Terminating.
Jan 11 20:05:05 picam-03 systemd[1]: celery.service: Control process exited, code=killed, status=15/TERM
Jan 11 20:05:05 picam-03 systemd[1]: celery.service: Failed with result 'timeout'.
Jan 11 20:05:05 picam-03 systemd[1]: Failed to start celery.service.
pi@picam-03:~ $

Hope this sheds some light on where to look!

Cheers Pete.

greiginsydney, 2022-01-11:
Thanks Pete.

I see some improved monitoring and trapping of Celery's health in my future...

"Timeout" doesn't really tell me a lot (and we've been here before with a similar issue with Remote.it, which I see you're not running).

Was there anything in `/var/log/celery/celery_worker.log`?
<br>
\- G.

peterjbaylis, 2022-01-12:
Hi Greig;
There are 2 celery_worker.log files in that directory.
Here is listing of the files.
They both have the same data stamp.
The celery_worker.log is 0 bytes long.
The celery_worker.log-20220111 is 34M bytes long.

pi@picam-03:/var/log/celery $ ls -al
total 33820
drwxr-xr-x 2 pi   www-data     4096 Jan 12 19:54 .
drwxr-xr-x 8 root root         4096 Jan 12 00:00 ..
-rw-r--r-- 1 pi   www-data        0 Jan 11 00:00 celery_worker.log
-rw-r--r-- 1 pi   www-data 34622470 Jan 11 00:00 celery_worker.log-20220111

I am assuming you will not want to wade through a 34Meg log file, so which bit will help, I can see some stuff about local host connect refused is that where the log file might provide some clues?

Here is a snip of some of the stuff near to the most recent log entries;
----------------------------------------------------------------------------------------------------------------------------------------
[2022-01-01 14:56:24,073: WARNING/MainProcess] /usr/local/lib/python3.7/dist-packages/celery/worker/consumer/consumer.py:361: CPendingDeprecationWarning:
In Celery 5.1 we introduced an optional breaking change which
on connection loss cancels all currently executed tasks with late acknowledgement enabled.
These tasks cannot be acknowledged as the connection is gone, and the tasks are automatically redelivered back to the queue.
You can enable this behavior using the worker_cancel_long_running_tasks_on_connection_loss setting.
In Celery 5.1 it is set to False by default. The setting will be set to True by default in Celery 6.0.

  warnings.warn(CANCEL_TASKS_BY_DEFAULT, CPendingDeprecationWarning)

[2022-01-01 14:56:24,474: ERROR/MainProcess] consumer: Cannot connect to redis://localhost:6379/0: Error 111 connecting to localhost:6379. Connection refused..
Trying again in 2.00 seconds... (1/100)

[2022-01-01 14:56:26,599: INFO/MainProcess] Connected to redis://localhost:6379/0
[2022-01-01 14:56:27,035: INFO/MainProcess] mingle: searching for neighbors
[2022-01-01 14:56:28,299: INFO/MainProcess] mingle: all alone
[2022-01-01 14:58:33,624: WARNING/MainProcess] consumer: Connection to broker lost. Trying to re-establish the connection...
Traceback (most recent call last):
  File "/usr/local/lib/python3.7/dist-packages/celery/worker/consumer/consumer.py", line 326, in start
    blueprint.start(self)
  File "/usr/local/lib/python3.7/dist-packages/celery/bootsteps.py", line 116, in start
    step.start(parent)
  File "/usr/local/lib/python3.7/dist-packages/celery/worker/consumer/consumer.py", line 618, in start
    c.loop(*c.loop_args())
  File "/usr/local/lib/python3.7/dist-packages/celery/worker/loops.py", line 81, in asynloop
    next(loop)
  File "/usr/local/lib/python3.7/dist-packages/kombu/asynchronous/hub.py", line 361, in create_loop
    cb(*cbargs)
  File "/usr/local/lib/python3.7/dist-packages/kombu/transport/redis.py", line 1128, in on_readable
    self.cycle.on_readable(fileno)
  File "/usr/local/lib/python3.7/dist-packages/kombu/transport/redis.py", line 398, in on_readable
    chan.handlers[type]()
  File "/usr/local/lib/python3.7/dist-packages/kombu/transport/redis.py", line 733, in _receive
    ret.append(self._receive_one(c))
  File "/usr/local/lib/python3.7/dist-packages/kombu/transport/redis.py", line 743, in _receive_one
    response = c.parse_response()
  File "/usr/local/lib/python3.7/dist-packages/redis/client.py", line 3505, in parse_response
    response = self._execute(conn, conn.read_response)
  File "/usr/local/lib/python3.7/dist-packages/redis/client.py", line 3479, in _execute
    return command(*args, **kwargs)
  File "/usr/local/lib/python3.7/dist-packages/redis/connection.py", line 739, in read_response
    response = self._parser.read_response()
  File "/usr/local/lib/python3.7/dist-packages/redis/connection.py", line 324, in read_response
    raw = self._buffer.readline()
  File "/usr/local/lib/python3.7/dist-packages/redis/connection.py", line 256, in readline
    self._read_from_socket()
  File "/usr/local/lib/python3.7/dist-packages/redis/connection.py", line 201, in _read_from_socket
    raise ConnectionError(SERVER_CLOSED_CONNECTION_ERROR)
redis.exceptions.ConnectionError: Connection closed by server.
[2022-01-01 14:58:33,786: WARNING/MainProcess] /usr/local/lib/python3.7/dist-packages/celery/worker/consumer/consumer.py:361: CPendingDeprecationWarning:
In Celery 5.1 we introduced an optional breaking change which
on connection loss cancels all currently executed tasks with late acknowledgement enabled.
These tasks cannot be acknowledged as the connection is gone, and the tasks are automatically redelivered back to the queue.
You can enable this behavior using the worker_cancel_long_running_tasks_on_connection_loss setting.
In Celery 5.1 it is set to False by default. The setting will be set to True by default in Celery 6.0.

  warnings.warn(CANCEL_TASKS_BY_DEFAULT, CPendingDeprecationWarning)

[2022-01-01 14:58:35,365: ERROR/MainProcess] consumer: Cannot connect to redis://localhost:6379/0: Error 111 connecting to localhost:6379. Connection refused..
Trying again in 2.00 seconds... (1/100)

[2022-01-01 14:58:37,461: ERROR/MainProcess] consumer: Cannot connect to redis://localhost:6379/0: Error 111 connecting to localhost:6379. Connection refused..
Trying again in 4.00 seconds... (2/100)

[2022-01-01 14:58:41,654: ERROR/MainProcess] consumer: Cannot connect to redis://localhost:6379/0: Error 111 connecting to localhost:6379. Connection refused..
Trying again in 6.00 seconds... (3/100)

[2022-01-01 14:58:47,726: ERROR/MainProcess] consumer: Cannot connect to redis://localhost:6379/0: Error 111 connecting to localhost:6379. Connection refused..
Trying again in 8.00 seconds... (4/100)

[2022-01-01 14:58:55,777: ERROR/MainProcess] consumer: Cannot connect to redis://localhost:6379/0: Error 111 connecting to localhost:6379. Connection refused..
Trying again in 10.00 seconds... (5/100)

[2022-01-01 14:59:05,849: ERROR/MainProcess] consumer: Cannot connect to redis://localhost:6379/0: Error 111 connecting to localhost:6379. Connection refused..
Trying again in 12.00 seconds... (6/100)

-------------------------------------------------------------------------------------------------------------------------------------------
I can send the complete file via dropbox or wetransfer if you want to see the whole thing.

Cheers Pete.

greiginsydney, 2022-01-14:
Ta Pete, we might need to do that. Let's see if I can avoid the pain of trying to sift through 34M of logs though.

Can you run `celery --version` for me please and just confirm we're on the same version? Here's mine:

```
pi@greyBox:~ $ celery --version
5.0.2 (singularity)
pi@greyBox:~ $
```
<hr/>

Have you installed any other (custom) software components on the Pi? We found with remote.it that we needed to tell Celery to hold off launching until remote.it was up. We could have a similar interaction with yours.

Consider the following a diagnostic step only, not a fix.

Let's see how long systemd is waiting for celery to start:
```
pi@greyBox:~ $ sudo systemctl show celery | grep ^Timeout
TimeoutStartUSec=1min 30s
TimeoutStopUSec=1min 30s
pi@greyBox:~ $
```
Ok, so 90 seconds here. Let's double that to 180.

Edit your celery.service file (`sudo nano /etc/systemd/system/celery.service)` and add a TimeoutStartUSec line to it:
```
[Service]
Type=forking
User=pi
Group=www-data
EnvironmentFile=/etc/default/celery
WorkingDirectory=/home/pi/www
TimeoutStartSec=180

ExecStart=/bin/sh - <etc>
```

Reload the daemon after the change:
```
pi@greyBox:~ $ sudo systemctl daemon-reload
```
Confirm the change:
```
pi@greyBox:~ $ sudo systemctl show celery | grep ^Timeout
TimeoutStartUSec=3min
TimeoutStopUSec=1min 30s
```

Let's see if it works:
```
pi@greyBox:~ $ sudo systemctl restart celery
pi@greyBox:~ $ sudo systemctl status celery
```

So if this starts OK we know it's just a timing problem and there's nothing inherently broken. Mind you, if it doesn't start that *doesn't* definitely point to broken code. (I just upgraded one of my demo setups here to 4.4.0 and Celery is working fine).

\- G.

([Reference](https://sleeplessbeastie.eu/2020/02/29/how-to-prevent-systemd-service-start-operation-from-timing-out/))

peterjbaylis, 2022-01-14:
Hi Greig;

Well done... adding Timeouts to the celery.service file has kicked the cameraTransfer process into action.
I have not forced a reboot of the system yet as I will let it copy the ~ 5000 image files from the SD card first.

Here are some notes I made while running the diagnostics you suggested.
***
[celery diagnostics 20220114.txt](https://github.com/greiginsydney/Intervalometerator/files/7868929/celery.diagnostics.20220114.txt)

This seems to be where my problem is or was, so does this point directly to where a fix needs to be applied?

Cheers Pete.

peterjbaylis, 2022-01-14:
Hi Greig;

After a reboot the celery service is again reporting as dead.

***
pi@picam-03:~/photos/DCIM/105CANON $ sudo /home/pi/setup.sh test
TEST!
PASS: /etc/nginx/sites-available/intvlm8r exists
PASS: /etc/systemd/system/intvlm8r.service exists
PASS: /etc/systemd/system/cameraTransfer.service exists
PASS: /etc/systemd/system/piTransfer.service exists
PASS: /etc/systemd/system/setTime.service exists
PASS: /etc/systemd/system/redis.service exists
PASS: /etc/systemd/system/celery.service exists
PASS: i2c_arm_baudrate is present in /boot/config.txt
PASS: i2c-dev installed in /etc/modules

If the Arduino is connected & programmed it will show as "04" in the top line below:
     0  1  2  3  4  5  6  7  8  9  a  b  c  d  e  f
00:          -- 04 -- -- -- -- -- -- -- -- -- -- --
10: -- -- -- -- -- -- -- -- -- -- -- -- -- -- -- --
20: -- -- -- -- -- -- -- -- -- -- -- -- -- -- -- --
30: -- -- -- -- -- -- -- -- -- -- -- -- -- -- -- --
40: -- -- -- -- -- -- -- -- -- -- -- -- -- -- -- --
50: -- -- -- -- -- -- -- -- -- -- -- -- -- -- -- --
60: -- -- -- -- -- -- -- -- -- -- -- -- -- -- -- --
70: -- -- -- -- -- -- -- --

PASS: The Pi is NOT an AP
PASS: WiFi power save is OFF

PASS: nginx    service is running
PASS: intvlm8r service is running
FAIL: celery   service is dead
PASS: redis    service is running
PASS: remoteit service is not installed

Service = setTime
  LoadState   = loaded
  ActiveState = inactive
  SubState    = dead

Service = cameraTransfer
  LoadState   = loaded
  ActiveState = inactive
  SubState    = dead

Service = piTransfer
  LoadState   = loaded
  ActiveState = activating
  SubState    = start

Service = heartbeat
  LoadState   = loaded
  ActiveState = active
  SubState    = waiting

NTP is currently active. NTP is our master time source.

***
Where else should I be looking or running diags?

Cheers Pete.

peterjbaylis, 2022-01-14:
Hi Greig;

After the reboot;

***
pi@picam-03:~ $ sudo nano /etc/systemd/system/celery.service
pi@picam-03:~ $ sudo systemctl show celery | grep ^Timeout
TimeoutStartUSec=1min 30s
TimeoutStopUSec=1min 30s

***
the celery.service file seems to have gone back to the 90 sec Timeouts.

I checked with nano and the celery.service file I edited is showing for TimeoutStartUSec=3min
And for TimeoutStopUsec=1min 30s.

Not sure if this helps on not....

Cheers Pete.

greiginsydney, 2022-01-15:
Well, I think that's a positive outcome to start with.

Try these two changes for me, then reload the daemon and reboot:
- Change the name from 'TimeoutStartUSec' to 'TimeoutStartSec' (ditching the "U")
- Change the value back to raw numerals, e.g. TimeoutStartSec=180

Separate to that, I'm curious to see what other systemd services you might have running. Here's mine (and the command to display them):

```
pi@greyBox:~ $ systemctl --type=service --state=active
UNIT                                                        LOAD   ACTIVE SUB     DESCRIPTION
avahi-daemon.service                                        loaded active running Avahi mDNS/DNS-SD Stack
console-setup.service                                       loaded active exited  Set console font and keymap
cron.service                                                loaded active running Regular background program processing daemon
dbus.service                                                loaded active running D-Bus System Message Bus
dhcpcd.service                                              loaded active running dhcpcd on all interfaces
dphys-swapfile.service                                      loaded active exited  dphys-swapfile - set up, mount/unmount, and delet
fake-hwclock.service                                        loaded active exited  Restore / save the current clock
getty@tty1.service                                          loaded active running Getty on tty1
ifupdown-pre.service                                        loaded active exited  Helper to synchronize boot up for ifupdown
intvlm8r.service                                            loaded active running intvlm8r.service. Gunicorn instance to serve intv
keyboard-setup.service                                      loaded active exited  Set the console keyboard layout
kmod-static-nodes.service                                   loaded active exited  Create list of required static device nodes for t
networking.service                                          loaded active exited  Raise network interfaces
nginx.service                                               loaded active running A high performance web server and a reverse proxy
raspi-config.service                                        loaded active exited  LSB: Switch to ondemand cpu governor (unless shif
rc-local.service                                            loaded active exited  /etc/rc.local Compatibility
redis-server.service                                        loaded active running Advanced key-value store
rng-tools.service                                           loaded active running rng-tools.service
rpi-eeprom-update.service                                   loaded active exited  Check for Raspberry Pi EEPROM updates
rsyslog.service                                             loaded active running System Logging Service
serial-getty@ttyAMA0.service                                loaded active running Serial Getty on ttyAMA0
ssh.service                                                 loaded active running OpenBSD Secure Shell server
supervisor.service                                          loaded active running Supervisor process control system for UNIX
systemd-fsck-root.service                                   loaded active exited  File System Check on Root Device
systemd-fsck@dev-disk-by\x2dpartuuid-6c586e13\x2d01.service loaded active exited  File System Check on /dev/disk/by-partuuid/6c586e
systemd-journal-flush.service                               loaded active exited  Flush Journal to Persistent Storage
systemd-journald.service                                    loaded active running Journal Service
systemd-logind.service                                      loaded active running Login Service
systemd-modules-load.service                                loaded active exited  Load Kernel Modules
systemd-random-seed.service                                 loaded active exited  Load/Save Random Seed
systemd-remount-fs.service                                  loaded active exited  Remount Root and Kernel File Systems
systemd-sysctl.service                                      loaded active exited  Apply Kernel Variables
systemd-sysusers.service                                    loaded active exited  Create System Users
systemd-tmpfiles-setup-dev.service                          loaded active exited  Create Static Device Nodes in /dev
systemd-tmpfiles-setup.service                              loaded active exited  Create Volatile Files and Directories
systemd-udev-trigger.service                                loaded active exited  udev Coldplug all Devices
systemd-udevd.service                                       loaded active running udev Kernel Device Manager
systemd-update-utmp.service                                 loaded active exited  Update UTMP about System Boot/Shutdown
systemd-user-sessions.service                               loaded active exited  Permit User Sessions
triggerhappy.service                                        loaded active running triggerhappy global hotkey daemon
user-runtime-dir@1000.service                               loaded active exited  User Runtime Directory /run/user/1000
user@1000.service                                           loaded active running User Manager for UID 1000
wpa_supplicant.service                                      loaded active running WPA supplicant

LOAD   = Reflects whether the unit definition was properly loaded.
ACTIVE = The high-level unit activation state, i.e. generalization of SUB.
SUB    = The low-level unit activation state, values depend on unit type.
```

<br>

\- G.

greiginsydney, 2022-01-15:
'TimeoutStartUSec' vs 'TimeoutStartSec' gets quite a run:

[https://github.com/systemd/systemd/issues/2047](https://github.com/systemd/systemd/issues/2047)

peterjbaylis, 2022-01-15:
Hi Greig;

Two extra services showing on my list.
I can see celery.service and systemd-timesyncd.service on my service list but they are not showing on your greyBox list.

My diagnostic notes are included here...
***
[celery diagnostics 20220115.txt](https://github.com/greiginsydney/Intervalometerator/files/7874726/celery.diagnostics.20220115.txt)

I think its time for a Coopers Pale Ale, I'll have one for you....

Cheers Pete.

peterjbaylis, 2022-01-15:
Hi Greig;

BTW, at this time the pi is not copying files from the camera or transferring files to my NAS.
I can still ssh to the pi but it is not responding to http requests, so I'm thinking I might try the upgrade process again.
Any thoughts?

Cheers Pete.

.

greiginsydney, 2022-01-15:
Not responding to http requests? But all we've changed was the service file for celery, which isn't involved in the serving of pages.

Does a `sudo /home/pi/setup.sh test` report anything (like nginx?) down?

Try this one and see if it outputs anything: `sudo systemctl list-units --failed`

A fresh upgrade will update any of the files that have changed along the way, but it's not as comprehensive as a full rebuild/reinstall. (Don't forget the critical 'cp ~/www/intvlm8r.py ~/www/intvlm8r.old' line).

\- G.

greiginsydney, 2022-01-15:
Hi Pete,

A few more bits:

> daemon reload and show celery, note the 'U' has found its way back to the TimeoutStart parameter.

From what I've been reading, you specify without the U, but when you query, it adds the U. Check out that long issue from systemd that I posted yesterday. So don't be worried by this.

BUT on that, it might be worthwhile pulling out the U in the TimeoutStopUSec entry - or removing it altogether from the celery.service file (as it's redundant specifying the default value).

> I can see celery.service and systemd-timesyncd.service on my service list but they are not showing on your greyBox list.

I can't explain celery's absence from my earlier post, as it's present when I rerun the command now. As for timesyncd, its presence will depend on whether you're using NTP or the Arduino as your master time source. That will be output as the last line of the 'test' command. Here's mine:
```
NTP is not active. The Arduino is our master time source.
```
... whilst yours is
```
NTP is currently active. NTP is our master time source.
```

peterjbaylis, 2022-01-15:
Hi Greig;

I was bit too impatient waiting for the web services to start. It did
eventually start talking to me.
I’ll look at the other tests you suggested and let you know what I find.

Thanks for your patience following this through.

Cheers Pete.

On Sun, 16 Jan 2022 at 08:18, Greig Sheridan ***@***.***>
wrote:

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
--
Peter

peterjbaylis, 2022-01-17:
Hi Greig;

The pi is behaving today.
cameraTransfer copied 600 files to the pi and the pi transferred them all to the NAS with no errors.

The only change I made since I last updated this issue is that I formatted the memory card in the camera after manually copying the files to my PC.
I did not update the uploadedOK.txt.

I have not upgraded or updated the intvlm8r installation on the pi SD card.
I may still do that after I pick up a new microSD card. But I will let it run for a few days with the current image.
And this time I will save the intvlm8r.py to preserve my password.

Cheers Pete.

peterjbaylis, 2022-01-17:
Hi Greig;

The list-units failed says "0 loaded units listed"

And here is the output from the setup.sh test command.
***
pi@picam-03:~ $ sudo /home/pi/setup.sh test
TEST!
PASS: /etc/nginx/sites-available/intvlm8r exists
PASS: /etc/systemd/system/intvlm8r.service exists
PASS: /etc/systemd/system/cameraTransfer.service exists
PASS: /etc/systemd/system/piTransfer.service exists
PASS: /etc/systemd/system/setTime.service exists
PASS: /etc/systemd/system/redis.service exists
PASS: /etc/systemd/system/celery.service exists
PASS: i2c_arm_baudrate is present in /boot/config.txt
PASS: i2c-dev installed in /etc/modules

If the Arduino is connected & programmed it will show as "04" in the top line below:
     0  1  2  3  4  5  6  7  8  9  a  b  c  d  e  f
00:          -- 04 -- -- -- -- -- -- -- --
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

Thread 111 (2022-01-17):

intvlm8r fails to operate correctly if Celery isn't running

greiginsydney, 2022-01-17:
Issue #109 reflects and instance where the intvlm8r fails to operate correctly if Celery isn't running.

I'll use this issue to track improvements to the self-detection and reporting of same, and also efforts to get it to restart.

Closed 2022-07-10.

Thread 112 (2022-02-09):

i2cdetect -y 1 fails to report the Arduino is present

greiginsydney, 2022-02-09:
My initial suspicion is that this is specific to Pi's running bullseye:

```
pi@Bench442RC:~ $ i2cdetect -y 1
     0  1  2  3  4  5  6  7  8  9  a  b  c  d  e  f
00:                         -- -- -- -- -- -- -- --
10: -- -- -- -- -- -- -- -- -- -- -- -- -- -- -- --
20: -- -- -- -- -- -- -- -- -- -- -- -- -- -- -- --
30: -- -- -- -- -- -- -- -- -- -- -- -- -- -- -- --
40: -- -- -- -- -- -- -- -- -- -- -- -- -- -- -- --
50: -- -- -- -- -- -- -- -- -- -- -- -- -- -- -- --
60: -- -- -- -- -- -- -- -- -- -- -- -- -- -- -- --
70: -- -- -- -- -- -- -- --
pi@Bench442RC:~ $
```

The top line SHOULD report
```
00:          -- 04 -- -- -- -- -- -- -- -- -- -- --
```

greiginsydney, 2022-07-15:
https://forums.raspberrypi.com/viewtopic.php?t=337441

greiginsydney, 2022-07-19:
Confirmed OK on Buster:

```
pi@raspberrypi:~ $ cat /etc/os-release
PRETTY_NAME="Raspbian GNU/Linux 10 (buster)"
NAME="Raspbian GNU/Linux"
VERSION_ID="10"
VERSION="10 (buster)"
VERSION_CODENAME=buster
ID=raspbian
ID_LIKE=debian
HOME_URL="http://www.raspbian.org/"
SUPPORT_URL="http://www.raspbian.org/RaspbianForums"
BUG_REPORT_URL="http://www.raspbian.org/RaspbianBugs"
pi@raspberrypi:~ $ i2cdetect -y -a 1 0x04 0x04
     0  1  2  3  4  5  6  7  8  9  a  b  c  d  e  f
00:             04
10:
20:
30:
40:
50:
60:
70:
pi@raspberrypi:~ $
```

Closing.

Closed 2022-07-19.

Thread 113 (2022-02-10):

Is it possible to Upload each image immediately after taking a shot? Need to use Sim card for data.

NikkhhilThackar, 2022-02-10:
Hi Greig

First, thank you for this wonderful project. I have ordered PCB from you and now started building it.
I have 2 questions.
1. Is it possible to upload each image immediately after taking a shot?
2. How can I use a sim card for data instead of Wifi?

Regards,

greiginsydney, 2022-02-10:
Hi [Nikkhhil](https://github.com/NikkhhilThackar), welcome aboard!

I'm glad your PCB made it to you OK. To answer your questions:

>  Is it possible to upload each image immediately after taking a shot?

No, the intvlm8r 'batches' this, and the UI is implemented so this happens once a day. You _can_ make manual changes that will do this multiple times a day, and I've documented in the [FAQ ](https://github.com/greiginsydney/Intervalometerator/blob/master/docs/FAQ.md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) how to make the copy/transfer take place once an hour.

The intvlm8r is designed to run from solar and battery, and you'd need to have the Pi running permanently to support the transfer of every image as it's taken.

There's an extra layer of complication in your request because the Pi would need to know *when* an image has been taken so it can immediately copy it out of the camera, and there's no way in the hardware for the Arduino (which manages the shooting schedule) to signal this to the Pi. This leaves me with the Pi needing to wake and poll the camera potentially every minute looking for new photos...

>  How can I use a sim card for data instead of Wifi?

Plenty of people have done this, and all you need is a "4G/5G WiFi dongle". It gives you the network connectivity and makes a WiFi network for the intvlm8r to connect to.  "remote.it" is a popular service that can let you access your intvlm8r in the field over such a connection. The downside of this is the power requirements of the dongle, which again is problematic if you're running off solar/battery and also want a frequent upload of images.

\- Greig.

NikkhhilThackar, 2022-02-11:
Thank you Greig for the quick response. Will look deeper into this.

Closed 2022-03-19.

Thread 114 (2022-02-25):

Transfer of images not taking place

aerialvideographyuk, 2022-02-25:
Have done a complete new install of the latest arduino code and pi code and everything worked as expected.
Installed remoteit and no transfer took place.  I remember we had to do a change to make celery wait until remoteit had loaded .  It looks like the way remoteit installs is now different and I couldn't find how to replicate the previous fix.
Here is the result of running setup.sh test.
Although it says remoteit service is not installed, it is installed.

After some further investigation I found the remoteit@.service  in /etc/systemd/system and did the same change as previous
After=network.target rc-local.service celery.service but celery still did not start.
Noticed also that I don't see 04 in the top line below even though the arduino appears to be working OK?
Any help would be very welcome.

pi@avuk1:~ $ sudo /home/pi/setup.sh test
TEST!
PASS: /etc/nginx/sites-available/intvlm8r exists
PASS: /etc/systemd/system/intvlm8r.service exists
PASS: /etc/systemd/system/cameraTransfer.service exists
PASS: /etc/systemd/system/piTransfer.service exists
PASS: /etc/systemd/system/setTime.service exists
PASS: /etc/systemd/system/redis.service exists
PASS: /etc/systemd/system/celery.service exists
PASS: i2c_arm_baudrate is present in /boot/config.txt
PASS: i2c-dev installed in /etc/modules

If the Arduino is connected & programmed it will show as "04" in the top line below:
     0  1  2  3  4  5  6  7  8  9  a  b  c  d  e  f
00:                         -- -- -- -- -- -- -- --
10: -- -- -- -- -- -- -- -- -- -- -- -- -- -- -- --
20: -- -- -- -- -- -- -- -- -- -- -- -- -- -- -- --
30: -- -- -- -- -- -- -- -- -- -- -- -- -- -- -- --
40: -- -- -- -- -- -- -- -- -- -- -- -- -- -- -- --
50: -- -- -- -- -- -- -- -- -- -- -- -- -- -- -- --
60: -- -- -- -- -- -- -- -- -- -- -- -- -- -- -- --
70: -- -- -- -- -- -- -- --

PASS: The Pi is NOT an AP
PASS: WiFi power save is OFF

PASS: nginx    service is running
PASS: intvlm8r service is running
FAIL: celery   service is dead
PASS: redis    service is running
PASS: remoteit service is not installed

Service = setTime
  LoadState   = loaded
  ActiveState = inactive
  SubState    = dead

Service = cameraTransfer
  LoadState   = loaded
  ActiveState = inactive
  SubState    = dead

Service = piTransfer
  LoadState   = loaded
  ActiveState = inactive
  SubState    = dead

Service = heartbeat
  LoadState   = loaded
  ActiveState = active
  SubState    = waiting

NTP is not active. The Arduino is our master time source.

pi@avuk1:~ $

greiginsydney, 2022-02-25:
Hi Dave,
<br>

> Noticed also that I don't see 04 in the top line below even though the arduino appears to be working OK?

Yeah, this seems to be a thing in Bullseye. I've been able to reproduce this here myself and I'm tracking it as Bug #112. I can't find anyone else reporting similar issues, but as Bullseye (on the Pi) is relatively new I'm hoping a resolution might arrive sometime soon.

> Although it says remoteit service is not installed, it is installed.

Great, thanks for letting me know. I'll do a fresh install and review/refresh the 'installed' test.

> FAIL: celery service is dead

Given past history I'm guessing remote.it is killing Celery, so let me look some more into that.

Is [this the new install process](https://support.remote.it/hc/en-us/articles/4422773654669-Streamlined-installation-for-Linux-and-Raspberry-Pi-platforms) you followed?

\- G.

aerialvideographyuk, 2022-02-25:
Hi Greig,

I just ran the following command on the pi, as it seemed that curl was already installed.

sh -c "$(curl -L https://downloads.remote.it/remoteit/install_agent.sh)"

That generated a code to put into the desktop application and that seemed to work fine and enabled me to connect via ssh and http.

Prior to the remoteit install I had checked all functions were working including the rename on copy and dead mans snitch.

Just for completeness I also remove files from the camera when copied and from the pi when transferred.

I am transferring to a dropbox account and then have a local script that tranfers to a NAS at night.

I haven’t as yet uninstalled remoteit as I felt it may be best to leave it on to aid fault finding.

I can collect the data from the camera’s sdcard as it is local to me at the moment.

I will be moving my web hosting soon and so have put a personal mail address in above in case there is an interruption to my aerialvideographyuk.com mail.

All the best,

Dave

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

greiginsydney, 2022-02-25:
Aha!

It looks like they've changed the name of the service to `connectd.service`, so if you try adding that "After=" edit to THIS file instead, you might be in luck.

```bash
/etc/systemd/system/connectd.service
```
<br>

\- G.

aerialvideographyuk, 2022-02-26:
I added the celery.service to the After= for the schannel.service and that didn't cure the problem.
I then also added it to the connectd.service and that seems to have fixed it.
Should I remove  the entry from schannel.service or is it ok to leave it there?

greiginsydney, 2022-02-27:
> I then also added it to the connectd.service and that seems to have fixed it.

Thanks for confirming that. My analysis suggested it would be the other, so I appreciate the feedback. I'll update the doco.

> Should I remove the entry from schannel.service or is it ok to leave it there?

Safest to remove it, thanks.

\- G.

greiginsydney, 2022-03-19:
I've had no luck engaging remote.it, but it looks like the service is in a state of flux. (The above changes seem to no longer work!)

I'll keep an eye on it and update the code in a future release.

greiginsydney, 2022-03-23:
Support @ remote.it has responded and provided a better way of detecting its presence, which I'll add into the setup script.

I'm hoping they'll be able to clarify the service file(s) we need to edit so they'll play well with celery.

greiginsydney, 2022-05-21:
Fixed in [v4.4.3](https://github.com/greiginsydney/Intervalometerator/releases/tag/v4.4.3) released 21st May 2022

Closed 2022-05-21.

Thread 120 (2022-07-11):

Power board fault short circuit problem

wj7106, 2022-07-11:
Hi, I have a short circuit problem with the power supply board today. The power supply part of the whole PCB board is short circuited. After inspection, I found that the power supply board for raspberry pie 5V is short circuited, resulting in the short circuit of the whole system, including the solar MPPT controller. I removed the 12V to 5V power supply board, and the short circuit of the whole circuit disappears. Can I improve the PCB power supply part to avoid the short circuit of the whole system due to a module power failure?

greiginsydney, 2022-07-13:
That's disappointing to hear. I hope you had heartbeating enabled and didn't lose too many images?

Was this a genuine Pololu supply, and were there any contributing factors like extreme heat or extreme over-current (e.g. by running a Pi 4 on the 500mA supply)? I chose the Pololu family at design time because I don't have the experience to design my own, and to date I've not had any fail.

I can't see any improvement you can make that will protect against such a fatal failure, other than adding a fuse. I don't know if a PTC device (like a PolySwitch) will help, as it will potentially add an upstream supply impedance into the regulator. Any outboard over-current limiter just adds another link into the chain and becomes another potential failure.

\- G.

Closed 2022-07-16.

Thread 123 (2022-08-20):

Canon camera intermittently reports 'busy' on LCD & won't take photos

greiginsydney, 2022-08-20:
Some models of Canon camera may manifest an intermittent issue where the camera's LCD display reports "busy", and the camera won't take a photo.

Unplugging the USB cable restores the ability to take photos.

<p align="center">
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
 </p>

This appears to be a bug in the version of libgphoto (one of the underlying components) that's installed with the "bullseye" version of Raspberry Pi o/s. [[Ref#1](https://github.com/gphoto/libgphoto2/issues/352)] [[Ref#2](https://github.com/gphoto/gphoto2/issues/465)]

Intvlm8r's still running on the earlier "buster" o/s are not affected.

### How to tell if you're at risk

From the "System Maintenance" page, check the `Pi o/s version` and `libgphoto2 version`:

<p align="center">
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
 </p>

__libgphoto2 version 2.5.27 is the problem.__

### Resolution

An update to the `setup.sh` script is currently being soak-tested. If it detects a "legacy" installation of libgphoto2 it will first uninstall it and then install the latest version directly from GitHub.

An upside to this change is that newer camera models will be supported by the intvlm8r sooner than would have otherwise been the case.

<br>

\- Greig.

wj7106, 2022-08-21:
Last year, I reflected on this problem. Maybe the description was not very clear at that time, https://github.com/greiginsydney/Intervalometerator/issues/80

greiginsydney, 2022-08-21:
Nah, that was a different scenario. In this case all USB-related comms is fine: you can take and view a Preview image and view/change all other camera parameters, however the on-camera 'shoot' button is inoperative, as is the remote trigger input.

greiginsydney, 2022-09-24:
Fixed in Release v4.5.0.

Closed 2022-09-24.

Thread 125 (2022-09-04):

4.4.6 raspberry zero2w is not supported

wj7106, 2022-09-04:
I have a raspberry pi zero2w in my hand. I installed a raspberry pi 32-bit bullseye or Buster system, but it could not be successfully installed. I can only upgrade the system to 4.4.6 by using the image backup installed before. However, in the 4.4.6 system, I can't find any cameras, and I can't find or unknown devices at all. With the lsusb command, I can check the camera model until I plug the system into raspberry pi zero W, Can be used completely

wj7106, 2022-09-04:
Now I find that after the system is reinstalled, I still can't find the camera, but after I connect the monitor, enter the user name and password, and log in to the system, the system can connect and recognize the camera

greiginsydney, 2022-09-05:
Congrats on scoring yourself a very rare piece of tech! I've not tested with the Zero 2 W yet, but I wasn't expecting there to be any breaking changes.

What user are you installing as? "pi" or someone else?

Please run the setup script with the test option (`sudo -E ./setup.sh test`) and paste the output here?

wj7106, 2022-09-05:
pi@raspberrypi:~ $ sudo -E ./setup.sh test
TEST!

PASS: OS test passed

PASS: /etc/nginx/sites-available/intvlm8r exists
PASS: /etc/systemd/system/intvlm8r.service exists
PASS: /etc/systemd/system/cameraTransfer.service exists
PASS: /etc/systemd/system/piTransfer.service exists
PASS: /etc/systemd/system/setTime.service exists
PASS: /etc/systemd/system/redis.service exists
PASS: /etc/systemd/system/celery.service exists
PASS: i2c_arm_baudrate is present in /boot/config.txt
PASS: i2c-dev installed in /etc/modules

If the Arduino is connected & programmed it will show as "04" in the top line be                                                low:
     0  1  2  3  4  5  6  7  8  9  a  b  c  d  e  f
00:             04
10:
20:
30:
40:
50:
60:
70:

PASS: The Pi is NOT an AP
PASS: WiFi power save is OFF

PASS: nginx     service is running
PASS: intvlm8r  service is running
PASS: celery    service is running
PASS: redis     service is running

PASS: remoteit  service is not installed

Service = setTime.service
  LoadState   = loaded
  ActiveState = inactive
  SubState    = dead

Service = cameraTransfer.service
  LoadState   = loaded
  ActiveState = inactive
  SubState    = dead

Service = piTransfer.service
  LoadState   = loaded
  ActiveState = inactive
  SubState    = dead

Service = heartbeat.timer
  LoadState   = loaded
  ActiveState = active
  SubState    = waiting

Service = apt-daily.timer
  LoadState   = masked
  ActiveState = inactive
  SubState    = dead

Service = apt-daily.service
  LoadState   = loaded
  ActiveState = inactive
  SubState    = dead

NTP is currently active. NTP is our master time source.

PASS: /usr/lib/gvfs/gvfsd-gphoto2               is not executable or does not ex                                                ist
PASS: /usr/lib/gvfs/gvfs-gphoto2-volume-monitor is not executable or does not ex                                                ist

 Now I log in to the test from putty, but I still can't find the camera. The message on gunicorn.error shows gphoto2error

[2022-09-05 19:42:00 +0800] [638] [DEBUG] GET /
[2022-09-05 19:42:01 +0800] [639] [DEBUG] GET /login
[2022-09-05 19:42:01 +0800] [639] [DEBUG] It's a GET to LOGIN
[2022-09-05 19:42:01 +0800] [637] [DEBUG] GET /static/favicon.ico
[2022-09-05 19:42:12 +0800] [639] [DEBUG] POST /login
[2022-09-05 19:42:12 +0800] [639] [DEBUG] Logged-in admin
[2022-09-05 19:42:12 +0800] [639] [DEBUG] GET /
[2022-09-05 19:42:12 +0800] [639] [DEBUG] YES - this bit of MAIN fired!
[2022-09-05 19:42:12 +0800] [639] [DEBUG] connectCamera entered
[2022-09-05 19:42:12 +0800] [639] [DEBUG] connectCamera retries = 4
[2022-09-05 19:42:13 +0800] [639] [DEBUG] connectCamera GPhoto2Error: [-7] I/O problem
[2022-09-05 19:42:13 +0800] [639] [DEBUG] connectCamera returning None
[2022-09-05 19:42:13 +0800] [639] [DEBUG] ASCII = 48
[2022-09-05 19:42:13 +0800] [639] [DEBUG] Status received was: >20220905<
[2022-09-05 19:42:13 +0800] [639] [DEBUG] ASCII = 49
[2022-09-05 19:42:13 +0800] [639] [DEBUG] Status received was: >194212<
[2022-09-05 19:42:14 +0800] [639] [DEBUG] ASCII = 50
[2022-09-05 19:42:14 +0800] [639] [DEBUG] Status received was: >19999:21945<
[2022-09-05 19:42:14 +0800] [639] [DEBUG] connectCamera entered
[2022-09-05 19:42:14 +0800] [639] [DEBUG] connectCamera retries = 1
[2022-09-05 19:42:14 +0800] [639] [DEBUG] connectCamera GPhoto2Error: [-7] I/O problem
[2022-09-05 19:42:14 +0800] [639] [DEBUG] connectCamera retries = 2
[2022-09-05 19:42:14 +0800] [639] [DEBUG] connectCamera GPhoto2Error: [-7] I/O problem
[2022-09-05 19:42:16 +0800] [639] [DEBUG] connectCamera retries = 3
[2022-09-05 19:42:16 +0800] [639] [DEBUG] connectCamera GPhoto2Error: [-7] I/O problem
[2022-09-05 19:42:16 +0800] [639] [DEBUG] connectCamera retries = 4
[2022-09-05 19:42:16 +0800] [639] [DEBUG] connectCamera GPhoto2Error: [-7] I/O problem
[2022-09-05 19:42:16 +0800] [639] [DEBUG] connectCamera returning None
[2022-09-05 19:42:16 +0800] [639] [DEBUG] getLargestImageSize returned: 100000
[2022-09-05 19:42:16 +0800] [639] [DEBUG] ASCII = 51. Returned cached value ''
[2022-09-05 19:42:18 +0800] [639] [DEBUG] GET /
[2022-09-05 19:42:18 +0800] [639] [DEBUG] YES - this bit of MAIN fired!
[2022-09-05 19:42:20 +0800] [639] [DEBUG] Returned after detecting camera wake command
[2022-09-05 19:42:20 +0800] [638] [DEBUG] GET /
[2022-09-05 19:42:21 +0800] [638] [DEBUG] YES - this bit of MAIN fired!
[2022-09-05 19:42:21 +0800] [638] [DEBUG] connectCamera entered
[2022-09-05 19:42:21 +0800] [638] [DEBUG] connectCamera retries = 4
[2022-09-05 19:42:21 +0800] [638] [DEBUG] connectCamera GPhoto2Error: [-7] I/O problem
[2022-09-05 19:42:21 +0800] [638] [DEBUG] connectCamera returning None
[2022-09-05 19:42:21 +0800] [638] [DEBUG] ASCII = 48
[2022-09-05 19:42:21 +0800] [638] [DEBUG] Status received was: >20220905<
[2022-09-05 19:42:21 +0800] [638] [DEBUG] ASCII = 49
[2022-09-05 19:42:21 +0800] [638] [DEBUG] Status received was: >194220<
[2022-09-05 19:42:22 +0800] [638] [DEBUG] ASCII = 50
[2022-09-05 19:42:22 +0800] [638] [DEBUG] Status received was: >19999:21945<
[2022-09-05 19:42:22 +0800] [638] [DEBUG] connectCamera entered
[2022-09-05 19:42:22 +0800] [638] [DEBUG] connectCamera retries = 1
[2022-09-05 19:42:22 +0800] [638] [DEBUG] connectCamera GPhoto2Error: [-7] I/O problem
[2022-09-05 19:42:22 +0800] [638] [DEBUG] connectCamera retries = 2
[2022-09-05 19:42:22 +0800] [638] [DEBUG] connectCamera GPhoto2Error: [-7] I/O problem
[2022-09-05 19:42:24 +0800] [638] [DEBUG] connectCamera retries = 3
[2022-09-05 19:42:24 +0800] [638] [DEBUG] connectCamera GPhoto2Error: [-7] I/O problem
[2022-09-05 19:42:24 +0800] [638] [DEBUG] connectCamera retries = 4
[2022-09-05 19:42:24 +0800] [638] [DEBUG] connectCamera GPhoto2Error: [-7] I/O problem
[2022-09-05 19:42:24 +0800] [638] [DEBUG] connectCamera returning None
[2022-09-05 19:42:24 +0800] [638] [DEBUG] getLargestImageSize returned: 100000
[2022-09-05 19:42:24 +0800] [638] [DEBUG] ASCII = 51. Returned cached value ''
[2022-09-05 19:48:35 +0800] [638] [DEBUG] GET /camera
[2022-09-05 19:48:35 +0800] [638] [DEBUG] connectCamera entered
[2022-09-05 19:48:35 +0800] [638] [DEBUG] connectCamera retries = 1
[2022-09-05 19:48:36 +0800] [638] [DEBUG] connectCamera GPhoto2Error: [-105] Unknown model
[2022-09-05 19:48:36 +0800] [638] [DEBUG] connectCamera going again without waking the camera
[2022-09-05 19:48:36 +0800] [638] [DEBUG] connectCamera retries = 2
[2022-09-05 19:48:36 +0800] [638] [DEBUG] connectCamera GPhoto2Error: [-105] Unknown model
[2022-09-05 19:48:36 +0800] [638] [DEBUG] connectCamera waking the camera & going again
[2022-09-05 19:48:39 +0800] [638] [DEBUG] connectCamera retries = 3
[2022-09-05 19:48:39 +0800] [638] [DEBUG] connectCamera GPhoto2Error: [-105] Unknown model
[2022-09-05 19:48:39 +0800] [638] [DEBUG] connectCamera going again without waking the camera
[2022-09-05 19:48:39 +0800] [638] [DEBUG] connectCamera retries = 4
[2022-09-05 19:48:39 +0800] [638] [DEBUG] connectCamera GPhoto2Error: [-105] Unknown model
[2022-09-05 19:48:39 +0800] [638] [DEBUG] connectCamera waking the camera & going again
[2022-09-05 19:48:40 +0800] [638] [DEBUG] connectCamera returning None

Pi model:Raspberry Pi Zero 2 W Rev 1.0
Pi os version:Raspbian GNU/Linux 11 (bullseye)
Pi os 'bitness':32
Pi hostname:raspberrypi

Libgphoto2 version: 2.5.30.1

Python-gphoto2 version: 2.3.4

wj7106, 2022-09-05:
When I connect the monitor, enter the user name and password to log in to the system, and then wake up the camera again, I can recognize it ！
 Gunicorn.error display [2022-09-05 19:57:19 +0800] [638] [DEBUG] GET /camera
[2022-09-05 19:57:21 +0800] [638] [DEBUG] Returned after detecting camera wake command
[2022-09-05 19:57:22 +0800] [639] [DEBUG] GET /camera
[2022-09-05 19:57:22 +0800] [639] [DEBUG] connectCamera entered
[2022-09-05 19:57:22 +0800] [639] [DEBUG] connectCamera retries = 1
[2022-09-05 19:57:22 +0800] [639] [DEBUG] connectCamera has made a connection to the camera. Exiting
[2022-09-05 19:57:22 +0800] [639] [DEBUG] connectCamera returning 3 values

greiginsydney, 2022-09-06:
That's really strange!

I can't understand how logging in as the pi user on the console affects the intvlm8r. I can only guess that an I/O error like this might be permissions-related.

Let me see if I can get my mitts on a Pi Zero 2 W to test with.

greiginsydney, 2022-09-08:
Right. Here's the problem:

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

wj7106, 2022-09-08:
The problem that the new installation has been unable to install has been found. There is a problem with the latest version of bcrypt 4.0.0. There has been an error with pep517. I changed it to PIP3 install bcrypt = = 3.2.2. The installation can pass

greiginsydney, 2022-09-08:
Is that a different issue?

Closed 2022-09-16.

Thread 128 (2022-10-03):

Intermittent "502 BAD GATEWAY" error after setting the Pi's time

greiginsydney, 2022-10-03:
Setting the Pi's date/time on the /system page might result in the intvlm8r crashing with a "502 BAD GATEWAY" error.

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

The intvlm8r also logs a [CRITICAL] WORKER TIMEOUT in gunicorn.error:

```
[2022-10-03 07:51:26 +1100] [30621] [DEBUG] POST /system
[2022-10-03 07:51:26 +1100] [30621] [DEBUG] This is the /system POST page
[2022-10-03 07:51:26 +1100] [30621] [DEBUG] Yes we got the SyncSystem button & value 20221003083353
[2022-10-03 07:51:26 +1100] [30621] [DEBUG] Checked: setPiTime
[2022-10-03 08:33:53 +1100] [30621] [DEBUG] setTime result = Mon  3 Oct 08:33:53 AEDT 2022
[2022-10-03 08:33:53 +1100] [30621] [DEBUG] GET /system
[2022-10-03 08:33:53 +1100] [380] [CRITICAL] WORKER TIMEOUT (pid:30623)
[2022-10-03 08:33:53 +1100] [30623] [INFO] Worker exiting (pid: 30623)
```

### Root cause

The "worker-bees" that run the intvlm8r are set to automatically restart if they've been idle/waiting for something for > 5 minutes. Changing the real time upsets the means they use to test this, and they restart.

This is a known issue in Gunicorn: https://github.com/benoitc/gunicorn/issues/1965

### Workaround

Just press F5/reload the page. The "crash" is only for the time it takes the workers to restart.

&nbsp;<br>

\- Greig.

greiginsydney, 2024-01-25:
Resolved with PR https://github.com/benoitc/gunicorn/pull/1967

Confirmed with repeated testing that this issue is resolved in the intvlm8r.

Closed 2024-01-25.

Thread 129 (2023-01-16):

"building wheel for bcrypt (pep 517) ... error"

greiginsydney, 2023-01-16:
Setup step for SFTP fails with this error:

```
building wheel for bcrypt (pep 517) ... error
```

It looks as though v4 of bcrypt is no longer supported on the Pi (or at least in this fashion).

Refer:
https://stackoverflow.com/questions/63509419/error-could-not-build-wheels-for-bcrypt-which-use-pep-517-and-cannot-be-install
https://www.piwheels.org/project/bcrypt/

greiginsydney, 2023-10-29:
It seems bcrypt has been updated. See https://www.piwheels.org/project/bcrypt/

Closed 2023-10-29.

Thread 130 (2023-01-29):

Kernel panic if Pi shutdown from cmdline

greiginsydney, 2023-01-29:
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

[Image lifted from one of the reference links below].

The Pi has manifested this issue for some time, but as I'm the only one likely to ever encounter it, I've had it low on the TODO list.

Previuous investigations have revealed the cause: that by using `gpio-poweroff` in the setup.sh script (as part of the handshaking between Pi and Arduino) I've broken the normal shutdown process.

```bash
#Set GPIO27 to follow the running state: it's High while running and 0 when shutdown is complete. The Arduino will monitor this pin.
dtoverlay=gpio-poweroff,gpiopin=27,active_low
```

References:
https://forums.raspberrypi.com/viewtopic.php?t=143519
https://raspberrypi.stackexchange.com/questions/127947/pi-zero-doesnt-fully-shut-down-after-adding-a-gpio-poweroff-dtoverlay-to-boot

[Yup, this is me](https://github.com/raspberrypi/linux/issues/3372#issuecomment-562533582):
> "Use of this overlay (and the gpio-poweroff mechanism) required that there is an external mechanism to remove the power in response to the GPIO being toggled. Failure to do so within the allowed window (3 seconds is the default) results in a kernel warning, followed by undefined behaviour."

<br>

-----

<br>

Today I've encountered the same kernel panic in another Pi-based project, and I commenced some fresh investigation into the issue, which has unearthed [this apparent gem](https://www.richinfante.com/2021/08/11/raspberry-pi-gpio-status-lights):

> "Some approaches for a constant status led (ab)use the gpio-poweroff overlay which interrupts proper shutdown procedures, but gpio-led doesn’t."

So I'm experimenting with this as a replacement line:
`dtoverlay=gpio-led,gpio=27,trigger=default-on,active_low`

It won't be in 'vNext' (4.5.1) as I want to let it soak for QUITE a while in Dev before I let it loose on you.

More references:
https://raw.githubusercontent.com/raspberrypi/firmware/master/boot/overlays/README

<br>

\- Greig.

franioli, 2023-06-01:
Hi Greig,
I am experiencing the same bug with intvlmt8r 4.5.2 (I am trying right now the new version 4.5.3).
I will try to update the setup.sh script uncommenting these lines of code and I will test it.

greiginsydney, 2023-06-02:
Hi Francesco,

Please be VERY careful tinkering with any of the code that controls the power interaction between the Pi and the Arduino. Get that wrong and you risk bricking the intvlm8r - hence why i've been taking it very carefully.

This 'issue' isn't one anyone will encounter in the field - it only manifests on the bench, so I wouldn't be too concerned for it.

Having said that I'm happy to receive input and suggestions if you do invest some time into it.

\- G.

Thread 136 (2023-05-24):

Save to USB

DaveJ1013, 2023-05-24:
Hi Greig,   have a potential customer that wont allow wifi on the site. Was wondering about the possibility of saving the pics to a USB stick and replacing the USB stick with a new one every few weeks.

Cheers
Dave Jeffries

greiginsydney, 2023-05-25:
Hi Dave,

Ouch. Tough ask.

How strict is this customer? Is the Wi-Fi radio itself banned from site, or just the use of? (I've worked in an environment before where devices couldn't even possess the radio hardware).

The Pi Zero "non W" that would meet the former requirement, but that looks to be the only recent (current) Pi without Wi-Fi, and without an Ethernet port you couldn't get to the web UI to manage it. (I'm avoiding going down the rabbit-hole of USB hubs and USB Ethernet adapters).

Assuming we're allowed a Pi with a W-Fi radio that's disabled (including having removed all its drivers), and Ethernet, the trick would be to connect either a memory stick or an external SSD to one of the Pi's USB ports, and redirect the /photos/ directory to that location. It'd need to handle you removing/replacing that drive, but it wouldn't surprise me if Raspbian already does that.

Of course if Ethernet's allowed - at least locally on site - you have management access and it can upload the images directly to a PC/laptop each day.

Another "solution" not without risk is to just use a giant memory card in the camera, but each time you replace it you risk moving the enclosure or camera... And that's a single point of failure.

<br>

\- Greig.

DaveJ1013, 2023-05-25:
Hi Greig,They are OK with it containing WiFi as long as it does not connect to any external network, including via 4g.  The cameras would be on existing towers (about 20 mtrs high) and have to be solar powered.  Access to the cameras afterwards could only be achieved with a hydraulic platform.  Hence the idea of an external USB or SSD on a long wire.I am hoping that a once a month visit for data collection would work.  Size of data shooting raw at 120 pictures a day would be around 80Gb a month for each of 2 cameras  Even if I could connect via WiFi at the visit,  I hate to think how long the transfer would take!The site will be a munitions factory and the build is scheduled to take around 2 years.  Any other ideas would be very welcome.All the bestDave JFrom: Greig Sheridan ***@***.***>Sent: Thursday, 25 May 2023, 02:14To: greiginsydney/Intervalometerator ***@***.***>Cc: DaveJ1013 ***@***.***>; Author ***@***.***>Subject: Re: [greiginsydney/Intervalometerator] Save to USB (Issue #136)
Hi Dave,
Ouch. Tough ask.
How strict is this customer? Is the Wi-Fi radio itself banned from site, or just the use of? (I've worked in an environment before where devices couldn't even possess the radio hardware).
The Pi Zero "non W" that would meet the former requirement, but that looks to be the only recent (current) Pi without Wi-Fi, and without an Ethernet port you couldn't get to the web UI to manage it. (I'm avoiding going down the rabbit-hole of USB hubs and USB Ethernet adapters).
Assuming we're allowed a Pi with a W-Fi radio that's disabled (including having removed all its drivers), and Ethernet, the trick would be to connect either a memory stick or an external SSD to one of the Pi's USB ports, and redirect the /photos/ directory to that location. It'd need to handle you removing/replacing that drive, but it wouldn't surprise me if Raspbian already does that.
Of course if Ethernet's allowed - at least locally on site - you have management access and it can upload the images directly to a PC/laptop each day.
Another "solution" not without risk is to just use a giant memory card in the camera, but each time you replace it you risk moving the enclosure or camera... And that's a single point of failure.

- Greig.

—Reply to this email directly, view it on GitHub, or unsubscribe.You are receiving this because you authored the thread.Message ID: ***@***.***>

greiginsydney, 2023-05-25:
OK, so if the intvlm8r can connect to an "internal" Wi-Fi network that's on site, I'd drop a [conveniently ground-level] 'management server' there, and all the intvlm8r's would upload on their schedule to *it*. The could be a Windows PC or even another Pi.

Operating as an island like that you'd have no heartbeating, but with two cameras each provides a degree of redundancy should the other take an unexpected break from shooting.

Unrelated question: what timeframe are you looking at? The real-time clock IC is only now *just* returning from 'unobtainium'. I can buy it from component suppliers overseas today (news to me just now actually!), but the plugin Sparkfun unit spec'd for the intvlm8r isn't yet shipping. It shouldn't be won't be long though.

\- G.

DaveJ1013, 2023-05-25:
Hi Greig,I'll ask some more questions to check my understanding but, I don't think it will be possible to locate a server as there's no power anywhere near the camera locations.  It's going to be a few months until ground work starts, but I have 1 camera ready to go and a spare board already built.  I could build the 2nd camera up in a few days if needed.All the bestDave JFrom: Greig Sheridan ***@***.***>Sent: Thursday, 25 May 2023, 08:50To: greiginsydney/Intervalometerator ***@***.***>Cc: DaveJ1013 ***@***.***>; Author ***@***.***>Subject: Re: [greiginsydney/Intervalometerator] Save to USB (Issue #136)
OK, so if the intvlm8r can connect to an "internal" Wi-Fi network that's on site, I'd drop a [conveniently ground-level] 'management server' there, and all the intvlm8r's would upload on their schedule to it. The could be a Windows PC or even another Pi.
Operating as an island like that you'd have no heartbeating, but with two cameras each provides a degree of redundancy should the other take an unexpected break from shooting.
Unrelated question: what timeframe are you looking at? The real-time clock IC is only now just returning from 'unobtainium'. I can buy it from component suppliers overseas today (news to me just now actually!), but the plugin Sparkfun unit spec'd for the intvlm8r isn't yet shipping. It shouldn't be won't be long though.
- G.

—Reply to this email directly, view it on GitHub, or unsubscribe.You are receiving this because you authored the thread.Message ID: ***@***.***>

greiginsydney, 2023-05-27:
Ok, so assuming Wi-Fi is permissible, I'd:
- Build the PCB and camera in a box, mounted high up the pole
- Put a GIANT memory card in the camera, and same in the Pi
- Locate the battery, charger and possibly the solar cell in/on a box at or near ground level
- Extend the reed switch cabling to the lower box. This will allow you to wake the intvlm8r on demand. (You could do this crudely by simply putting a cutoff (key?) switch in the power line up to the camera, as the Pi will always wake upon the re-connection of power. Only caveat here is that you DON'T want to be cutting power when the Pi is running, as that risks drive corruption. I've never had it happen, but Murphy's Law...)

When woken, the Pi will come up as an access point and you can connect your PC/Mac to it and suck the images, either [manually](https://github.com/greiginsydney/Intervalometerator/blob/bugs2304/docs/manually_download_images.md), or by firing a "Transfer Now" from the /transfer page, with your computer setup as the target, running ftp, rsync, etc.

How's that sound?

If you can't Wi-Fi things get "interesting".

DaveJ1013, 2023-05-27:
Hi Greig,Will give this a try with a couple of 128Gb cards.  I was thinking of leaving all the power,  solar and charger on the mast and just bringing the reed switch out. Any issue you see with that?Would there be any difference in using my laptop as the access point so that the normal setup stays on the intvlm8 as opposed to the AP configuration? My only fear is how long the transfer will take!  All the bestDave JFrom: Greig Sheridan ***@***.***>Sent: Saturday, 27 May 2023, 07:22To: greiginsydney/Intervalometerator ***@***.***>Cc: DaveJ1013 ***@***.***>; Author ***@***.***>Subject: Re: [greiginsydney/Intervalometerator] Save to USB (Issue #136)
Ok, so assuming Wi-Fi is permissible, I'd:

Build the PCB and camera in a box, mounted high up the pole
Put a GIANT memory card in the camera, and same in the Pi
Locate the battery, charger and possibly the solar cell in/on a box at or near ground level
Extend the reed switch cabling to the lower box. This will allow you to wake the intvlm8r on demand. (You could do this crudely by simply putting a cutoff (key?) switch in the power line up to the camera, as the Pi will always wake upon the re-connection of power. Only caveat here is that you DON'T want to be cutting power when the Pi is running, as that risks drive corruption. I've never had it happen, but Murphy's Law...)

When woken, the Pi will come up as an access point and you can connect your PC/Mac to it and suck the images, either manually, or by firing a "Transfer Now" from the /transfer page, with your computer setup as the target, running ftp, rsync, etc.
How's that sound?
If you can't Wi-Fi things get "interesting".

—Reply to this email directly, view it on GitHub, or unsubscribe.You are receiving this because you authored the thread.Message ID: ***@***.***>

greiginsydney, 2023-05-27:
> I was thinking of leaving all the power,  solar and charger on the mast and just bringing the reed switch out. Any issue you see with that?

My primary concern there is with the camera 20m up in the air, I'd be happier having the power side of things more accessible to you at ground level.

My friend @techydude has also wisely counselled against extending the reed line down the pole, as it will become a great antenna for injecting ESD into the board. I'd instead employ a relay or opto-isolator to electrically isolate the cable coming down the pole from the PCB. Let me know if that's not clear and I'll rough up a circuit.

> Would there be any difference in using my laptop as the access point so that the normal setup stays on the intvlm8 as opposed to the AP configuration?

I don't think you'll get your lappy to make an AP, so you'll need to bring an independent AP with you that the intvlm8r and lappy will join its network.

> My only fear is how long the transfer will take!

Yes, it might take a while depending on how frequently you visit the site.

In an off-grid setup the Pi will only power up for the maximum of an hour before it goes back to sleep, but with you on-site you can keep pressing the 'reed' button and that will extend the timer for another hour each time.

Closed 2023-06-28.

Thread 137 (2023-05-27):

Replacement for DeadOn RTC: DS3231?

franioli, 2023-05-27:
Hi Greig,
Thanks for your great work!
I've already built 2 intervalometers for my PhD project on high-frequency glacier monitoring using stereo photogrammetry. The two cameras have been working for more than a year on a glacier in the Italian Alps.
Now I was thinking of building another camera to extend the monitored area, but the RTC clock seems to be impossible to get... So I wanted to ask you if you think there are any alternatives that could work without a massive rewrite of the Arduino code. I found that the closest might be the DS3231, which should be almost as accurate as the Sparkfun and supports two alarms, but has an I2C interface. Do you have any experience with this? Or do you have any suggestions?

Thanks again!

Francesco

greiginsydney, 2023-05-27:
Hi Francesco,

It's great to hear the intvlm8r has been of use to you, and that the boards have such a lovely view!

As you've already found, I painted myself into a corner using the Deadon RTC boards, as that clock IC is the only one on the planet that uses an SPI interface. Unfortunately I don't have the option of rewriting the code for I2C because of how the Pi and Arduino use that bus.

BUT THERE'S GOOD NEWS!

After a couple of years out of stock, the DS3234 is on its way back! SparkFun doesn't seem to have them yet, but that can't be far off, as Mouser has them (the chip) available today.

Do you have a deadline for when you need this new unit?

\- G.

franioli, 2023-05-29:
Hi Greig,
thanks for the answer. I can understand your point.
You're right about the chips, but actually Mouser says that the expected date for the RTC availability will be in Dicember 2023. That's a bit too late for me, as I would like to build a new system before winter, but that's it... let's wait and hope in good news.

Btw, I am currently using SIM7600E-H 4G HAT (https://www.waveshare.com/wiki/SIM7600E-H_4G_HAT) connected to the Rasp Zero for 4G connection. If you are interested, I can try to write a piece of documentation and add it in the setup-remote guide.

greiginsydney, 2023-05-29:
They have 1,717 of the [DS3234S#](https://au.mouser.com/ProductDetail/Analog-Devices-Maxim-Integrated/DS3234S?qs=1eQvB6Dk1vhNRvcRKqeJUg%3D%3D), which is the 0-70°C version - the same as what SparkFun uses.

I guess yes if you'll be sitting atop a glacier, the DS3234SN# rated for -40°C to +85°C would be a better idea. Element14 says they're "Awaiting Delivery by 22/08/23", which is a more friendly date.

If you're up for some surface-mount soldering (or know someone who can do it), I might be able to find you a prototype PCB that will take the 3234SN directly on-board.

And thanks for the offer of the doco edit. I'd be delighted if you could branch the repo and add the SIM7600E-H 4G HAT as a new heading after "4G/5G dongle" (immediately before "install remote.it"). Some images and text would be lovely. Don't worry about formatting - I can do that. Let me know if that's a blur of techno-babble and I can walk you through it.

\- G.

Closed 2023-06-28.

Thread 138 (2023-05-27):

Function suggestion: Add flash hot shoe signal to arduino

wj7106, 2023-05-27:
Suggestion: Can the shutter end signal from the camera flash hot shoe be introduced into Arduino to count the number of successful shots taken on that day or month in the system? I have seen that the Pixhawk PIX4 used in the aircraft model has this module function, which can count the number of successful shots. If the intvlm8r can add this input function, I think I can fully use ultra high definition 8k records like Sony a7rm2!

greiginsydney, 2023-05-27:
That's a neat idea.

What are you proposing the Arduino would do if the 'fire' signal doesn't see a corresponding flash? Obviously a re-take attempt would be the first action, but then what?

How often does the intvlm8r trigger a shot that the camera fails to take? I can only see that happening if the camera's in AF mode, and the trigger time isn't long enough.

<br>

\- G.

wj7106, 2023-05-28:
By using the flash hot shoe signal, the camera's shooting results can be more directly monitored. The number of shots taken and missed shots will be clear at a glance. For some cameras that do not support the gphoto plugin, such as the Sony A7 series, Fuji series, or other micro single camera, as long as the camera with the flash hot shoe is equipped, except for not being able to connect to raspberry zero via USB to preview and transfer photos to the pi, it can be controlled by the shutter cable for shooting. I have been using this system to shoot engineering projects for 2 years, so I don't need to record the current number of shots every time I log in to the system

Thread 139 (2023-05-27):

Camera time not updating from the web interface

aerialvideographyuk, 2023-05-27:
Just put a test camera up for a future project.
While setting the time from the web interface for pi, arduino and camera, the camera doesn't set and goes to 2000 Jan 01 00:00:00
Further attemps at just setting the camera only results in the same issue.

greiginsydney, 2023-05-27:
Hi Dave,

<br>

"Alt camera time mode" should fix that:

<br>

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

Let me know if not and hopefully we can work together on a better fix.

<br>

\- G.

greiginsydney, 2023-06-01:
Hey @aerialvideographyuk have you had any luck with that?

greiginsydney, 2023-06-16:
I've created a new FAQ to help anyone encountering this issue in the future:
-  [Why cant I set the camera's time correctly](https://github.com/greiginsydney/Intervalometerator/blob/master/docs/FAQ.md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)

Closed 2023-08-16.

Thread 142 (2023-06-20):

Function suggestion: Add to Intervalometer Settings Interval in Seconds.

szesnascie, 2023-06-20:
Sometimes I need to take pictures more than every minute, sometimes even every few seconds. It would be nice if you could add an additional option in which you could choose the interval in seconds.

greiginsydney, 2023-06-21:
Hi @szesnascie, thanks for the suggestion.

Can you tell me a little more about your application? You need all the functionality of the intvlm8r *and* potentially as many as 20 or 30 images a minute through each day's shooting hours?

Ramping up the shooting schedule to that frequency would not be without its challenges, but I think the bigger issue would then become getting all those images off the camera, then off the Pi.

\- G.

szesnascie, 2023-06-21:
hi, @greiginsydney I often have a situation that I need to register a process that lasts an hour, maximum two hours. The current configuration allows me to set a maximum of 60 photos in an hour, of which I can get 2s of film, which is definitely not enough so I have to show up with my equipment on site and record it separately. Most often, these are situations that occur suddenly because for some reason the work schedule has been changed. Thanks to this functionality, I could remotely manage a few hours schedule that would very accurately record the process I am interested in. After the end, I would change the schedule to "normal intervals".

greiginsydney, 2023-06-22:
So you have an intvlm8r up covering a 'build' of some sort that has bursts of intense activity that you need to capture?

I presume this is a site with power, so you have the luxury of the Pi always running, and the ability to update the schedule remotely at any time?

If I were able to update the shooting frequency to 'every x seconds', what's the minimum 'x' (maximum 'frame rate') you'd be seeking? (I'm guessing during these bursts that would be the one rate you'd shoot at? You'd go from 'normal' intervals, to the fastest possible, then back again later?)

greiginsydney, 2023-06-22:
If you're shooting a hypothetical 10 shots a minute for two hours, that's 1200 shots, and at 5MB each, you've shot 6 Gig you need to get off the camera to the Pi, then uploaded somewhere... Is this do-able without a site visit anyway? And how often does this happen?

szesnascie, 2023-06-23:
Exactly, I have power all the time. The minimum 'x' is 5. File management is not a problem for me. I have this event once a week, sometimes less often.

greiginsydney, 2023-06-24:
OK, leave it with me and I'll peruse the code and see how readily it could be implemented - and if doing so won't upset other functionality.

\- G.

szesnascie, 2023-06-24:
🙏🏻🙌🏻🙌🏻🙌🏻

szesnascie, 2023-07-03:
Hi, @greiginsydney did you have a time to peruse the code and see how readily it could be implemented?

-Sz.

greiginsydney, 2023-07-03:
Hi @szesnascie, I have and I think it's something the Arduino can do.

My current plan is for the timer to fire each minute - as it does now when set for 60 shots/hour - but each firing triggers a sequence of timed shots rather than just one. The outcome is a shot every 'n' seconds.

I'm in NZ at the moment but when I'm home next week I'll rough this up in the lab and see how reliably it works.

(I have an update in the wings that will be released before I start on this).

I'll let you know how it goes.

\- Greig.

szesnascie, 2023-07-03:
@greiginsydney awsome great news, can't wait! Enjoy your stay!!!
- Sz.

greiginsydney, 2023-07-16:
A first test of the code today. Rather than work the camera's shutter for these test shots, I hook my digital counter up.

This is what an HOUR of shooting results in when you set a 3s interval!

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

(I'm still not sure I want to let this out the door shooting at that frequency, but that's a number I'm toying with at the mo).

\- Greig.

szesnascie, 2023-07-16:
Awsome Greig.
We can use one of my stations for testing before release.
Sz

greiginsydney, 2023-07-16:
This update requires changes to both the Arduino and Pi. Do you have a [programming cable for the Arduino](https://www.sparkfun.com/products/9873)?

greiginsydney, 2023-10-29:
This functionality will be added in [v4.6.0](https://github.com/greiginsydney/Intervalometerator/releases/v4.6.0), due this side of Christmas.

You'll be able to shoot up to one image every **three seconds**.

This mode comes with a big "at your own risk" caveat, and at its fastest probably requires a supervised environment where you have mains power and direct access to the camera to replace the memory card at the end of each day's shooting.

Here's a sneak-peek at the UI:

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

<br>

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

szesnascie, 2023-10-30:
This is great news, thank you for your work and time spent on the project!

greiginsydney, 2023-12-10:
Closed with the release of [v4.6.0](https://github.com/greiginsydney/Intervalometerator/releases/tag/v4.6.0)

Closed 2023-12-10.

Thread 143 (2023-06-26):

rsync "ssh-copy-id" command err's with 'ERROR: Too many arguments.'

greiginsydney, 2023-06-26:
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

greiginsydney, 2023-06-26:
Something's changed in the rsync setup: the order of the switches is now important.

The command changes from:
```
ssh-copy-id -i ~/.ssh/id_rsa.pub <rsync_user>@<host> -f
```
(with the `-f` on the end)

... to:
```
ssh-copy-id -f -i ~/.ssh/id_rsa.pub <rsync_user>@<host>
```

I've just updated https://github.com/greiginsydney/Intervalometerator/blob/master/docs/step4-setup-upload-options.md#rsync to the new syntax.

\- G.

Closed 2023-06-26.

Thread 144 (2023-06-28):

Remote.it installs OK, but setup.sh fails with 'remoteit is not installed' & celery no longer starts

greiginsydney, 2023-06-28:
Remote.it installs OK:

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

... but the install script doesn't detect it:

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

The [remote.it] "connectd" service no longer exists.

Remote.it has changed their packaging for the Pi, and the "connectd.service has not existed for quite a while."

greiginsydney, 2023-06-28:
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

Celery *initially* fails to start, but does eventually.

mmunsk, 2023-10-22:
Hi, does this mean that the intervalometerator doesn't work anymore? How does this affect its functionality?

greiginsydney, 2023-10-22:
All good @mmunsk - turns out it's all good.

With its new install process, remote.it - and the intvlm8r - work fine, it's just that my previous fix is now redundant.

Because it all works so well I've not made it a priority to update the './setup test' code. Ta for the nudge.

\- G.

mmunsk, 2023-10-23:
Hey Greig,
Quick question.
I'm setting up a camera far away.
If I needed to get heartbeats can I just have them sent to my email?
Or is this just for a website URL?

In any case how can I set this up to get these heartbeats and make sure the camera is working?

Thanks.

-------- Original message --------
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

greiginsydney, 2023-10-23:
Check out the [setup-heartbeating.md](https://github.com/greiginsydney/Intervalometerator/blob/master/docs/setup-heartbeating.md) page. There's virtually nothing to do in the intvlm8r itself - it's all in the service you use. I've been using - and love - deadman's snitch.

\- G.

Closed 2023-10-28.

Thread 150 (2023-12-15):

4.6.0 version cannot change camera parameters

wj7106, 2023-12-15:
I don't know if everyone has installed and run version 4.6.0. I can't change camera parameters on the camera page, but there was an error when confirming!

Browser display:

Bad Request
The browser (or proxy) sent a request that this server could not understand.

greiginsydney, 2023-12-15:
Whoops. Yes that's definitely a bug.

I should be able to get 4.6.1 out later today to fix that.

Thanks for bringing it to my attention.

Closed 2023-12-16.

Thread 155 (2024-02-21):

Feature suggestion: add support for USB storage of images / use USB instead of MicroSD card

greiginsydney, 2024-02-21:
The MicroSD card resident in the Pi has a theoretical maximum number of read/write cycles in it. I've never had one fail, but it's regularly suggested to use external (SSD) storage as an alternative.

This might also add some speed improvements, although obviously with an increased power consumption requirement, and the need to introduce a USB hub into the signal flow between Pi & camera (given the Pi Zero W and Zero 2 W only have one workable USB port).

wj7106, 2024-09-12:
I am very much looking forward to the release of this feature version, and if possible, I also look forward to supporting the Sony a7r2,a7r3 system

Thread 161 (2024-09-13):

Can the intvlm8r support usb-only cameras?

greiginsydney, 2024-09-13:
I've been asked if the intvlm8r can be tweaked to support the Canon SL3 and other cameras that only have a USB interface.

As it stands today that's a hard no.

The Pi is the brains of the action, but it's purely there for management (and not always running due to its current consumption).

The Arduino calls the shots - metaphorically and literally (I think that holds up grammatically) - using an old-skool emulation of the shutter button.

Changing the intvlm8r so the Arduino asks the Pi to fire a shot (with the latter doing so via USB) is going to be a challenge, not the least because the I2C interface between them is 'Master/Slave', and the Pi can only be the master in this pairing. That means the slave can't tell the master what to do, which is what this would require.

Hypothetically it might be possible with a hardware mod to the board, but I'm running low on spare IO pins on the Arduino...

Leave it with me and I'll ponder it for a bit.

<br>

/- Greig.

Thread 162 (2025-01-30):

Frequent "502 Bad Gateway" and "Celery not running" warning when home does load

benjigreig, 2025-01-30:
I'm setting up to new boards and putting the current version of the repo on following your docs. I've gotten through the process of getting everything installed and it all seems to be running as intended (based on the instructions).

However after booting the pi, when I log into the intervalometertor local website on the Pi I frequently get 502 errors. If and when I do get the index page I'm generally met with a "Celery not running" warning message.

Not sure how to proceed. Have tried reinstalling from the setup.sh but have the same issue.

benjigreig, 2025-01-30:
Interestingly if I reinstall with the "sudo -E ./setup.sh web" again and then jump into a browser without rebooting it works fine. But post reboot it misbehaves again.

greiginsydney, 2025-01-30:
Celery is probably the slowest component to come up.

Have you tried just waiting a while??

benjigreig, 2025-01-30:
Yeah have left it sit for ages, but it seems to have issues. I've rebuilt on another sd on one of my other boards. Will test that out and clone that SD I think... Fingers crossed.

Will post back once I've tested.

greiginsydney, 2025-01-31:
The Celery log will hopefully reveal the source of its issues:

/var/log/celery/celery_worker.log

greiginsydney, 2025-02-07:
@benjigreig have you had any luck with the Celery log?

Is this problem related to just one board, or ALL the new ones you've built?

greiginsydney, 2025-02-12:
FYI I've just done a new build of v5.0.0 (admittedly, onto a Pi 3) and it's working fine out of the box. Celery is happy.

(The web setup step threw an error about rc.local, but that isn't an issue, and will be fixed in the next release).

\- G.

benjigreig, 2025-02-12:
OK good to know about the error on rc.local I was seeing that too.
I ended up starting from scratch and managed to get it up and running without the issues recurring.
Will have to chalk this up to an unknown error on my part. Thanks for rubberducking this with me @greiginsydney.

Benj

Thread 165 (2025-03-29):

Arduino Upload error on VS Code

KC014, 2025-03-29:
The following picture is the actual device of my Arduino microcontroller.
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

Here is some basic information about this microcontroller:
Chip: ATmega4809
Clock: 20MHz
Memory: flash-48KB SRAM-6KB
Interfaces: USB, SPI, I2C, UART
Dimensions: 18 * 45mm
Link: https://store.arduino.cc/products/arduino-nano-every-with-headers

The following part is the code I just wrote on VS Code to test my Arduino microcontroller device, and this code has no compiling errors.
`#include <Arduino.h>

// put function declarations here:
// int myFunction(int, int);

void setup() {
  // put your setup code here, to run once:
  // int result = myFunction(2, 3);
  pinMode(LED_BUILTIN, OUTPUT); // Initialize the LED pin as an output
}

void loop() {
  // put your main code here, to run repeatedly:
  digitalWrite(LED_BUILTIN, HIGH); // Turn the LED on (HIGH is the voltage level)
  delay(200); // Wait for a second
  digitalWrite(LED_BUILTIN, LOW); // Turn the LED off (LOW is the voltage level)
  delay(200); // Wait for a second
}

// put function definitions here:
/*
int myFunction(int x, int y) {
  return x + y;
}
  */`

However, when I try to upload my code to my Arduino microcontroller on VS Code, VS Code gives me the following error messages. I have tried for several days but still can't resolve this issue. I'm not sure what happened.
Verbose mode can be enabled via `-v, --verbose` option
CONFIGURATION: https://docs.platformio.org/page/boards/atmelmegaavr/ATmega4809.html
PLATFORM: Atmel megaAVR (1.9.0) > ATmega4809
HARDWARE: ATMEGA4809 16MHz, 6KB RAM, 48KB Flash
PACKAGES:
 - framework-arduino-megaavr-megacorex @ 1.1.2
 - tool-avrdude @ 1.70100.0 (7.1.0)
 - toolchain-atmelavr @ 1.70300.191015 (7.3.0)
LDF: Library Dependency Finder -> https://bit.ly/configure-pio-ldf
LDF Modes: Finder ~ chain, Compatibility ~ soft
Found 12 compatible libraries
Scanning dependencies...
No dependencies
Building in release mode
Checking size .pio\build\ATmega4809\firmware.elf
Advanced Memory Usage is available via "PlatformIO Home > Project Inspect"
RAM:   [          ]   0.1% (used 4 bytes from 6144 bytes)
Flash: [          ]   1.6% (used 776 bytes from 49152 bytes)
Configuring upload protocol...
AVAILABLE: jtag2updi
CURRENT: upload_protocol = jtag2updi
Looking for upload port...
Using manually specified: COM3
Uploading .pio\build\ATmega4809\firmware.hex
avrdude warning: attempt 1 of 10: sign-on command: status -1
avrdude warning: attempt 2 of 10: sign-on command: status -1
avrdude warning: attempt 3 of 10: sign-on command: status -1
avrdude warning: attempt 4 of 10: sign-on command: status -1
avrdude warning: attempt 5 of 10: sign-on command: status -1
avrdude warning: attempt 6 of 10: sign-on command: status -1
avrdude warning: attempt 7 of 10: sign-on command: status -1
avrdude warning: attempt 8 of 10: sign-on command: status -1
avrdude warning: attempt 9 of 10: sign-on command: status -1
avrdude warning: attempt 10 of 10: sign-on command: status -1
avrdude error: timeout/error communicating with programmer (status -1)
avrdude error: unable to open programmer jtag2updi on port COM3

avrdude done.  Thank you.

*** [upload] Error 1

Can anyone tell me what happened? Why can I upload my code successfully on Arduino IDE but can't do so on VS Code?

greiginsydney, 2025-04-02:
I don't think you have the right repo

Closed 2025-04-21.

Thread 166 (2025-07-03):

Can't read /etc/rc.local: No such file or directory

DcapFC, 2025-07-03:
Hi, I'm testing the software so pi4b
In the installation step
sudo -E ./setup.sh web
I got an error
Disabled Wi-Fi power save mode
grep: /etc/rc.local: No such file or directory
sed: can't read /etc/rc.local: No such file or directory
I fixed it by recreating the /etc/rc.local file with the following basic content:
sudo nano /etc/rc.local
—————
#!/bin/sh -e
# rc.local
# Commands to run on boot
exit 0
————
sudo chmod +x /etc/rc.local
then run it again
sudo -E ./setup.sh web
I'm not sure if I did it right, but it worked.

greiginsydney, 2025-07-03:
Yeah, sorry about that. rc.local doesn't exist in some setups.

I've fixed this in the current dev branch, but I've not released it.

I'll do that later today or over the weekend. Thanks for the prompt, and sorry for the hassle.

\- Greig.

greiginsydney, 2025-07-11:
OK @DcapFC, that should be resolved now.

Please take it for a spin and let me know if you encounter any problems with it.

You should be able to jump to step 29.4 in "[Setup the pi.md](https://github.com/greiginsydney/Intervalometerator/blob/master/docs/step1-setup-the-Pi.md)"

\- Greig.

Closed 2025-07-11.
