greiginsydney/Intervalometerator/docs/intvlm8r_v11.11_circuit.pdf

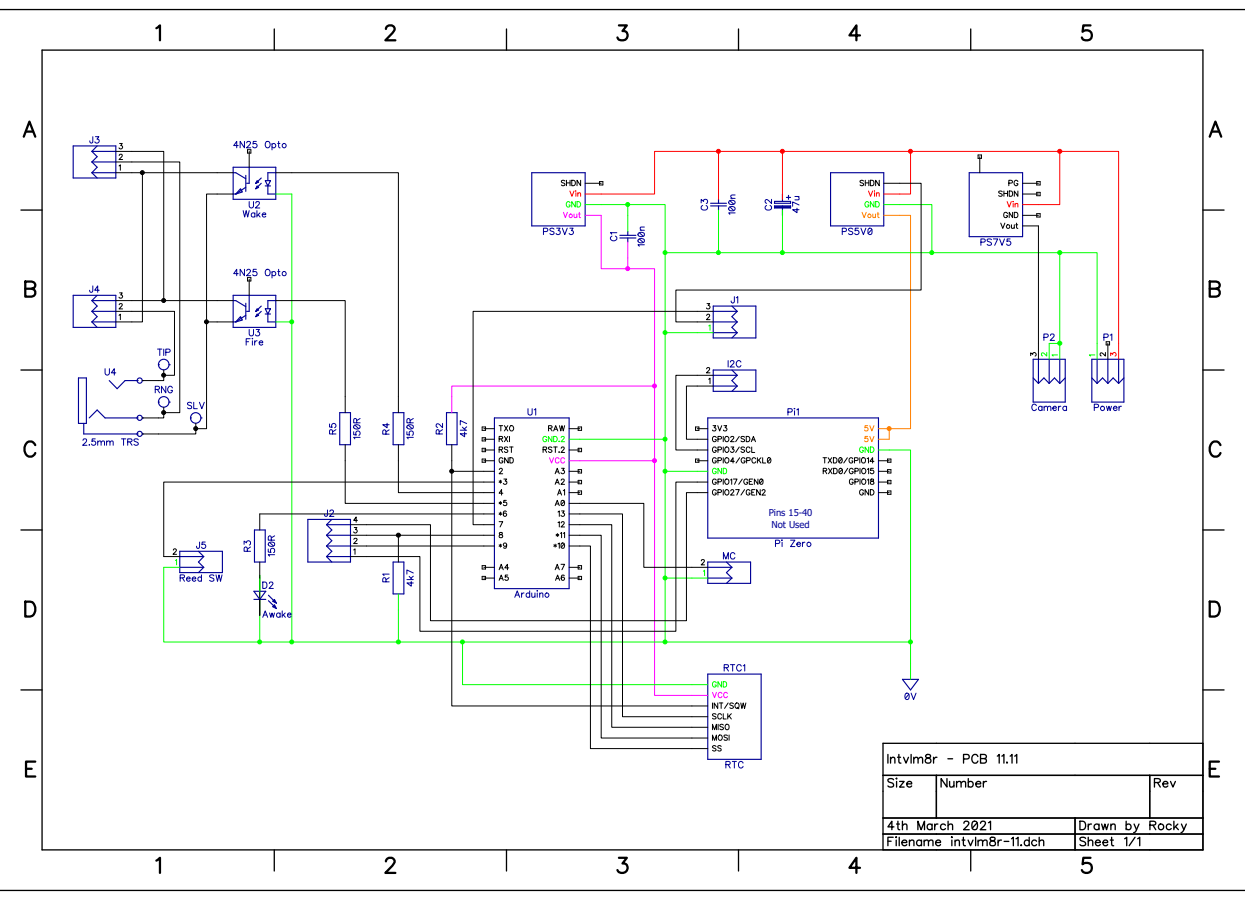
[picture p2: page 1]
Pins 15-40 Not Used
