greiginsydney/Intervalometerator/docs/intvlm8r_v11.11_comp.pdf

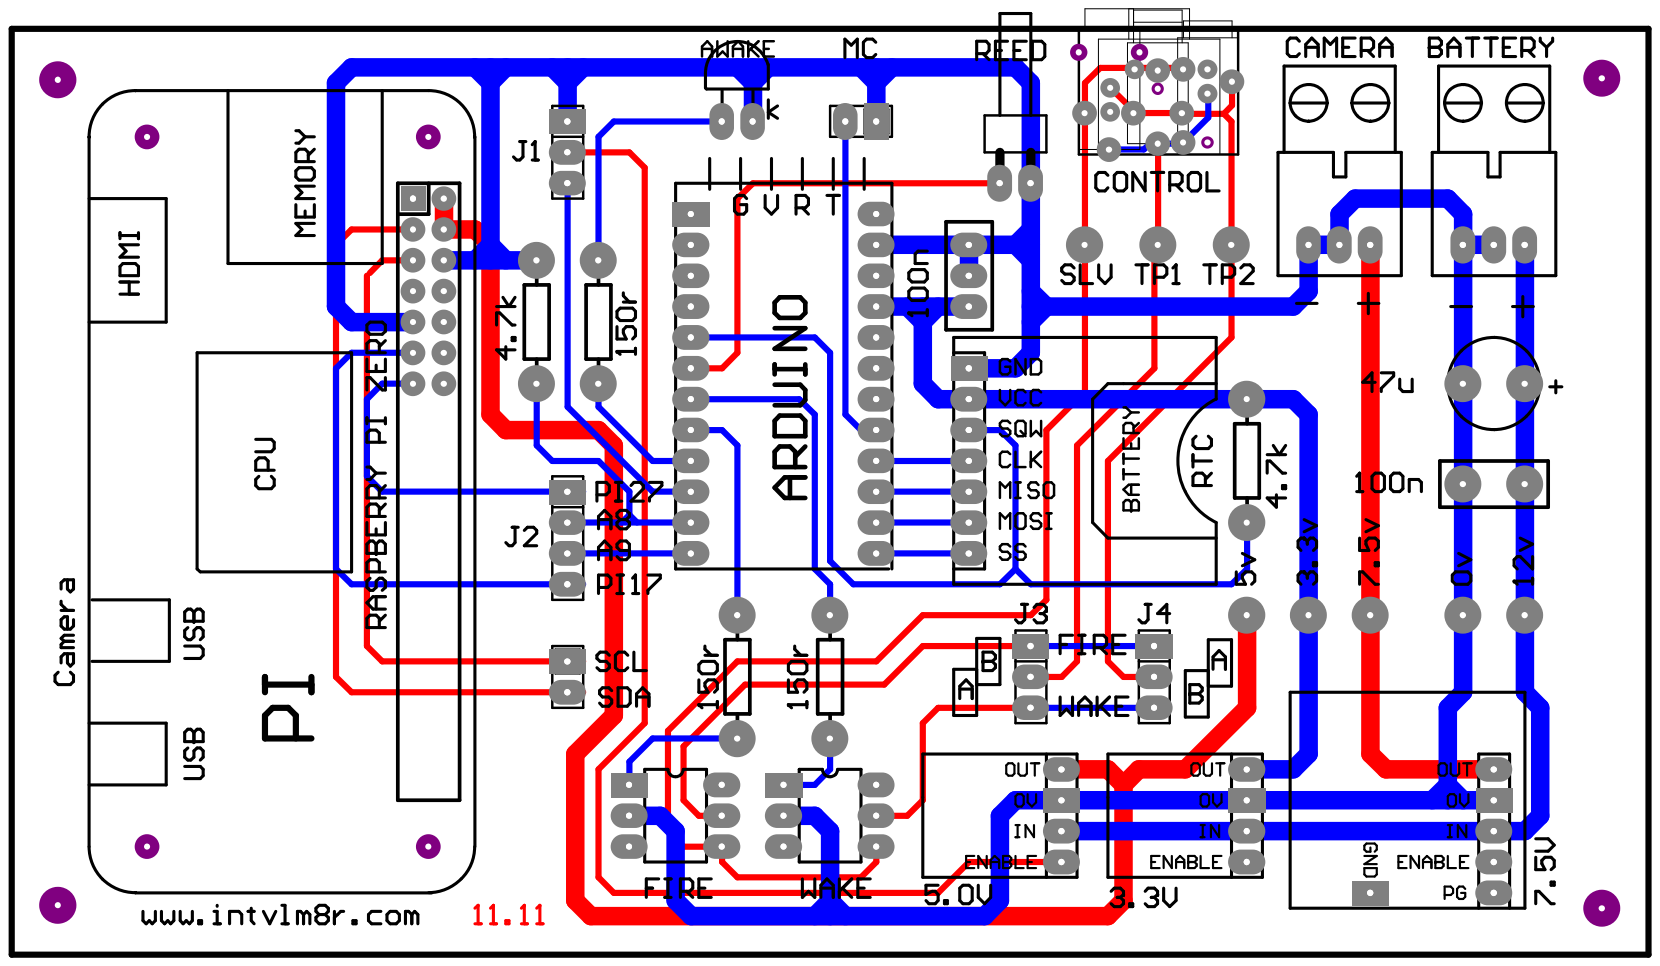
[picture p3: page 1]
