greiginsydney/Intervalometerator/(commit log)

2018-11-24 Added path to python in ExecStart=
    Also changed [Unit] "Requires=" and "After=".
    Now runs without error at launch. Debugging tip: "sudo systemd-analyze verify cameratransfer.service"
2018-11-30 Updated to accept seconds value when a new time value is pushed from the Pi. Also commented out all remaining Serial.Println lines
2018-12-02 Fixed bug with Pi not shutting down after config change
    If you changed the Pi from "Always On" to only turn on at WakePiHour, it wouldn't shutdown after WakePiDuration had elapsed.
    Fixed this and also removed some redundant code in func SetWakePiTime.
    Also deleted some old commented-out code, NLR now the project's in GitHub.
    [intervalometer.ino]
2018-12-05 Camera battery table row now shows in red if battery reports "Low"
2018-12-06 Fixed thumbnail generation. Refactored/reused camera copy code
2018-12-14 Moved multiple camera errs to new function
2018-12-15 Added "timeout" value to stop transfers failing
    (It's a bit of a kludge I know).
    Also removed the "=" from --log-level, reflecting current Gunicorn syntax
2018-12-20 Fixed alignment bug with Apply button on mobiles
    Moved both buttons into the same <td> to address alignment issue on mobile devices, and for consistency with other pages.
2018-12-20 Added class=red when "No or unknown camera detected"
    (Consistent with other pages)
2018-12-20 Tightened HTML in the Select loops
    Removed unnecessary leading and trailing spaces
2018-12-22 Further tightening of HTML.
    Transfer's SELECT loops now align with the other pages.
2018-12-28 Changed focusmode to show red if != "Manual"
    Hard-coding these values might become a future problem for non-Canon cameras. Time will tell.
2019-01-01 Added new test for exposuremode = red + updated Exposure Comp 'select'
    Part 1 of 2: fixes bug where pressing Apply on the camera page when exposuremode = Manual triggers a camera error.
    (See related fix in intvlm8r.py)
2019-01-01 Changed camera POST request.form.get('exp') to test for None
    Part 2 of 2: fixes bug where pressing Apply on the camera page when exposuremode = Manual triggers a camera error.
    (See related fix in camera.html)
2019-01-01 Updated /intervalometer page:
    - Removed endHour <= startHour test (now permitting shoots wrapping around midnight)
    - Added camera query so as to add 'availableShots' to the template (for display of how many days' capacity the camera possesses)
2019-01-01 Added JS for display of shots/day & how many days' shooting in the camera
2019-01-02 Added JS to enable/disable the Preview & Apply buttons
    By default - assuming we have comm's with the camera - Preview is lit and Apply is grey.
    If you change any of the values, the buttons toggle: you need to Apply before you will be allowed to then Preview.
    Should you you reinstate ALL the values back to what they were before, the buttons revert.
2019-01-02 Added "None" tests to /Camera POST
    Added extra handling around null values that might come from the form when some of the "less than ideal" exposure modes are selected on the camera. These new tests discard them, where they previously raised a "Bad parameters" error result from the camera.
2019-01-06 Updated wb & expcomp to show "n/a" if invalid for currently-selected mode
2019-01-12 Restored hostname to the server_name list
    (I cut too deep in that last change)
2019-01-21 Added JS to light "Apply" button if changes are made to the form
2019-01-28 Added JS to light "Apply" button & reboot safe word
2019-02-14 "from flask_login" needed "current_user"
2019-02-14 Corrected broken button type
2019-02-14 Removed name from Login button - redundant
2019-04-25 Added 'Camera Transfer - Cron Job'
2019-04-25 Deleted, moving to /docs/ as pcb-assembly.md
2019-04-25 Updated names & links to new "docs/pcb-assembly.md" & "docs/case-assembly.md"
2019-04-28 Update and rename pcb-assembly.md to step4-pcb-assembly.md
2019-05-01 target=blank doesn't work on GitHub + added caps
    - Changed all link references from raw HTML back to MD.
    - added the 2 power supply smoothing caps.
2019-05-05 PCB v11.11 component overlay
2019-05-06 Added img of 4 x 2.5mm sockets
2019-05-08 Removed <p> tag showing Current PC time.
    Time now shows in the <div>
2019-05-09 Deleted temperature rows (now moved to thermals page)
2019-05-11 Completed styling the thermal radio buttons
2019-05-13 Refactored readstring values in thermal() and system()
    This keeps the temperature-related ones in sequence: 4, 5 & 6.
    WakePiTime was 5, moved to 7, so TempMin and TempMax can be 5 & 6 respectively
2019-05-13 Added name tags to the 2x reset buttons
2019-05-14 Deleted redundant Apply button
2019-05-18 Restyled radio buttons and checkbox.
2019-05-18 Added "nohook wpa_supplicant" to dhcpcd.conf
    Reference, here: https://www.raspberrypi.org/documentation/configuration/wireless/access-point.md
    (+ others).
2019-05-18 Restructured temperature handling
    Changed to a more efficient(?) 2-step approach:
    1) ask the Ard to update the temps, which is actioned in loop()
    2) request the new temps
    All of this is to ensure the Max/Min stored in EEPROM are accurate as of now. Without this there's a risk that the "now" temp will be higher/lower than those stored.
2019-05-18 Restructured Arduino temperature handling
    (Moved "WakePi" back to "5" as a result)
    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
2019-05-18 Fixed copy/paste bug in UpdateTempMinMax
    Was saving CurrentMax as Min
    [intervalometer.ino]
2019-05-19 Added test for camera's storage card
2019-05-24 Fixed md bugs + added PCB
2019-05-27 Standardised case on labels
2019-05-31 Last/Next shot now show "Unknown" if "19999" returned from Arduino
2019-06-04 v11.11 Circuit
2019-06-04 Delete intvlm8r_v11.11_circuit.pdf
    Wrong version of circuit
2019-06-10 Added Amazon link for the battery.
    + some MD fixups
2019-06-13 Added the 5.08mm/0.2" green plugs and sockets
2019-07-04 Added "-E" switch to sudo the script
2019-07-10 Added '-y' switch to 'apt-get subversion'
2019-07-10 Fixed wakePiTime display bug on the transfer page
    If the Arduino returned "Unknown", the message displayed "Un:00". By leaving it to default to 25, the code on the webpage suppresses display of the message.
2019-08-06 Added link to tested/supported cameras page
2019-08-14 Fixed some rogue indenting.
    (& a couple of missing semi-colons)
2019-08-18 Added text re the 7.5V regulator's value
2019-08-24 Updated prices
    - Lowered price for the PCB
    - Added US prices for 5.08mm plug/skt combo
2019-08-31 Added the -H switch to the script
    Resolves:
    The directory '/home/pi/.cache/pip/http' or its parent directory is not owned by the current user and the cache has been disabled. Please check the permissions and owner of that directory. If executing pip with sudo, you may want sudo's -H flag.
    The directory '/home/pi/.cache/pip' or its parent directory is not owned by the current user and caching wheels has been disabled. check the permissions and owner of that directory. If executing pip with sudo, you may want sudo's -H flag.
2019-08-31 Whoops: "setup.sh web" errs with -H switch
2019-09-08 Updated URL to /copyNow
    Resolves issue with cameraTransfer requiring login.
2019-09-09 Fixed getTime bug for cron job
    (Same issue as cameraTransfer)
2019-09-11 Added new 'View Log' and 'Clear Log' buttons + underlying JS
2019-09-11 Added handling for the Transfer page's 'View Log' & 'Clear Log' buttons
2019-09-15 Fixed int issue with piLastImage showing micro-seconds
    Thank you Anand S Kumar @ SO
    https://stackoverflow.com/questions/31487732/simple-way-to-drop-milliseconds-from-python-datetime-datetime-object
2019-09-15 Filtered .txt files out of what list_Pi_images returns
    Was picking up the "uploadedOK.txt" file created for the PiUpload process
2019-09-16 Added missing "-y" switch to apt-get install subversion
2019-10-02 Fixed broken Case Assembly link.
2019-10-08 Removed the prompt to create the CameraTransfer cron job.
    The cron job now runs at the top of every hour. It's up to the script to decide if it wants to copy or not.
2019-10-08 Updated to same structure as piTransfer.py
    - Now reads INI file before deciding if it's going to copy or not
    - INI can be overridden with "copyNow" switch from the command line
2019-10-08 Removed "copyNow" switch
    The script reads the INI file and the time to determine if it needs to upload or not.
2019-10-20 Reinstated copyNow switch
    Updated piTransfer.py to cater for this, with 2 nested IF tests:
    The first passes if we're OK to transfer today.
    The second passes - and we action a transfer - if copyNow is true *or* currentHour = copyHour.
    (This fixes a bug where copyHour is in the INI file but <> PiOnHour, we'll never copy - and PiOnHour isn't saved anywhere that the Pi can determine it, without asking the Arduino).
2019-10-20 Added 'copyNow' switch
2019-11-05 Added try/except around camera getTime code
    Page now reports "Unknown" if it can't decode the time and date, but still tries to read the other values.
    Previously it reported "No or unknown camera detected" error and no more values.
2019-11-05 /camera reports the Canon 7D's *UTC* time - but I don't like it.
    It seems to be calculating the timezone incorrectly: the reported time is (here in Oz) is 23 hours behind current, which is neither local time nor UTC/GMT.
    Leave it with me...
2019-12-25 Added test of PI_SHUTDOWN prior to removing its power
    Fixes bug #32
    [intervalometer.ino]
2019-12-30 Fixed broken doco link. Damn you to hell case-sensitivity!
2020-01-13 Corrected case of "configparser"
2020-01-26 Added test for i2c to test_install()
2020-01-26 Added port 8080 to point to the intvlm8r
    This links to these related changes:
    - moving the services (setTime and cameraTransfer) to call port 8080
    - deleting the default nginx website (which I had previously moved to port 8080 instead of deleting)
2020-02-17 Update step1-setup-the-Pi.md
    Swapped steps 12 & 13 as they were the wrong way around. (Assign hostname and setup wired/wifi.)
2020-02-17 Update SHOPPINGLIST.md
    Changed the choice of mounting bracket.
2020-03-10 Added delete files handling to copy_files(camera)
2020-04-04 Added folder parsing to the top 'switch' section
2020-05-15 added "install cachelib"
    "Note that as of werkzeug 1.0 SimpleCache was moved out to cachelib. So after doing pip install cachelib"...
    https://stackoverflow.com/questions/61445403/what-does-not-threadsafe-mean-using-simplecache-python-dictionary-cache-in
2020-07-05 Report 'n/a' image datestamp if no images on camera
    (previously blank)
2020-07-25 Removed <div container>
    <div container> was screwing up the thumbnails page.
2020-09-19 Deleted instruction to enable i2c
    (Now handled by the script)
2020-09-19 Added code to enable i2c
2020-10-05 Reinstated visible error in main() if ...
    photo2 throws anything OTHER than 'model not found' - as that's already being reported by 'unknown model, or no camera connected' error lower on the page.
2020-10-05 Added WC to /intervalometer + suppressed GP_ERROR_MODEL_NOT_FOUND
    (also suppressed on the /camera page)
2020-10-06 Re-worded the 'no camera detected' message
2020-10-31 Changed thumbs meta spacer char to "&bull;"
2020-10-31 Added "|safe" to accept new meta spacer of "&bull;"
2020-11-07 Updated 'WiFi' to 'Wireless LAN' to align with on-screen text
2020-11-07 Added 'i2cdetect -y 1' to the 'test' section
2020-11-07 Uncomment 'dtparam=i2c_arm=on' line
2020-11-09 Updated the Google steps to current
2020-11-16 Moved admin prompt up. Improves flow.
    Also added white-space before and after every interaction with the user.
2020-12-30 Added -E & -H switch references to the error msg
2021-01-02 Added case-insensitivity to "def login():"
    TECHNICALLY fixes the case-sensitivity issue in #59, but clarification of allowed characters & documentation is still to come.
2021-01-20 Cosmetic: moved 'start intvlm8r' for better on-screen flow.
2021-01-31 Make sure the LED's off when we take a photo
2021-01-31 Changing system time now resets Alarm2
    Closes bug #72
    [intervalometer.ino]
2021-02-01 Added test for resetArduinoFlag before going to sleep
    Closes bug #73
    [intervalometer.ino]
2021-02-03 Removed redundant 'wakeCameraFlag' in WakePi==true
    1) the camera will have gone back to sleep before the Pi is ready to transfer
    2) the transfer script already has its own WakePi step baked in
2021-02-09 Added more Serial.println to aid debugging
    (although commented-out in the released code)
2021-03-04 Updated circuit to DipTrace version
2021-03-07 Fixed error in copyNow when camera has no images
2021-03-08 Added "Timestamp" preface text in printTime()
    Debug aid, to help confirm the source of bad prints where only "::" is displayed on the serial monitor
2021-03-20 Changed the Uploads/Transfer options menu
    When upgrading, the Uploads/Transfer options menu now shows what's already installed.
    NB: de-selecting an option DOESN'T uninstall it.
2021-03-21 Relocated Arduino date/time + added Pi date/time
2021-03-21 Remove SetCameraTime button
2021-03-21 Added display of cameraDateTime
2021-03-21 Moved camera time to function GetCameraTimeAndDate
2021-03-21 Added displays of cameraDateTime to /system
2021-03-21 /Camera GET & POSTs now wake the camera on load
2021-03-22 Reformatted 'Current PC date/time'
    Now matches the Adruino, Pi and Camera date/time formats
2021-03-26 SetTime button only lights when checkbox(es) selected
2021-03-27 Removed syncdatetime option in setCameraTimeAndDate()
    I couldn't get this to work, nor find any doco's on it.
    The cameras I have here all use either 'datetimeutc' or 'datetimeutc'. (Famous last words?)
2021-03-28 If lens=Unknown, try creating from focallength
    Additional fix for Issue #53
2021-03-28 Added new mfr-specific handling to /camera GET page
    An improvement to yesterday's partial fixes for Issue #54.
    Also now sends the manufacturer to the page, allowing the page to return the name in a POST for correct handling of changes.
2021-03-28 Added hidden cameraMfr field to the form
    This is sent with each POST so the handling code can push the correct attribute names for the camera type
2021-03-28 Added mfr-specific handling to cameraPOST()
    Partly fixes Issue #54
2021-03-30 Corrected aperture name bug in Nikon /camera POST
2021-03-30 Added 'grey' background-color
    To be used for disabled options/selections (e.g. the /camera page)
2021-03-30 Improved the handling of 'read only' values in /camera POST
2021-03-30 All rows now show in grey if camera asleep
    (White balance's colour is handled in JS).
2021-04-01 Consolidated /camera POST to only 1 return path
2021-04-01 All* camera init's now use connectCamera()
    * copyNow(self) still to come
2021-04-01 Added 'if camera' test to the main page
2021-04-01 Added 'if camera' test to /camera GET
2021-04-01 Added 'if camera' test to /camera POST
2021-04-01 Added 'if camera' test to /intervalometer
2021-04-01 Added 'if camera' test to /system GET
2021-04-01 Added 'if camera' test to /system POST
2021-04-02 Added userFeedback call for the setDateTime button
2021-04-02 Added userFeedback call for the reboot button
2021-04-05 Fixed userFeedback call on the setDateTime button
2021-04-07 Added fileExtension to EXIF data captured
    (Will pay off when I de-dupe the thumbnails page - when the camera is set to capture a RAW *&* a JPG of the same image)
2021-04-07 Made createThumbFilename() case-insensitive
2021-04-09 getExifData now checks if image is already in thumbsInfoFile before adding ExifData
    - checks for matching filename and datestamp before continuing.
    - still to come: de-dupe. This is a low-profile issue as it will only occur if someone swaps out the memory card, resets/changes camera, or otherwise results in IMG names being reused.
2021-04-14 Added preview blocklist to /camera
    Closes #80
2021-04-14 Renamed previewButtonBlocklist => cameraPreviewBlocklist
2021-06-04 Updated case of default_image to ".JPG"
2021-06-04 Update setup.sh
    - Updated case of default image extension
    - Now copies the default thumb & info files into their correct locations
2021-06-10 Added calc & display of piDaysFree to the main page
    (How many days of shooting at the current interval settings does the Pi have the space for?)
2021-06-10 Added calc & display of cameraDaysFree to the main page
    (How many days of shooting at the current interval settings does the camera have the space for?)
2021-06-11 Moved camera model & lens from main to camera page
2021-06-11 Added display of camera model & lens info
    (Relocated from main page)
2021-06-11 Removed display of camera model & lens info
    (Relocated to the camera page)
2021-06-11 Fixed copy/paste bug in /camera
    (Legacy from move of camera model & lens to camera page)
2021-06-11 Changed "Days in camera" label to be definitive
    (no longer "estimated" - although no more accurate)
2021-06-13 NTP mode now syncs Pi->Arduino @ midnight
2021-06-13 Added setArduinoDateTime()
    Used for NTP sync from Pi --> Arduino.
2021-06-19 Suppressed red if cameraDaysFree = "Unknown" [Nikon]
2021-06-30 Minor tweaks to connectCamera()
    - improved speed (tightening loops)
    - improved performance (moving the camera & context declarations out of the loop)
2021-06-30 Create robots.txt
    In case your site happens to find itself open to the internet, at least Google and legit engines won't index it.
2021-06-30 Added fn norobots()
    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
2021-07-01 Improved handling of i2c failure in 'test'
2021-07-02 Refactored NTP into timeSync1+timeSync2
    Also adds new "time" switch, allowing the user to toggle NTP post-install
2021-07-04 Added grep filter to example query of syslog
2021-07-04 Added USB error detection (camera busy) to connectCamera
2021-07-04 Re-ordered .border classes
    (Out of radio button group)
2021-07-04 Moved copyNow button to immed beneath copy section
2021-07-04 Added TransferNow button immed beneath trn section
    + display/hide logic
2021-07-09 Removed indentation of i2c progress text
2021-07-11 Move heartbeat timer & service --> /systemd..
2021-07-11 Added 'import socket'
2021-07-15 Added Setup "Dead Man’s Snitch" text
2021-07-17 Commented out dev/test 'print' line
2021-07-19 Changed HbNow button to celery
2021-07-19 Added heartbeat.timer to 'test' list
2021-07-19 Deleted dev 'print' line
2021-07-20 Corrected wrong case in 'Url'
2021-07-25 Added transferNow() button handling
2021-08-01 Added first cut of commenceRsync
2021-08-08 Disabled 'Preview' button when shooting RAW
    Resolves issue #89
2021-08-09 Add camera_exit after USB error
2021-08-09 Grey out Copy button if rename values have been changed
2021-08-10 Fixed button interlocking logic error
2021-08-10 Added interlocking to the 'transfer now' button
2021-08-12 Prevented datetime reporting "unknown unknown" if Arduino offline
    /system page
2021-08-12 Corrected formatting bug when Arduino is offline/comms fail
2021-08-18 Refactored lightButtons to add buttons as vars
2021-09-01 Deleted the '-f' switch from ssh-copy-id
    Was potentially adding duplicate keys unnecessarily.
2021-09-08 Changed serial.print to serial.println
2021-09-11 Housekeeping: added "-F" macro to println strings
    Used to reduce RAM usage when debugging (when serial.println lines are active)
2021-09-11 Added text preface to temperature logging line
2021-09-13 Initialise VoltageString[] array on boot (clean & dirty)
2021-09-13 Respond to incoming == "6" with battery voltage readings
2021-09-13 Added initial battery code to /thermal
2021-09-13 Added battery table and initial content
2021-09-14 Changed voltage readings from char to byte
2021-09-14 Clamped valid voltage readings
2021-09-14 Sanity-check voltage readings coming from 'EEPROM'
2021-09-14 Repair broken memory location
    [intervalometer.ino]
2021-09-15 Strengthened batteryVoltage test/handling
2021-09-15 Removed earlier single voltage display
2021-09-15 Send 24 hours' worth of voltages to the page
2021-09-15 Removed display of a single voltage reading
2021-09-15 Initialise voltage array to '0V' on bad V read
2021-09-16 Added first cut of vm styling
2021-09-30 Standardised all camera exit calls to 'camera.exit()'
2021-10-10 Added WiFi power save mode to 'test' steps
2021-10-10 Disable WiFi power save mode
2021-10-10 Model "USB PTP Class Camera" now shows in orange
2021-10-11 Added tooltip when camera = "USB PTP Class Camera"
2021-10-13 Added fix for incorrect StartHour
    Fixes Issue #100
    [intervalometer.ino]
2021-10-13 Fixed(?) passing through midn when STM
    [intervalometer.ino]
2021-10-15 Fixed 2 incorrect uses of & instead of &&
    [intervalometer.ino]
2021-10-27 Removed premature camera.exit() in /home
2021-11-18 Replaced broken 'isnan' test with ValidateIncoming()
    [intervalometer.ino]
2021-11-18 Highlight in red if Pi or Arduino time is default
    (Most likely indicates the RTC backup battery is flat/absent & the board has lost power at some stage.)
2021-12-05 Specified use of a genuine battery coupler
2022-01-15 Updated eBay PCB link
2022-01-18 Added the PCB's dimensions
2022-01-30 Commented-out Serial.println lines left active
2022-01-31 Added display of Arduino version
2022-01-31 Added display of Arduino version (/system page)
2022-02-09 Corrected dev bug in 'arduinoVersion' query
2022-02-12 /thermal now queries the Arduino for 24x temps
2022-02-14 Disabled caching of arduinoVersion
2022-02-15 Added missing declaration of DailyTemps[25]
    [intervalometer.ino]
2022-02-15 Updated currentMin/Max & MEM to 1-byte width values
2022-02-15 Added "daily temperatures" table
2022-02-15 Removed call to ValidateIncoming in UpdateTempMinMax
    (No longer works following the change of temp values from int to int8_t)
    [intervalometer.ino]
2022-02-16 Added 'max' to suppress /0 error if Arduino misbehaves
2022-02-16 Added .negcount for negative temperature display
2022-02-19 Aligned 0 on temp & graticule
    0 on the temperature histogram now aligns with 0 on the graticule
2022-02-19 Removed rdun .timeline styling for small screens
    (Might need to be reinstated when the voltmeter functionality is added later on).
2022-02-26 refactored arduinoVersion to getArduinoVersion()
2022-02-27 standardised case + deleted (debug) log line
2022-02-27 More case standardisation
2022-02-27 Added a 'Back' button
2022-02-28 Suppress temps24 if arduinoVersion too old
2022-02-28 Added 'import traceback'
2022-07-08 Added new 'hidden' dev switch
2022-07-08 Added new 'hidden' dev switch (2)
2022-07-08 Added apt-daily timer & service to 'test'
2022-07-08 Cosmetic: changed some echo's to printf
    Lets me do automatic padding in the displayed output
2022-07-08 Block GVFS if found
    Addresses "gphoto2: Could not claim the USB device" error
2022-07-19 Updated i2cdetect for Bullseye
    Resolves #112.
    TODO: Check this doesn't break with earlier os versions.
2022-08-16 Tests for -E switch @ start of install_website
2022-08-19 Added udev rules for the camera
    TY: https://www.maskaravivek.com/post/how-to-control-and-capture-images-from-dslr-using-raspberry-pi/
2022-08-28 Updated i2cdetect test for Bullseye
    Fixes #112
2022-09-17 Corrected wrong debug line text
    [intervalometer.ino]
2022-09-18 Added note references to temperatures being signed bytes
2022-09-19 Improved reading/handling of RTC if ALARM==1
    Improved efficiency:
    - update RTC values once on entry, available to alarm1 and alarm2 handlers
    - removes need for rtc.getDay query in alarm1 handler
    - fixed bug in alarm1 where I was querying rtc.hour, but hadn't refreshed
    [intervalometer.ino]
2022-09-19 Added some more comments when setting alarm2
    I'd forgotten what I was doing here, and thought it was a bug! It's not.
    [intervalometer.ino]
2022-09-19 Rounded PiShutdownMinute up 1
    Only of any benefit at very short WakeDurations, which probably aren't realistic real-world scenarios anyway.
    [intervalometer.ino]
2022-09-19 Fixed conflict merge bug in system/arduinoVersion
2022-10-03 SetCameraTime now sync's to the Pi (if supported by the camera)
    This was always in Jim's example, but as I have discrete buttons for Arduino, Pi & camera I wanted to keep them separate.
    "Challenges" with setting my 60D's time has resulted in a change of heart.
2023-01-08 Refreshed eBay PCB links
2023-01-20 Changed default ArduinoVersion from None to '0'
    Previous code has started throwing packaging.version.InvalidVersion: Invalid version: 'None'
2023-01-29 Added Tindie "USB power switch"
2023-02-14 Replaced 'gpio-poweroff' for new builds
    Partly resolves Issue #130
2023-02-14 Updated 'gpio-poweroff' for existing builds
    Fully(?) resolves issue #130 - subject to extended soak-testing.
2023-03-30 Fixed minor (invisible) JS bug
    Only manifested when Arduino < 4.5.0 & daily temps graph wasn't rendered
2023-03-30 Changed tz case label to "hh:mm'
    I think 'hh:MM' is more technically correct - perhaps more from a code standpoint - but the difference in case jarred visually, and of course 'HH:MM' looked shouty.
2023-04-11 Added cameraTimeMode to /system
2023-04-11 Added cameraTimeMode to /system POST
2023-04-11 Updated var to 'cameraTimeMode' & added CHECKED handling
2023-04-12 Added cameraTimeMode to setCameraTimeAndDate
2023-04-12 Temporarily removed new gpio-poweroff/gpio-led code
    Needs more testing before release, and I want to push a new version out in the meantime.
    See https://github.com/greiginsydney/Intervalometerator/commit/c31d7f7967614b6a48a85745c761b3f7378caa97 & https://github.com/greiginsydney/Intervalometerator/commit/7ddb37f74671254b610aafa86fedbab38ac3956b
2023-04-14 Added text re the RTC & assembled PCBs
2023-04-16 Flashed messages now appear as SELECT/OPTION list
    - only if more than 1
    - sorted with errors first
    - de-duped
2023-04-19 Improved flashed msg de-dupe
    Previous code was sometimes building a SELECT with only 1 OPTION due to where the '| unique' was on the page
2023-05-14 Suppress inappropriate colour highlight
    Needed to do this as a result of subtracting "default_image" from the Pi image count, potentially leaving "n/a" as the same value for camera and Pi datestamps, thus triggering green 'equality' highlighting.
2023-05-21 Added print if error in Dropbox re-auth
    This error type previously only logged to the upload log file and gave no feedback to the user.
2023-05-27 First cut of rawpy installer
2023-06-01 Camera images now have their original timestamp
2023-06-01 Added 'extend' button
2023-06-01 Added /system POST 'extend' button handler
2023-06-05 Pasted battery table from vm branch
2023-06-05 Pasted /thermal battery code from vm branch
2023-06-05 Added initial voltage code from legacy vm branch
    Only initialises and reports default values.
    *The actual reading of voltages is not here yet*
2023-06-05 Voltage table hidden if voltageReadings not defined
2023-06-05 Added voltage templateData values to /thermal
2023-06-05 Aligned voltage limits
2023-06-05 Reordered voltmeter elements (more logically?)
2023-06-08 Moved voltage alarm thresholds into ini file
2023-06-08 Refactor dayTemp(Max/Min)At to mirror volt code
    - adds declaration of the var. (Untrapped code bug?)
2023-06-11 Remove voltage EEPROM. Add UpdateVoltage()
    (and related code)
2023-06-11 Added "Why can't I set the camera's time correctly?"
2023-06-18 Tweaked VM code
    - Commented-out the pin definition until the new VM hardware is finalised.
2023-06-18 Wrapped Volts24 in a 'try:'
2023-06-18 Skipped VM code if Arduino sends '255'
    The V_SENSE pin has not been defined
2023-06-18 Fixed error in #define
    Text editing error deleted the 'V_SENSE_PIN' name
    [intervalometer.ino]
2023-06-19 Revert change to 'shutting down in' visibility trigger
    Changed my mind. This can stay on-screen even if the Arduino doesn't support it.
2023-06-19 Improved tests for shutdownAt/In
    Added guard rails: Returned value needs to be between 0 and 61.
    Defaults to "Unknown" for in-page handling to take over.
2023-06-19 Window-dressing 'shutdownAt' value
    Removed the bonus minute added in the Arduino. This prevents on-screen confusion when time remaining is 1 minute > the value you just set.
2023-06-26 Corrected ADC conversion
    - /1024 now agrees with the data sheet.
    - the difference between 1023 & 1024 is largely 'noise' anyway.
    - LOTS of pages on the internet argue this.
    [intervalometer.ino]
2023-06-26 Changed rsync switch order
    old order was throwing:
    `/usr/bin/ssh-copy-id: ERROR: Too many arguments. Expecting a target hostname, got:`
2023-06-26 Changed rsync switch sequencing
    Was throwing
    /usr/bin/ssh-copy-id: ERROR: Too many arguments. Expecting a target hostname, got:
2023-07-15 Prevent sleep if shootFast is TRUE
    [intervalometer.ino]
2023-07-16 Only show shootFast if Arduino version OK
2023-08-12 Rejigged SetAlarm2 for "Shutting down in" display
    Things got complicated when wakePiDuration = 60 & I couldn't discern between shutting down "now" or shutting down in 60 minutes. I think this has resolved that.
    [intervalometer.ino]
2023-08-12 Corrected PiShutdownMinute value
    + some whitespace work
    [intervalometer.ino]
2023-08-13 Refreshed eBay PCB link
2023-08-15 Fixed flubbed logging line
    [intervalometer.ino]
2023-08-15 Fixed problem with missed vm reads
    Arduino was going to sleep before it had finished a Vread cycle
    [intervalometer.ino]
2023-08-16 Resolved alarm2 timing bugs
    [intervalometer.ino]
2023-08-30 Fixed row not showing in red when cameraBattery == "Low"
2023-09-05 Added first cut of new /network page
2023-09-05 Updated voltmeter array initialisation
2023-10-04 Changed cameraTime to 5 options
    One of them has to work!
2023-10-04 Updated /system GET page to 5 different camera time options
2023-10-04 Updated /system POST page for 5 x cameraTime options
2023-10-04 Fixed 'f' print format bugs just introduced
2023-10-04 Deleted bad ELSE in cameraTimeMode
2023-10-13 Updated eBay links for the PCB
2023-10-17 Revert changes to camera time options
    Moving this to the next release.
2023-10-17 Revert changes to camera time mode
    Moving to next release.
2023-10-25 Refactored submit button tests to switch
    + Added new values for 'wake camera' and 'clear log'
2023-10-25 Changed form sub from GET to POST
    + Changed 'value' on the wake button to be more descriptive.
2023-10-26 Changed main form sub method to POST
    (So the progress message will update with 'wake the camera')
2023-10-26 Removed rdun GET args test in /camera
2023-10-26 Restructured /camera POST page
    - 'wake' attempts wake and return.
    - All other posted values try to connect to the camera and action appropriately.
2023-10-26 Changed Clear Log button onclick/value/action
    - Now posts to progress table when pressed.
2023-10-28 Updated remoteit switch functionality
    (This code also runs when 'web' runs)
    Resolves Bug #144
2023-10-29 Added <br> at bottom of page (remote.it)
    Jacks the bottom of the page up by a line, so any 'Submit' button at the bottom is less likely to foul any overlaid navigation arrows.
2023-12-08 Reformatted some Serial.println
2023-12-08 sync SetAlarm2(bool reset) from Master
    (shootFast branched off an earlier version. This manual realignment will make my PR a little easier.)
    [intervalometer.ino]
2023-12-08 Ensured all basic println cmds use "F"
    (for improved memory management).
    Also commented-out some println cmds still active.
2023-12-15 Case sensitivity will be the death of me
2023-12-16 Changed lingering camera GETs to POSTs
2023-12-16 Updated JS to new names & case
2024-01-06 Trapped i2cdetect errors in /test
2024-01-06 first cut of SSID detection under bookworm
    Currently flawed: only reports the CONNECTED ssid, not the one CONFIGURED.
2024-01-06 Added a helpful prompt if i2cdetect failed
2024-01-06 Force rawpy installation OFF
    Rawpy install currently fails. I either fix this or need to replace it. The absence of it breaks /thumbnails, and has a minor impact on the default image on the /home page.
    The main script has been edited already to step around this absence.
2024-01-06 Updated celery run path
    "Line references path below legacy directory /var/run/, updating /var/run/celery → /run/celery; please update the tmpfiles.d/ drop-in file accordingly."
    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
2024-01-07 refactor sfWarning display JS
    (This fix prevents it incorrectly displaying when the Arduino doesn't respond / value is "Unknown")
2024-01-08 Add '-U- switch to celery'
2024-01-08 Add '-U' switch to dropbox
2024-01-09 Removed pip '-U' switches
    'start' shouldn't upgrade all libraries without specific consent.
    I plan to add a separate "upgrade" switch.
2024-01-16 Neatened display of Arduino datetime (1)
    Edge case. Only visible when RTC is faulty/missing
2024-01-16 Neatened display of Arduino datetime (2)
    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
2024-01-17 Moved thumbsCreated initialisation earlier
    Resolves edge case where it's referenced but not defined
2024-01-30 Moved declar8n of $I2CTEST to venv_test
2024-01-31 First cut of unmake_ap_nmcli
2024-01-31 First cut of make_ap_nmcli
2024-02-02 First cut of wifi tests
2024-02-03 Final first cut of b/w wifi tests
2024-03-17 Aligned logic structure with cameraTransfer
2024-03-18 Had pasted too many open brackets. Corrected.
2024-03-20 Initial cut of 'cameraUsb' mode
2024-03-27 Added cameraTimeMode options
2024-03-27 Updated setCameraTimeAndDate
    Now lets you specify the method to use (provided it's supported by the camera).
2024-03-27 Completed cameraTimeMode SELECTED+DISABLED
2024-03-27 Updated cameraTimeMode in /camera POST
2024-03-27 Added flash if set camera datetime fails
2024-03-28 *incomplete* camera USB mode
2024-03-29 Improving camera USB display logic
2024-03-30 completed camera usb logic
2024-03-30 Completed mods to /camera GET
2024-03-30 Completed mods to /camera POST
2024-03-30 Completed mods to /main for cameraUSB
2024-03-30 cleaned up cameraTimeMode cookie bug
2024-03-30 changed 4th camera overload to true/false
2024-03-30 Suppress cameraTime in /system (usbmode)
2024-03-31 Revert TRN chaining on copyNow *button*
    (and fix having broken async in editing)
2024-04-01 Delete debug echo msg
    (Was printing old Wifi pwd!)
2024-04-15 Suppress camera time options if camer didn't respond
    (as distinct from "camera USB disabled")
2024-04-17 Abort transfer if cameraUsb is False
2024-04-17 copyNowCronJob aborts if cameraUsb = 0
    (This code should never run because there's already a Usb test in cameraTransfer.py)
2024-04-18 Added isUserLocal [incomplete]
    Aborts ap and noap (*on bookworm*) if the connected user's session has an IP address, making it either a wired session OR wireless. (If wireless you'll be disconnected during the delete/add network steps, leaving you high and dry).
    Only a local (direct-connect) to the Pi will succeed at this stage.
2024-04-18 Updated 'test' to filter on wlan0
2024-04-20 Log 'chained' trn to PI_TRANSFER_FILE
2024-04-21 Temp removed imageio
    Install currently fails:
    ERROR: THESE PACKAGES DO NOT MATCH THE HASHES FROM THE REQUIREMENTS FILE. If you have updated the package versions, please update the hashes. Otherwise, examine the package contents carefully; someone may have tampered with them.
    numpy from https://www.piwheels.org/simple/numpy/numpy-1.26.4-cp311-cp311-linux_armv7l.whl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 (from imageio):
    Expected sha256 81a37a6d46f316f63b79f58865068410ff7a9e6bc37555c7600f1f608d7872fc
    Got c32a3e5ee644a22a111186883e9b2f7f9ebd6312b8bc076d66a0b24307f2fed9
2024-05-25 Added checkForEmptyValues()
    Won't let you Submit if any of the values are empty.
    (Addresses rare first-run edge case in the Arduino, but a good-to-have in code regardless)
2024-09-17 Added powersave disable in ap / hotspot mode
2024-09-17 Added powersave disable to unmake_ap_nmcli()
2025-07-04 web step now disables wifi powersave using nmcli if detected
    Reverts to iw and rc.local otherwise.
2025-07-04 test step reports nmcli wifi power save values if network-manager installed
2026-07-06 Refactor setup.sh to use USER_HOME for paths
    Removes previous need for -E and -H switches for the various install steps.
2026-07-07 Removed the '-E' setup switch
2026-07-07 Removed the '-E' & '-H' setup switches
2026-07-10 Handles new Canon image format values
    Added to Nikon as well, purely because we're now sending a tuple to the page for translation and I wanted the same handling in the template file regardless of camera type
2026-07-11 Fix conditional checks for apt-daily timer & service
    Was previously flawed: test would always report false due to the -q flag
2026-07-11 Replaced remaining hard-coded 'config.txt' locations
    Should be $I2CPath to cater for changes in bookworm and trixie
2026-07-11 Add missing 'printf' in gvfs executable check
2026-09-01 Removed reference to the '-E' setup switch
2026-09-01 Removed legacy reference to old switches
    Clarify instructions for running the setup script with critical switches.
