greiginsydney/Intervalometerator/(notices)

Notices in the files:
Arduino/intervalometer.ino/intervalometer.ino:
This program is free software: you can redistribute it and/or modify it under the terms of the GNU General Public License
